partypancake8/froggy-control/motor/schematic-img/cl57t-v41-photo.jpg

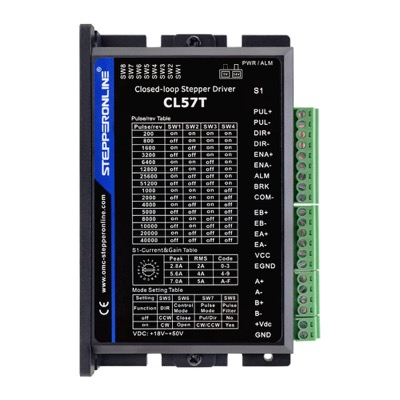
motor/schematic-img/cl57t-v41-photo.jpg
