partypancake8/froggy-control/model/exports/camsim/montage.png

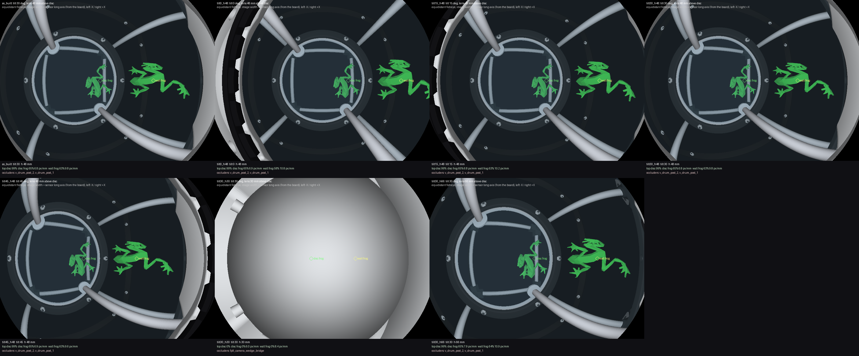
model/exports/camsim/montage.png
