partypancake8/froggy-control/model/cad/docs/ICD-V12.5.md

# Froggy V12.5 interface control addendum

2026-11-01. `assemblies/froggy_v12_5.py` is V12 (`froggy_v12.py`, frozen at 6105f2d) plus two items. Every row of
[ICD-V12.md](ICD-V12.md) stands except the ones below. Supersedes the S1.1 / S1.2 motor plate rows (6061 6 mm plate
64 x 120, Z -23..-17, M5 x 40 spacer bolts, motor face Z -23) and the S1.27 support block row ("Support": side guards,
"print bottom flat on bed"). Intents: I037 (slab), I038 (gusset).

| Interface | Nominal definition, mm |
| --- | --- |
| S1.2-V12.5 motor plate slab (I037) | `fp9_motor_plate`, PETG, one uniform 12 mm slab, Z -32..-20, 114 x 120 (X -57..57, Y -60..60): the aluminium plate's 64 x 120 footprint plus four tabs to X +-57 at Y +-(38..60). Top face Z -20 = the cross rails' underside, so the tabs bear flush on the rails. Motor pocket from below, Z -32..-25.5 (6.5 deep), X +-22.5, -Y wall Y 6.0, open past Y 60 (motor body 42.3 square + travel C 28.5..30.5 + 1.35 clearance); keyhole X +-12 into the 24 spindle hole. Every aluminium-plate opening kept: 24 spindle hole (0, 0), I035 belt channel 20 wide (X +-10, Y 0..30) with R 2 cusps, 24 pilot slot (0, 30) Y -1.5..+0.5, four 3.4 motor slots on the 31 square, four 5.5 spacer holes (+-21, +1), (+-21, -45), four 5.5 x 7 tab slots along X at (+-45, +-48). No lightening cuts, no supports. Mass 115.4 g at 100 % infill (90886 mm3 x 1.27); Bambu P2S slice 110.2 g, 2.6 h, 0 warnings. |
| Motor drop (I037) | MOTOR_DROP 2.5: motor face Z -25.5 (V12 -23.0), roof over the motor flange 5.5. Motor pulley NOT moved: Z -17.5..-1.5, its top flush with the shaft tip -25.5 + 24 = -1.5 (asserted in the build). Belt plane BD.BELT_Z -13.0 unchanged. D flat Z -16.5..-1.5 (shaft STEP), grub axis Z -5.0, 3.5 to the flat's tip end. |
| S1.1-V12.5 spacer stack | Plate A 6 + RAF 20 mm spacer + stock aluminium spacer 5 ID / 10 OD / 3 (the ICD-V12 deck hardpoint part, Filastruder; four, Z -20..-17) + slab 12 = grip 41. M5 x 50 ISO 4762 SHCS down from plate A, DIN985 nyloc 5 under the slab, 4 proud. |
| S1.33 slab tabs (new) | Four M5 x 18 ISO 7380 BHCS up through the 12 mm tab slots into 2020 drop-in T-nuts in the cross rails' bottom slots at (+-45, +-48); 4.9 into the T-nut (x 16 gives 2.9, under the 3.0 the joint check needs). |
| S1.2-V12.5 motor screws | Four M3 x 10 SHCS + 0.5 washer from the slab top (Z -20) through the 5.5 roof: 4.0 engaged in the 4.5 deep motor holes (x 12 gives 6.0, too long). |
| I035 belt clearance | BRepExtrema belt to slab 5.125 at C 28.5 / 30.0 / 30.5 (>= 3.0 asserted in the build). Motor body to pocket 1.35; lower spindle stack to slab 5.27; pilot boss to the 24 slot 0.27 (the aluminium plate's geometry). |
| Slab print | Z -20 top face DOWN on the bed (print_rotate 180 about X), pocket opening up; every face vertical or horizontal; 100 % infill PETG prototype, 3 walls. |
| Slab install | From inside the plinth, bottom panel off, after the cartridge is in the deck: at 114 wide the slab does not pass the 66 x 126 deck opening. 3 mm spacers on the hanging M5 x 50, slab + motor up, motor pulley into the belt loop, nylocs, tab screws, tension, M3 screws. |
| S1.27-V12.5 support block, gusset A (I038) | `fp12_roller_block` x 3 (print wrapper `parts/fp9_roller_block.py`). Envelope unchanged: block-local r 67.0..99.5, t +-17, Z 0..41 (world = local + 9). Base 4, outboard wall r 95.5..99.5 to world Z 50, R 1.5 top. Side guards replaced by two triangular gussets, t +-13.05..17 (4 thick, outer face flush with the base side): R 5 foot cove leaves the base top at r 71.0, straight hypotenuse lands at r 73.64 and meets the wall's inboard face at local Z 36.0 (55.7 deg), R 5 cove onto the wall. Coves: R 5 outboard wall to base, R 5 gusset inner face to base r 83..95.5 (run out R 5 -> 0 over r 83..78, >= 1.5 off the M4 heads' 7 OD), R 3 vertical gusset / wall corners, R 1 gusset top edges and the flush outline. Slot (centre Z 32.95 +- 2, 5.4 wide), M4 holes (r 76, t +-8) and wall top unchanged. Disc clearance 2.5 (gusset 2.916), tread clearance 1.0, slot margin above 12.35. Root section 444.4 mm2 (371.9 before, 1.19x). Mass 15.1 g. |
| Support block print (I038) | On its BACK: the outboard wall's r 99.5 face on the bed (one planar face, 1155 mm2), layers stack along r; no downward gusset face (0.0 deg overhang); only the two M4 holes bridge. Bambu P2S PETG, 3 walls, 25 % infill, supports off: 10.0 g, 38 min, 0 warnings. |
| Support block fasteners | Unchanged: 2 x M4 x 16 SHCS + DIN985 to plate A per block; M5 x 25 axle, head outboard. The M4 heads are 1.55 from the gusset inner face, so the gusset root beside them stays sharp (punch list). |
