partypancake8/froggy-control/model/cad/docs/ICD-V12.md

# V12 frame and flat-tread rim supports

2026-10-26. Supersedes S1.27/S1.28 and deck mounting stack; all V11 spindle and belt datums retained except S1.5, S1.6 and the belt plane, which spindle fix A (2026-10-28, I033) replaces below. Sawyer confirmed standard Ender wheels and supports using the flat outer running face. Motor family is confirmed 17HS19; exact encoder suffix remains to be checked.

| Interface | Nominal definition, mm |
| --- | --- |
| Wheel | Official Creality Ender-3 Rollers.step: POM wheel OD 24.10, plastic width 10.20, flat tread width 6.10. Two official 625pillow.step bearings, 5 ID / 16 OD / 5 width, centers +/-3 along axle; official 5 ID / 10 OD / 1 internal shim. Complete kit width 11. Purchase standard 4001070002 or dimensionally matching assembled wheel; current catalogue says D24 x 10.24, so incoming measurement is required. |
| Contact | Three horizontal radial axles at radius 89, azimuths 90/210/330 degrees, axle Z 32.95. Flat outer tread touches disc underside Z45 across radial band 85.95..92.05; disc edge R93 leaves 0.95 radial margin. V shoulders and wheel side faces are not contact surfaces. |
| Axle clamp | M5x25 ISO4762 screw, head outboard. 4 mm support wall + 1 mm precision washer + 11 mm assembled wheel + 1 mm precision washer + 5 mm DIN985 nyloc. Nominal 3 mm bolt protrusion. Washers 5 ID/10 OD/1, two per wheel, additional to the internal shim. Clamp inner races, not the POM body. |
| Support | PETG support base R67..99.5, width34, base4, wall4. Slot width5.4; center travel Z30.95..34.95. Side guards begin at +/-13.05, giving 1 mm nominal tread clearance. Existing 2xM4x16/nyloc mounting pattern (R76,t+/-8) retained. Print bottom flat on bed. Light stabilization contact only; load capacity and creep not qualified. |
| Adjustment | Axle screw removed for wheel insertion. Remove carrier to use full slot travel; above nominal, wheel intentionally intersects installed disc. Working setting is just contact with no forced preload. Verify free spin while holding nut during tightening. |
| Carrier countersinks | Four M4 hub screws use 90 degree included countersinks, 8.96 mm theoretical maximum top diameter over 4.5 mm clearance bore, maximum depth 2.23 mm from Z51. This supersedes the inherited 80 degree PETG-era recess. Model the supplier maximum head envelope: 8.96 mm theoretical diameter, 2.48 mm head depth, 2.5 mm socket. Finish the countersink to the actual supplied head flush, up to this maximum; smaller heads must not be sunk blindly to the maximum. Source: Accu SSK-M4-12-A2. |
| Metal hardpoints | Twelve stock 5 ID/10 OD/3 aluminum spacers replace acrylic in clamp paths: four under plate A, eight under corner clamp tabs. Plate/tab entire footprints relieved from deck skin with >=0.5 nominal planar clearance, retaining Z0..3 spacer and Z3 plate datum. Existing M5x14 screws retained. Plate A relief may join existing center opening; acrylic remains a nonstructural skin. |
| S1.5-V12 block fasteners | 2026-10-28, fix A (I033), supersedes S1.5 / interface-risks row 9. goBILDA 1614 to plate A: 4 x M4 x 12 ISO 7380 button head up from under plate A at (+-8, +-8), **no washers on either face** (a 9 OD washer under a head reaches r 6.81 and lifts the block 0.8). The block's M4 holes are tapped through its 16 length; 6 engaged. Heads Z 0.8..3.0 on r 11.31 (head 7.6 OD, inner edge r 7.51). BRepExtrema head gap to the nearest rotating solid, each rotating part swept 360 deg in 15 deg steps: 2.014 for all four (nearest: the top race shim, r 5.5, Z 2..3); the REX pulley hub top (Z -0.5) is further. Rule: FHCS/SHCS only if a button head comes within 1.0 of anything rotating. Never longer than M4 x 22 (the through tap lets the tip reach the hub clamp at Z 25.6). |
| S1.6-V12 shaft retention | 2026-10-28, fix A (I033), supersedes S1.6a/b/c-V11 / interface-risks rows 2, 4, 5, 17b, 17c. The 2920 collar is dropped from the model and the BOM. Block captured between the hub boss (Z 25, upper inner race) and a spacer column on the lower inner race: goBILDA 1522-0010-0060 race spacer (8.05 ID x 9.95 OD x 6.00) Z 3..9, through plate A's 16 hole with 3.0 radial clearance, then shim_count_nominal = 3 x goBILDA 2807-0811-1000 (8.00 x 11.0 x 1.00) Z 0..3, then the 3422 REX pulley hub up Z -18..0 whose two M5 set screws (axis Z -5.0, holes Z -7.5..-2.5, 8.0 below plate A's underside) are the lower axial stop. Shim rule: measure then choose. The set screws and the hub pinch bolts are tightened on the bench: in the deck the 2020 rails (Z -20..0) block every horizontal key approach at Z -5 (ray test, 36 azimuths). Shaft 72.00 at Z -24.8..47.2, 0.2 (0.1..0.3) proud of the hub pilot so the top washer (Z 47.2..48.2) bears on the shaft only. Lower backup: second 1522 at Z -24.8..-18.8 on the lower 12 OD washer (Z -25.8..-24.8), 0.8 under the pulley, never clamped; the former 2807 backup shim no longer fits and is dropped. Remove the factory e-clip before assembly: its groove (Z -21.6..-20.8) sits inside the backup spacer's 8.05 bore, and a fitted 12.3 OD clip would stop the spacer. |
| Spindle stack (fix A) | Bottom to top, Z from..to (height source): M4 x 8 BHCS + 12 OD washer -25.8..-24.8 (ISO 7093, off the shaft end); 1522 backup spacer -24.8..-18.8 (6.00 STEP); gap -18.8..-18.0 (0.8); 3422 REX pulley -18.0..0.0 (18.0 STEP, hub up, tooth band -16.5..-9.5, groove centre -13.0, set screws -5.0); 3 x 2807 shim 0.0..3.0 (1.00 STEP each); 1522 race spacer 3.0..9.0 (6.00 STEP; plate A is 3..9); 1614 block 9.0..25.0 (16.0 STEP; inner races at its end faces); 1313 hub 25.0..47.0 (22.0 STEP, pilot top 47.0); shaft proud 47.0..47.2; upper washer 47.2..48.2 and M4 x 8 BHCS head to 50.4 (carrier top 51). Sum on the shaft: 6 + 0.8 + 18 + 3 + 6 + 16 + 22 + 0.2 = 72.0. Belt plane Z -13.0 (was -12.75). Motor pulley slid 0.25 down on the 5 mm D shaft to Z -17.5..-1.5, grub axis Z -5.0 on the D flat Z -14..+1 (7.5 below and 4.5 above the M3 thread); centre distance 30.0 and the motor plate slots unchanged; tension travel only +1.0 belt path. Motor turned 180 deg about its axis: lead glands face +Y, away from the lower end screw. |
| S1.23-V12 LED driver | 2026-10-28, intent I034 (follows I032), supersedes ICD.md S1.23. REMOVED: v_led_driver (IR LED driver board), its two M2.5 x 6 F-F standoffs (v_drv_standoff_m2p5_1/_2), the two M2.5 x 10 SHCS (j_s1_23_driver_standoff_1/_2) and the carrier disc's two dedicated 2.7 holes at (0, -48 +- 9.5). The Pi's four 2.7 holes (S1.18) stay. Rotor CG offset from the build's mass properties: 0.05 mm before, 0.11 mm after (turning mass 1.535 -> 1.530 kg); no rebalance needed, S1.19 bank position unchanged. |
| S1.29 LED ring | 2026-10-28, intent I032, supersedes ICD.md S1.29 (Spinel IRXS10 850 nm IR ring removed). v_led_ring_ws2812: WS2812B 16 x 5050 white ring, Adafruit NeoPixel Ring 16 footprint, board 44.45 OD / 31.75 hole / 1.6, LEDs 5.0 x 5.0 x 1.7 on r 19 (3.3 overall), read from the vendor STEP (vendor/electronics/ws2812_ring_16, Adafruit_CAD_Parts, MIT); bought part: Amazon Sparkleiot 5 pack B0C77XPKSL (45 OD, 32 hole, same footprint) or Stemedu B0BY8Z9L92. Coaxial with the UC-261 lens, LEDs along the optical axis, board underside 4.3 in front of the camera board underside (the IR board's plane); the 14 lens barrel passes the 31.75 hole. On fp9_camera_wedge_bridge: collar recess 45.0 dia x 3.3 deep (was 52.4 x 3.5), 5050 tops flush with the collar top, 57 square collar, 37 square camera pocket, 25 wide ribbon slot on +Y and 3 silicone dots unchanged. Electrical (I034): 3 wires straight to the Pi, no driver board: ring 5 V to the Pi 5 V pin, GND to Pi GND, DIN from GPIO18 (PWM) through a 74AHCT125 level shifter (3.3 V to 5 V) and a 330 ohm series resistor at DIN, with 1000 uF across 5 V / GND at the ring; the 74AHCT125, resistor and capacitor are a wiring note mounted on the Pi side, not modelled (Adafruit 1787 is the bare DIP chip, no breakout STEP in Adafruit_CAD_Parts). About 290 mA white with brightness capped near 30 % (full white up to 960 mA). Must not occlude the top disc or the frogs in camsim. |
| S1.10-V12 drum tube | 2026-10-28, intent I036, supersedes the tube numbers in ICD.md S1.9 to S1.12 and S1.32 (rows updated in place). s_drum_tube: Rebower clear cast acrylic 145 ID x 150 OD x 14 in (Amazon), 150.0 OD x 2.5 wall, bore 145.0, cut to TUBE_H 140 (unchanged; one tube gives two cuts); replaces the 152.4 x 3.2 Plastic-Craft tube, unavailable. OD tolerance unknown: measure the OD on arrival, then print both seats at measured OD + 0.6 (0.3 radial). fp9_tube_seat_bottom r 75.3..90 x 6 and fp9_tube_seat_top r 75.3..93 x 6, both bores 150.6 (were 153.0), outer sizes, heights and the r 83 hole circle unchanged (bottom seat wall between bore and counterbore now 3.7, was 2.5). lp_ring_b ID 144 (was 146): the tube foot r 72.5..75 sits fully on aluminium; the switch nut (r 70.6) and port nut (r 70.2) stay inside the bore; lobes and post holes unchanged. lp_ring_top bezel ID 147 unchanged (sized by the 9.5 hole margin, not the tube). Drum posts r 66, body r 61..71: 1.5 clear of the bore r 72.5 (was 2.0). Wall-frog placeholder follows the outer wall (r 75.0 + 0.3). Camsim as built: top disc 0.987, disc frog 0.649, wall frog 0.631 (unchanged to 3 places). |
| Rotor power budget | 2026-10-28, I034: 400 mA Pi Zero 2 W (Wi-Fi streaming) + 150 mA UC-261 camera + 300 mA WS2812 ring allowance = 850 mA at 5 V (4.25 W) from the 19.24 Wh Anker 321 at 85 % conversion, about 3.8 h. No 12 V rail and no boost on the rotor. |

Sources: [official wheel CAD](https://github.com/Creality3DPrinting/Ender-3/tree/88c7758cea9d0d00a54fdb238bedb3b33425f409/Ender-3%20Mechanical); [Creality kit](https://mvip.creality.com/en/goods/goodsDetail/840); [metal spacers, packs of five](https://www.filastruder.com/products/m5-spacers-3mm-tall-10mm-od).

The wheel STEP is manufacturer design evidence, not certification that every generic Ender wheel matches. The two bearing inner faces must seat on the 1 mm internal shim without locking the wheel. Finite tread width produces differential sliding on a rotating disc: inspect heat/wear after low-speed unloaded testing. Motor pulley details, load ratings, frame profile compatibility, belt tension, actual tolerances, print strength, and assembled runout remain physical qualification items.
