partypancake8/froggy-control/model/exports/camera_view.png

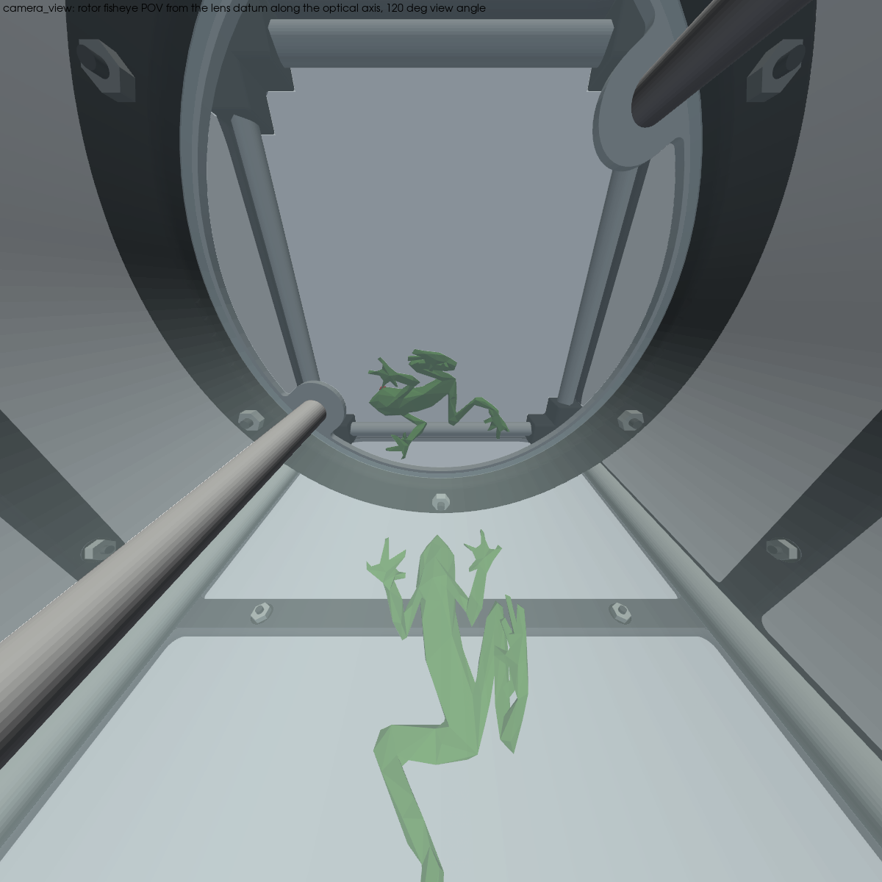
model/exports/camera_view.png
