partypancake8/froggy-control/model/exports/camsim/as_built.png

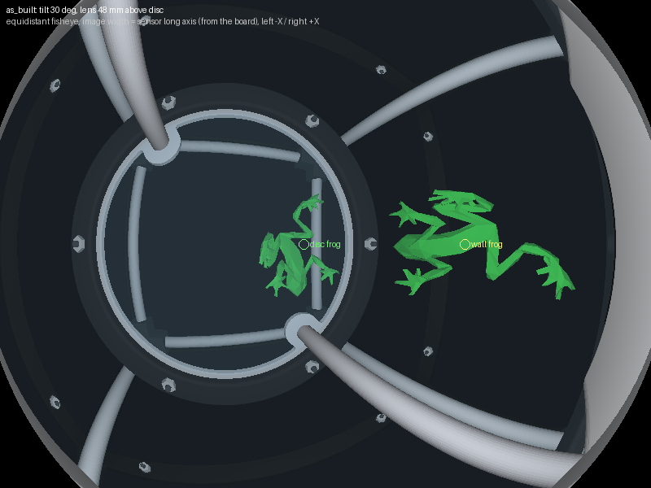
model/exports/camsim/as_built.png
