partypancake8/froggy-control/model/exports/camsim/as_built_labels.png

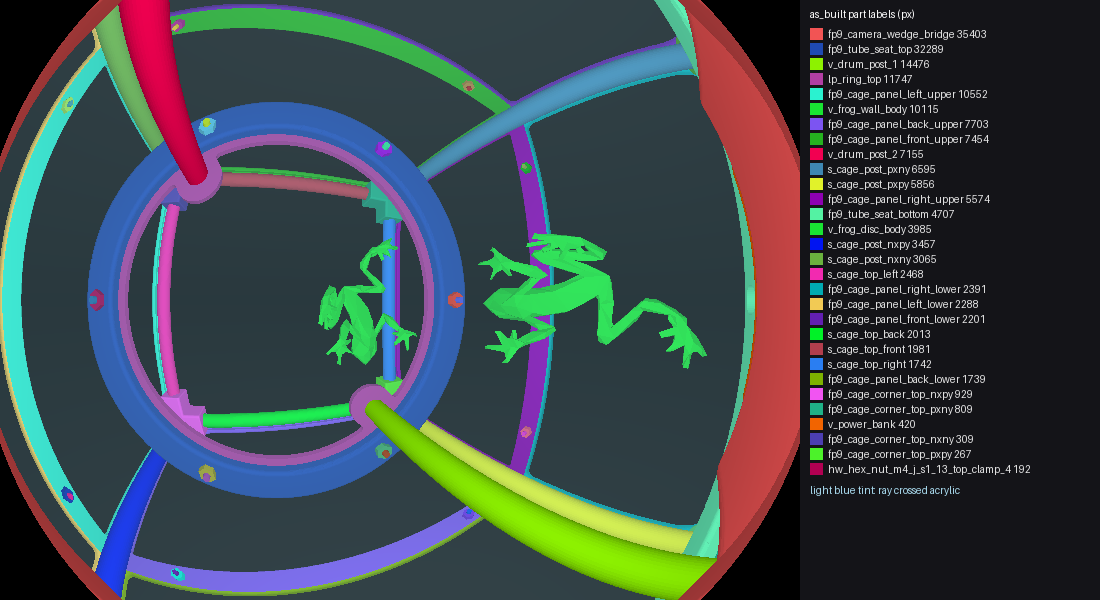
model/exports/camsim/as_built_labels.png
