partypancake8/froggy-control/model/exports/camsim/tilt0_h48.png

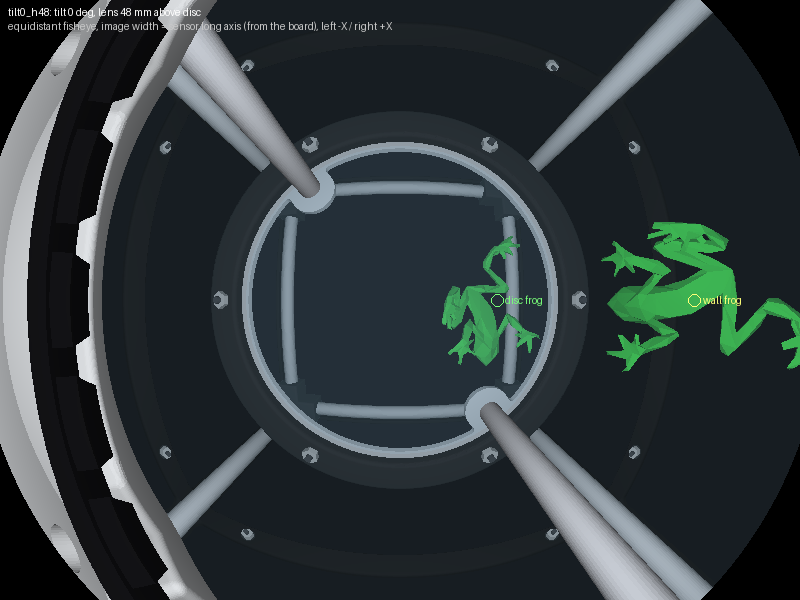
model/exports/camsim/tilt0_h48.png
