partypancake8/froggy-control/model/exports/camsim/tilt15_h48.png

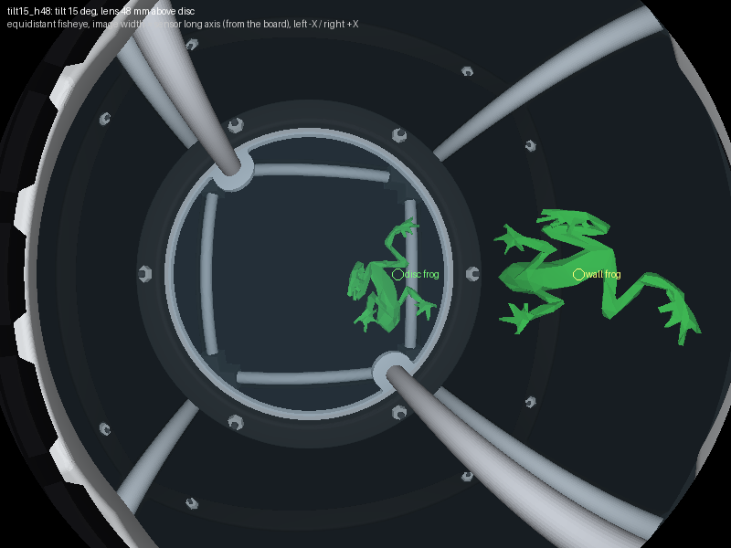
model/exports/camsim/tilt15_h48.png
