partypancake8/froggy-control/model/exports/camsim/tilt15_h48_labels.png

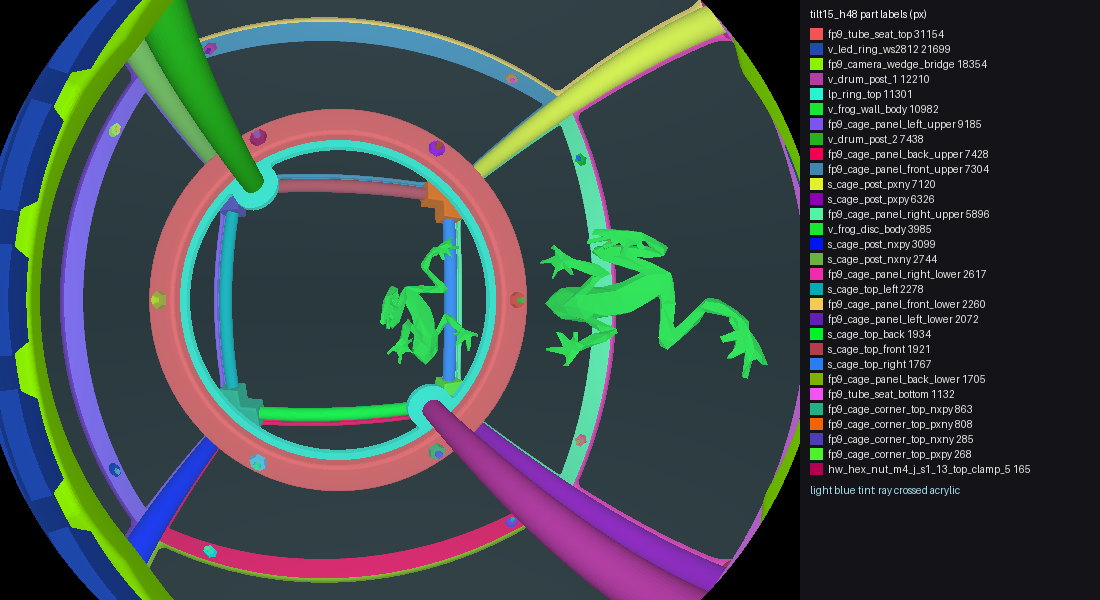
model/exports/camsim/tilt15_h48_labels.png
