partypancake8/froggy-control/model/exports/camsim/tilt30_h30.png

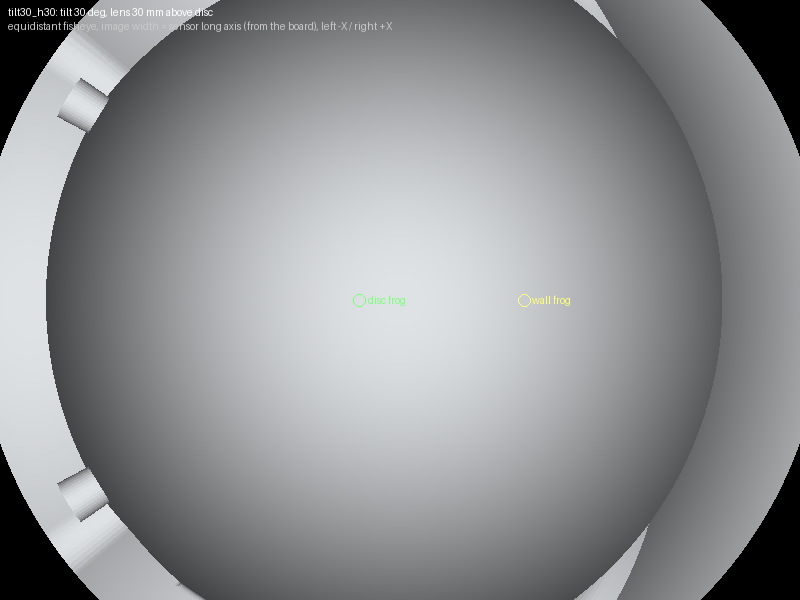
model/exports/camsim/tilt30_h30.png
