partypancake8/froggy-control/model/exports/camsim/tilt30_h30_labels.png

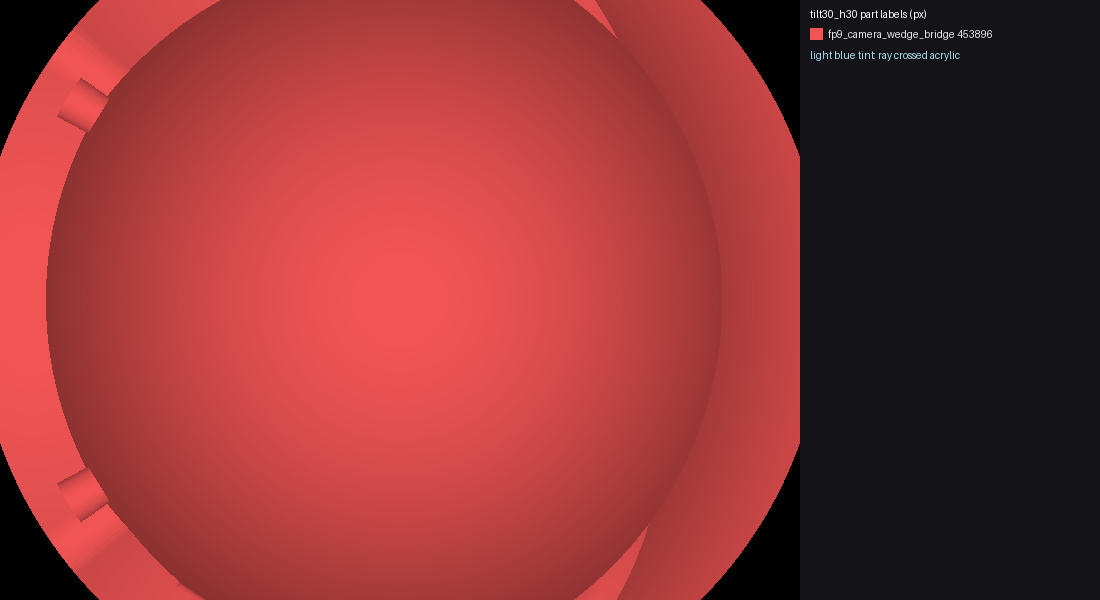
model/exports/camsim/tilt30_h30_labels.png
