partypancake8/froggy-control/model/exports/camsim/tilt30_h66.png

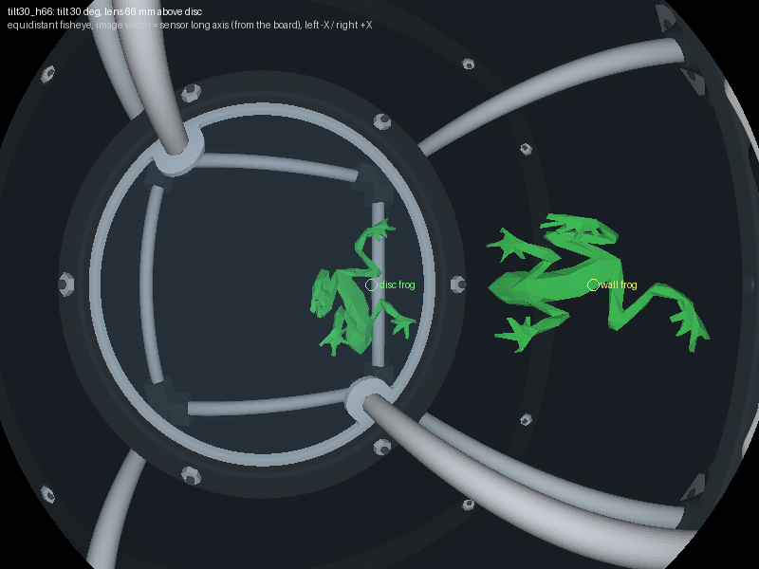
model/exports/camsim/tilt30_h66.png
