partypancake8/froggy-control/model/exports/camsim/tilt30_h66_labels.png

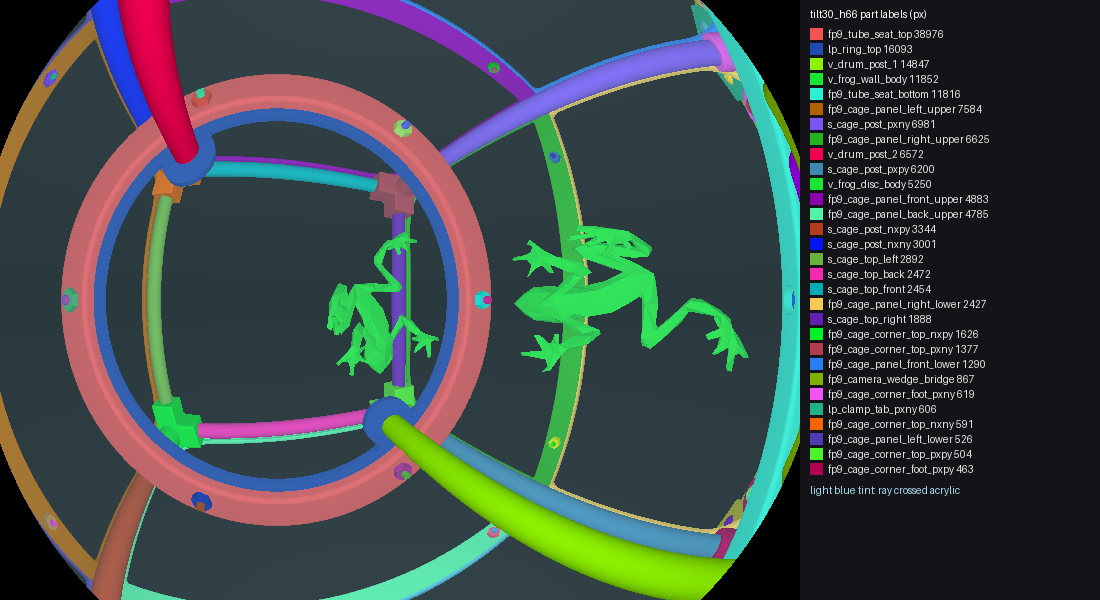
model/exports/camsim/tilt30_h66_labels.png
