partypancake8/froggy-control/model/exports/camsim/tilt45_h48.png

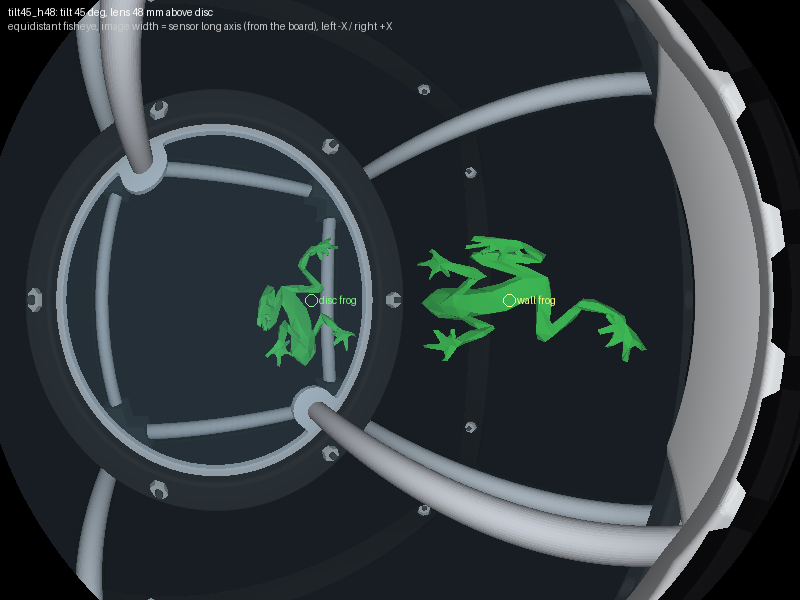
model/exports/camsim/tilt45_h48.png
