partypancake8/froggy-control/motor/schematic-cl57t.png

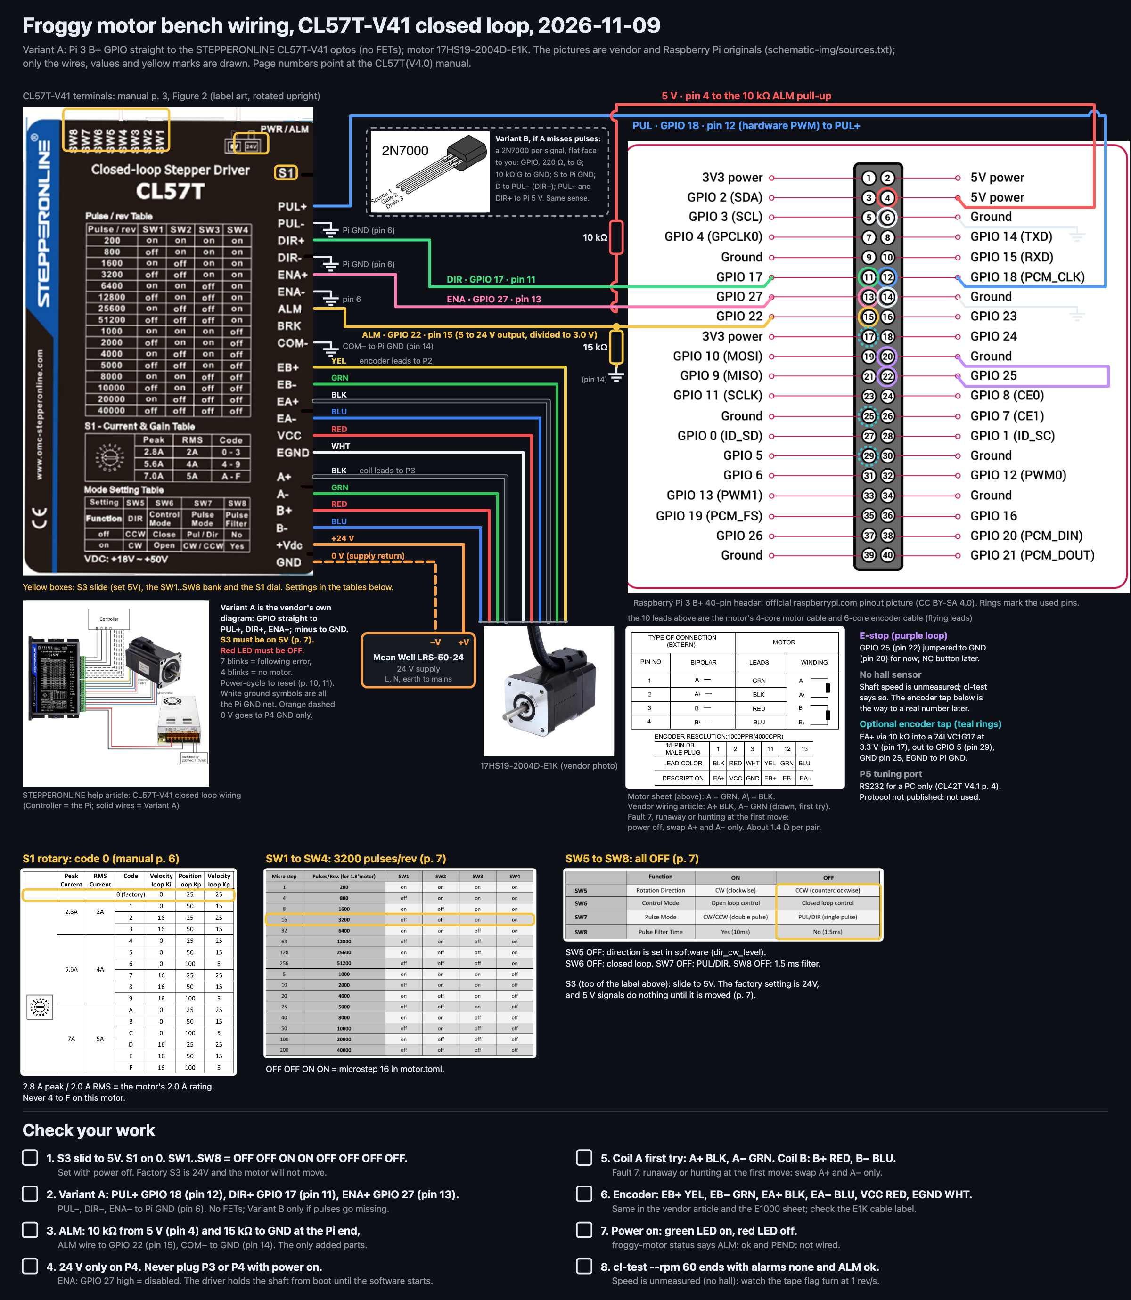
motor/schematic-cl57t.png
