partypancake8/froggy-control/motor/schematic-img/2n7000-to92.png

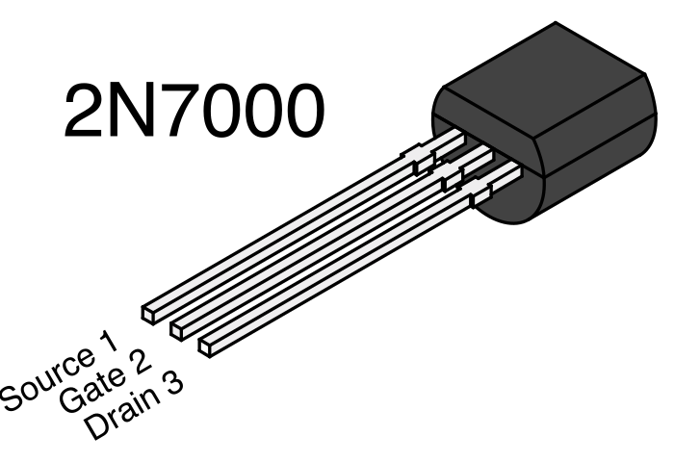
motor/schematic-img/2n7000-to92.png
