partypancake8/froggy-control/motor/schematic-img/17hs19-2004d-e1k-photo.jpg

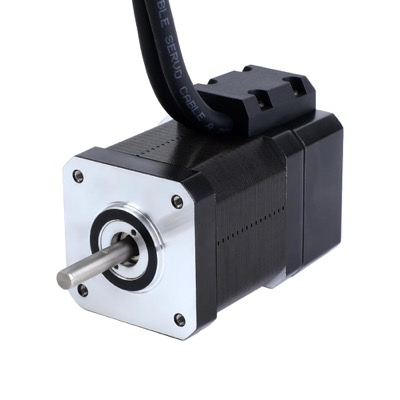
motor/schematic-img/17hs19-2004d-e1k-photo.jpg
