partypancake8/froggy-control/motor/schematic-img/17hs19-2004d-e1000-leads.png

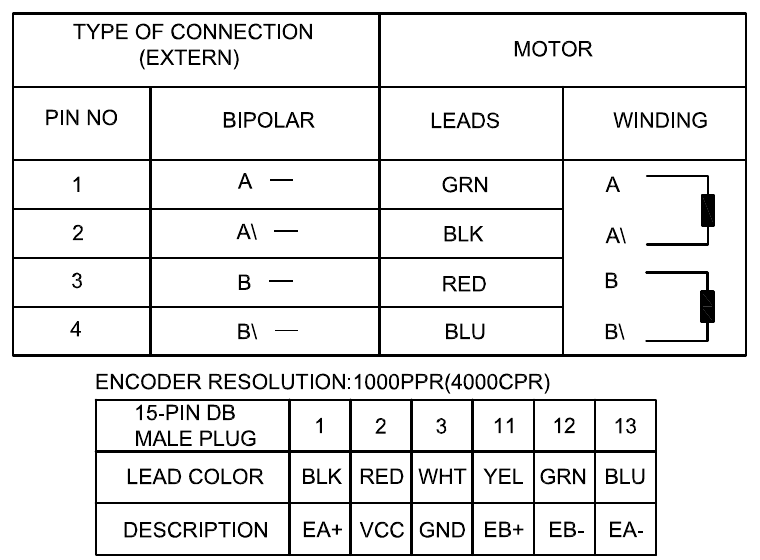
motor/schematic-img/17hs19-2004d-e1000-leads.png
