partypancake8/froggy-control/motor/schematic-img/cl57t-label-fig2.png

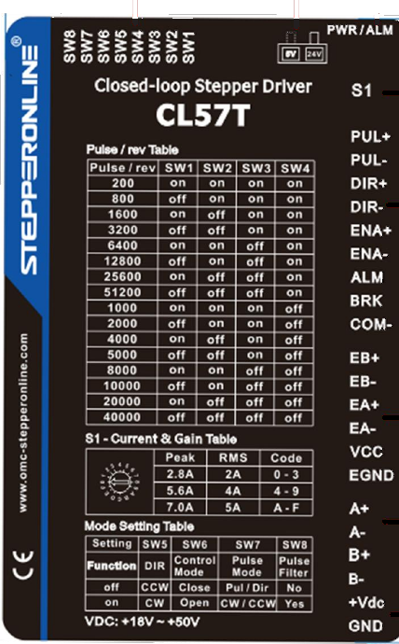
motor/schematic-img/cl57t-label-fig2.png
