partypancake8/froggy-control/motor/schematic-img/cl57t-microstep-table.png

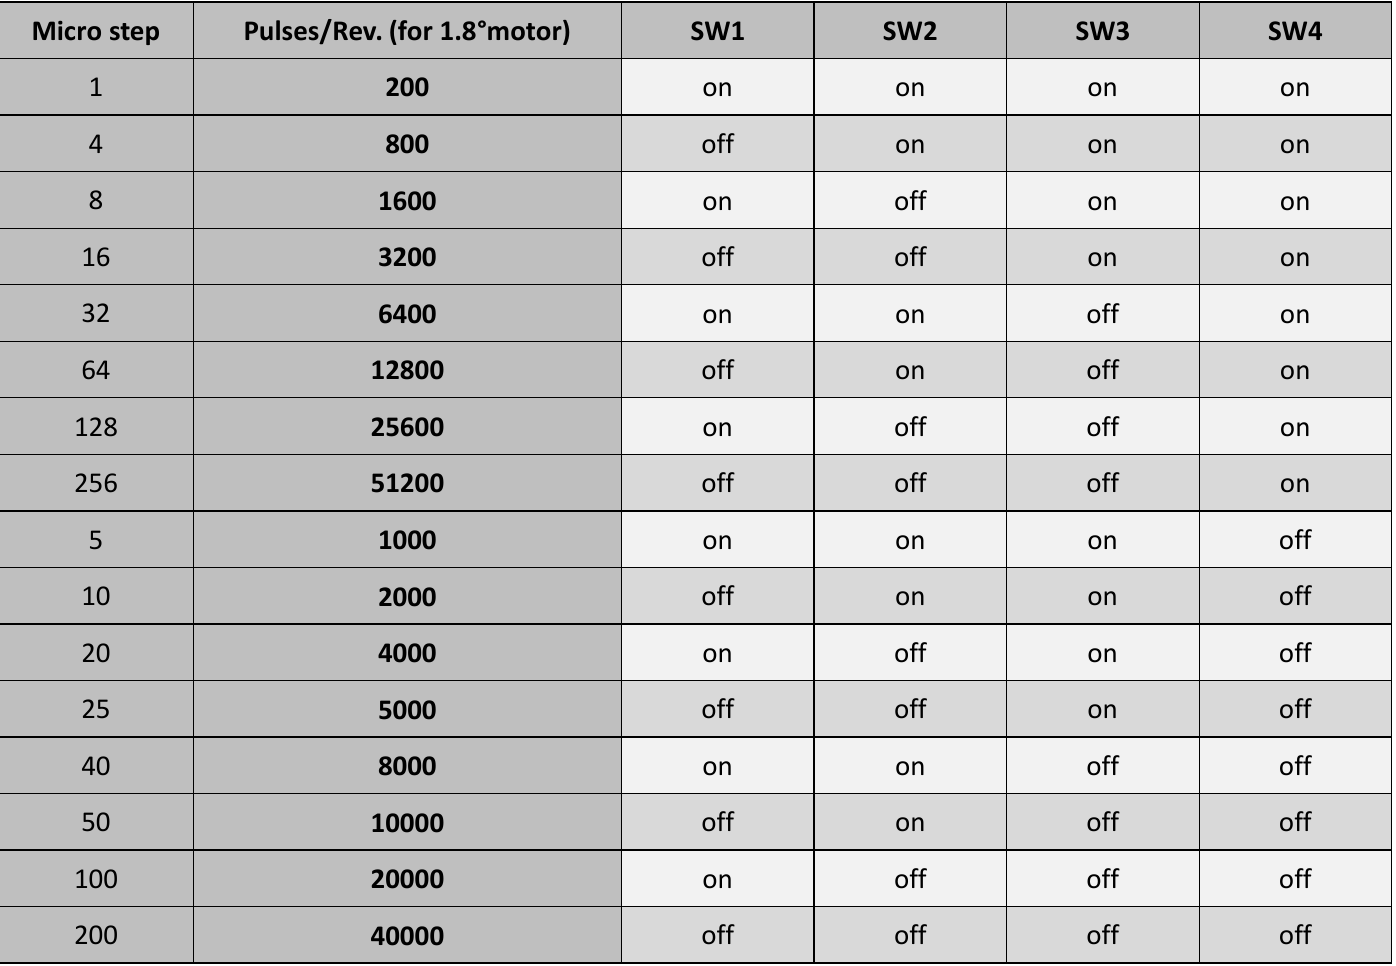
motor/schematic-img/cl57t-microstep-table.png
