partypancake8/froggy-control/motor/schematic-img/cl57t-mode-table.png

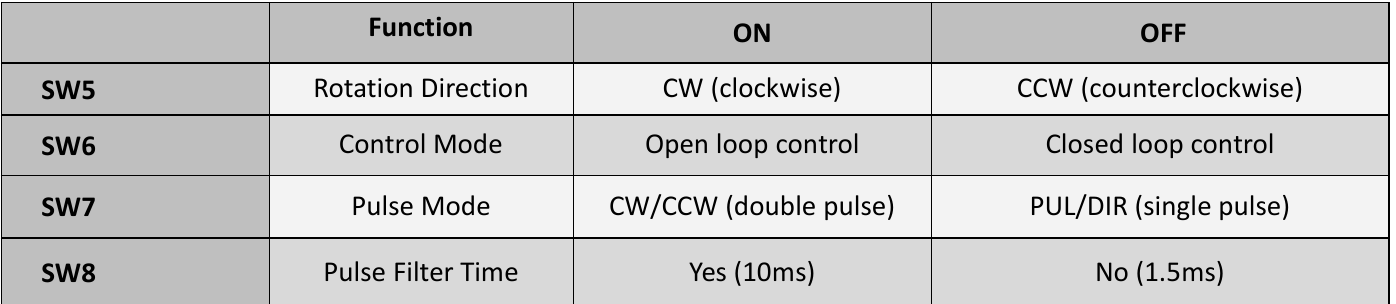
motor/schematic-img/cl57t-mode-table.png
