partypancake8/froggy-control/motor/schematic-img/cl57t-s1-table.png

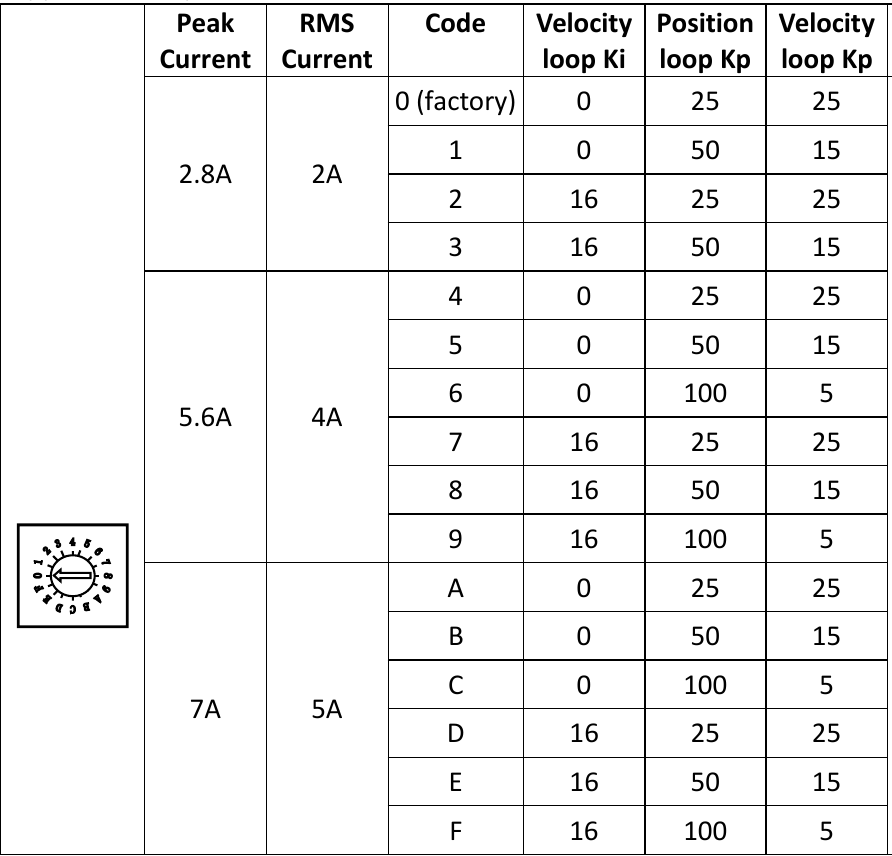
motor/schematic-img/cl57t-s1-table.png
