partypancake8/froggy-control/motor/schematic-img/rpi-gpio-pinout.png

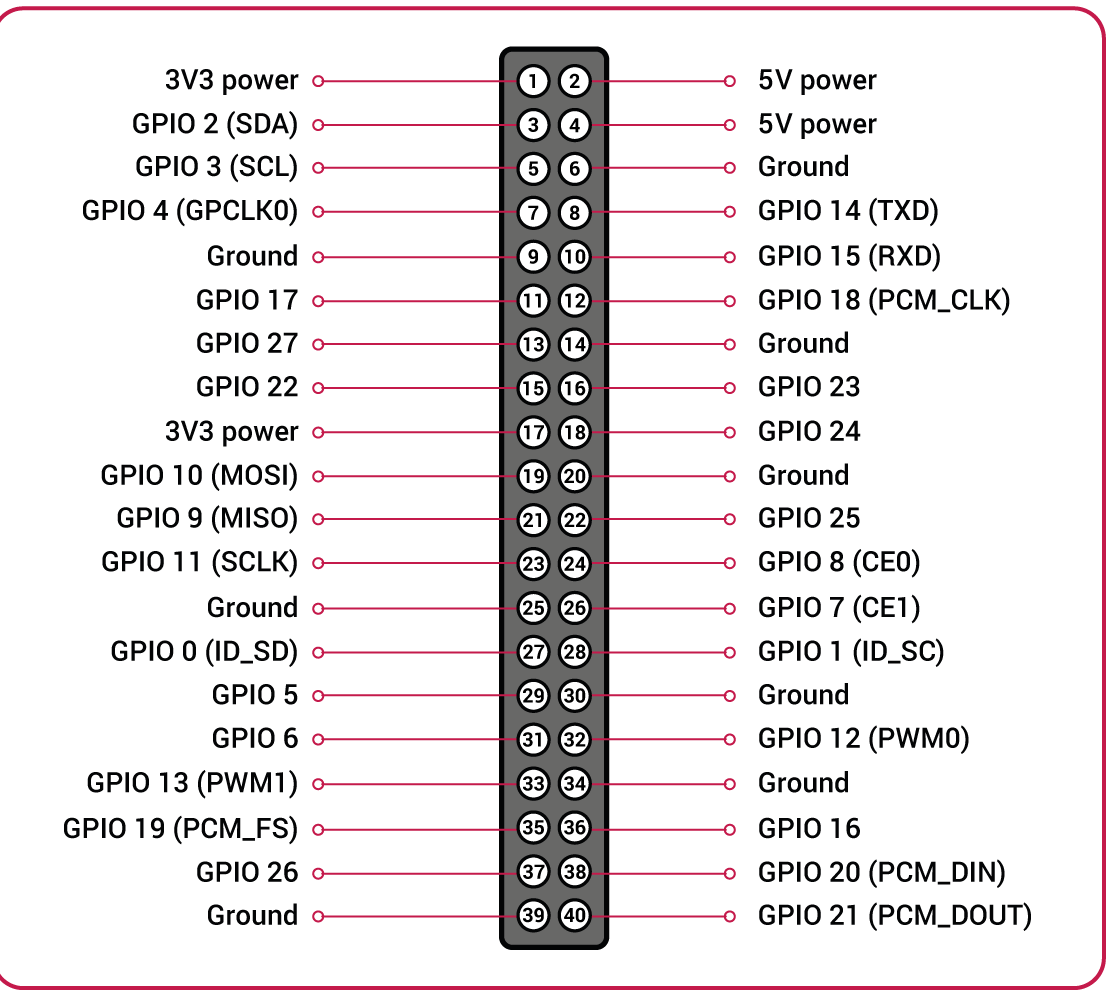
motor/schematic-img/rpi-gpio-pinout.png
