partypancake8/froggy-control/motor/schematic-img/vendor-article-motor-table-grn-blk-red-blu.png

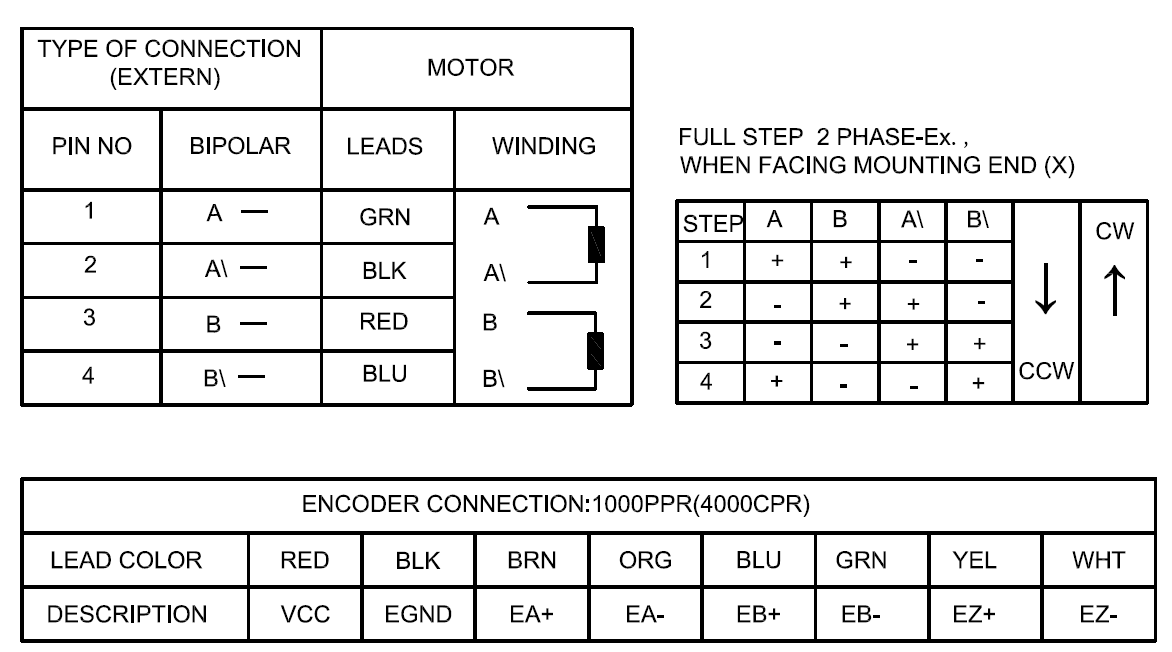
motor/schematic-img/vendor-article-motor-table-grn-blk-red-blu.png
