partypancake8/froggy-control/motor/schematic.png

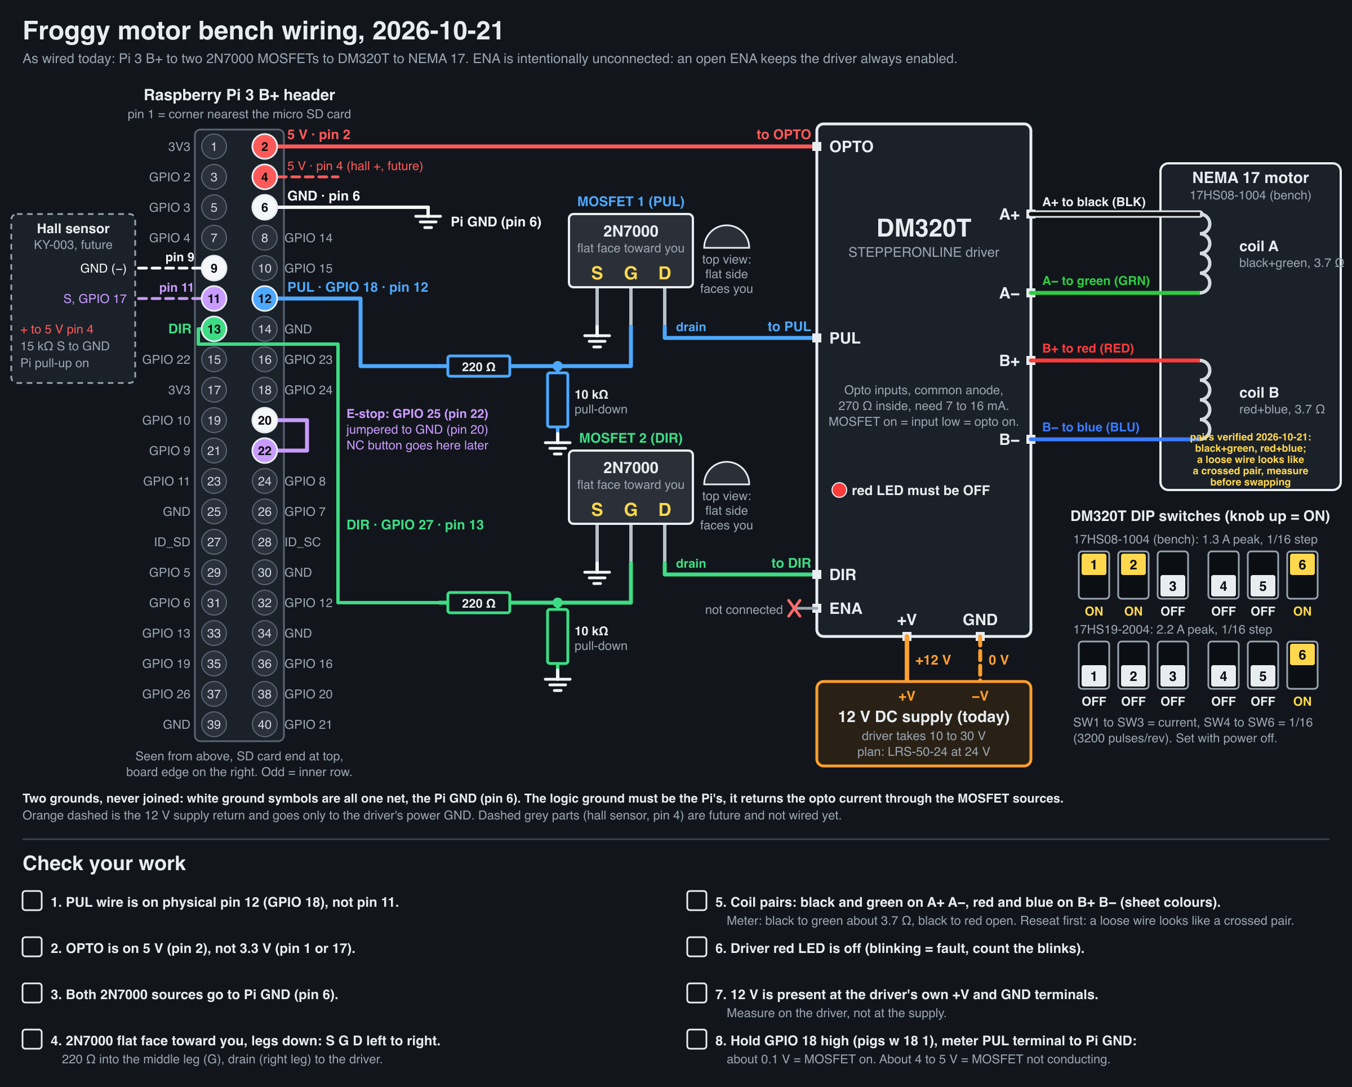
motor/schematic.png
