partypancake8/froggy-control/(list of files, cad)

Other CAD files:
model/exports/froggy_v12_5.step
model/exports/froggy_v12_5.stl
