partypancake8/froggy-control/model/cad/docs/V12.5-ASSEMBLY.md

# Froggy V12.5 frame and drive assembly

**V12.5 (2026-11-01, `assemblies/froggy_v12_5.py`) = V12 plus two items; read [ICD-V12.5.md](ICD-V12.5.md) first.**
(1) I037: P02 is now `fp9_motor_plate`, a printed PETG 12 mm slab (Z -32..-20, 114 x 120) with four tabs bolted up into
the cross rails' bottom slots; the motor drops 2.5 (face Z -25.5); spacer bolts are M5 x 50 with four extra 3 mm
spacers; four M5 x 18 BHCS + drop-in T-nuts at the tabs; the slab goes on from inside the plinth after the cartridge is
in. (2) I038: the three R02 roller blocks are gusset A, printed on their back. Everything below that these two items do
not touch is V12 unchanged.

Revision 2026-10-28 (order review and printed testing build added; geometry unchanged from 2026-10-26, CAD at 4a4591a). Millimetres throughout. This packet covers the structure in Sawyer's reference image, plus its deck skin, bare carrier disc and Hall target interface. The full V12 machine is retained for interference checks. The populated rotor, cage, plinth sides/bottom, feet and control electronics are outside this procurement list. Four cage-owned T-nuts assigned to the frame module are excluded from this list. Do not mistake this subassembly packet for a complete-machine shopping list.

**Status: procurement cleared 2026-10-28; physical qualification remains open.** All 10 drive and drum items on the purchase list match the CAD and are cleared to order (see Order review 2026-10-28). Plate A, the motor plate and the carrier disc are being printed in PETG for testing; 6061 aluminium stays the final spec. Nothing here is a load, RPM or torque approval. The generated PDF and validation JSON give actual check results. No approved loaded RPM, belt tension or universal fastener torque is established by this packet. The constraints below are specific unresolved design inputs, not optional signoff language.

## Order review 2026-10-28

Fresh build at commit 4a4591a: `bin/cad build froggy_v12` ok, 468 components in the full machine, 151/151 joints ok, 0 interference pairs (109278 pairs checked), mass 6.62 kg. The 468 is the whole machine; this packet's procurement scope is the 205 components in `component-map.csv`. Evidence: `cad-review.md (a local review note, not in this repo)` and `listings.md`.

Every item on `purchasing/hypothetical-purchases.csv` was checked against the placed CAD. All 10 are cleared to order. Supplier rule (2026-10-28): Amazon or goBILDA only. So the motor pulley (D07) is the KR GT2 20T 5 mm bore 5-pack (Amazon B078Z6YZCY) and the belt (D08) is the RobotDigg 100-2GT-6 100 mm 50T 6 mm 10-pack (Amazon B07P5CX5CD). The CAD keeps the Olimex pulley geometry as its assumption.

| # | Item | CAD value | Verdict |
| ---: | --- | --- | --- |
| 1 | Acrylic tube, Rebower 145 ID x 150 OD x 14 in (Amazon B0CYHDLWQY; replaces the unavailable 6 in OD tube, I036) | Drum 150 OD x 2.5 wall x 140 long; seat bores 150.6; ring B ID 144 | ORDERED 2026-10-28 ($28.29). Cut 140 square; one 14 in tube gives 2 drums (1 + 1 spare). Measure the OD at three heights before printing the seats, then print both seat bores at the largest measured OD + 0.6. |
| 2 | goBILDA 1614-0016-4008 pillow block | 31.95 OD, 16 long, Z9..25; bearings 15 OD x 5 at 11 centres; 4 x M4 on the 16 square | ORDER. Matches the vendor sheet. Tapped depth and bearing ratings still open. |
| 3 | goBILDA 1313-1632-4008 Hyper Hub | Z25..47, 22 overall, 0.5 boss on the upper inner race, pilot flush with shaft end | ORDER. Still used: carrier mount and upper axial stop. |
| 4 | goBILDA 2106-4008-0720 REX shaft, 72 mm | Z-25..47 = 72.0 | ORDER. The stack needs exactly 72.0, zero spare. The e-clip groove (Z-21.8..-21.0) sits inside the 1522 spacer; the e-clip is not used. |
| 5 | goBILDA 2920-0001-4008 collar, 2-pack | Z0.5..9.0, boss up on the lower inner race | ORDER. Lower axial stop; one used, one spare. |
| 6 | goBILDA 3422-4008-0020 20T GT2 REX pulley | Z-17.75..0.25, hub up, groove centre Z-12.75, pitch dia 12.732 | ORDER. Belt has 0.5 per side inside the flanges. |
| 7 | Motor pulley 20T GT2, 5 bore (reviewed as Olimex GT2-5T20-6MM; now bought as the KR 5-pack, Amazon B078Z6YZCY) | Z-17.25..-1.25 on the motor shaft, full 16 engagement, grub on the D flat | ORDER. Hub, flange and grub dimensions are the Olimex modelled assumptions; measure the KR pulley hub and flanges on arrival. |
| 8 | GT2 100 mm belt, 50T closed loop, 6 wide (now RobotDigg 100-2GT-6 10-pack, Amazon B07P5CX5CD) | Centre distance 30.0; L = 2C + pi d = 60.0 + 40.0 = 100.0 | ORDER. Slot travel 28.5..30.5 covers belt paths 97..101. DigiKey had only 2 in stock, so an Amazon GT2 6 mm 100 mm closed loop is the practical source. |
| 9 | goBILDA 1522-0010-0060 spacer, 6 mm | Z-25..-19, 8 ID x 10 OD | ORDER. Lower backup retainer; one used. |
| 10 | goBILDA 2807-0811-1000 shim, 1 mm | Z-19..-18, 8 ID x 11 OD | ORDER. Leaves 0.25 to the pulley; 12-pack lets the stack be re-picked from measurement. |

Shaft stack check: spacer 6 + shim 1 + gap 0.25 + pulley 18 + gap 0.25 = 25.5 from the lower shaft end to the collar face. Collar 8.5 + pillow block 16 + hub 22 brings the total to 72.0. The end washers and M4x 8 screws sit outside the shaft ends. Nominal axial play at the block is zero by design and is set on assembly with the hub and collar screws, checked with an indicator. **Superseded 2026-10-28 by spindle fix A (I033):** the 2920 collar is dropped; the stack is now in the Spindle and motor assembly sequence below and in ICD-V12.md S1.6-V12.

Also needed, not on the purchase list (drive and drum interface):

- P01 plate A, P02 motor plate and P05 carrier disc (6061 final; PETG for the testing build below).
- 4 x RAF M0669-5-AL 20 mm spacers, 4 x M5x 40 SHCS and 4 x M5 DIN985 nylocs for the cartridge stack.
- 4 x M3x 10 SHCS and 4 x 0.5 mm M3 washers for the motor.
- 4 x M4x 12 BHCS for the pillow block and 4 x M4x 12 ISO10642 FHCS for the carrier.
- 2 x M4x 8 BHCS and 2 x M4 ISO7093 12 OD washers for the shaft end retainers.
- 4 x M5x 14 BHCS, 4 x M5 T-nuts and 4 x 5/10/3 aluminium deck spacers for the cartridge to cross rails.
- Drum: 2 x fp9 tube seats (PETG), clear RTV silicone, 2 x M5 10 x 140 drum posts with M5x 16 studs and M5x 14 top screws, ring B and top bezel (3.175 6061), 186 top disc, 6 x M4x 10 and 6 x M4x 18 with M4 nuts.
- Belt tension: no hardware beyond the slots; a tension method from the belt supplier is still needed.

Open (ds) items, still to validate:

- Motor pilot: CAD slot uses 24.0; the motor drawing gives a 22 boss (STEP root fillet 23.5). Test-fit the real motor.
- Motor pulley hub, flange, tooth band and grub dimensions are assumed (Olimex model); measure the KR pulley on arrival.
- Pillow block M4 tapped depth (6 mm engagement assumed) and bearing radial and axial ratings; motor radial load limit.
- Motor 17HS19-2004D-E1K: shaft 24 +/-1, D flat 15 from the tip. Validate on the in-hand unit.
- Acrylic tube OD tolerance and ovality; the 0.3 mm radial seat clearance assumes the nominal 150.0 OD in the 150.6 seat bores. Print the seats only after measuring the tube (largest measured OD + 0.6).

Known stale code comment: the docstring at `assemblies/froggy_v12.py:728` says the e-clip groove sits in the REX pulley. The model puts it inside the 1522 spacer (Z-21.8..-21.0). The comment is harmless and is left as is.

## Testing build: printed plates

Plate A (P01), the motor plate (P02) and the carrier disc (P05) are being printed in PETG for testing (intent I031, open). This is the testing build only. 6061 aluminium remains the final spec for all three, and the CAD, DXF and machining files are unchanged. The printed parts come from the same V12 STEP files with no geometry changes. Files and slice results: `manufacturing/v12-frame-drive/fabrication/printed/` (`slice-report.md`, `.stl` for the makerspace form, `.3mf` with the final profile).

Profile: PETG, 5 walls, 100 % infill, 0.2 mm layers, printed flat on the makerspace printers and Sawyer's Bambu P2S. Every slice had 0 slicer warnings and no support.

| Part | Print time | Filament |
| --- | ---: | ---: |
| Plate A (lp_plate_a) | 2h 26m | 125.8 g |
| Motor plate (lp_motor_plate) | 1h 01m | 47.0 g |
| Carrier disc (lp_carrier_disc) | 3h 32m | 188.5 g |
| Total | about 7h 00m | 361 g |

Post-print drill and tap list:

| Part | Holes | Action |
| --- | --- | --- |
| Plate A | 2 x 2.5 M3 pilots | Tap M3 by hand, or open up for M3 heat-set inserts. |
| Plate A | 4 x 4.3 pillow-block | Run a 4.3 drill through to clear elephant foot. |
| Plate A | 8 x 5.5 frame and motor-support, 6 x 4.5 wheel-support | Clear with same-size drills; screws must pass freely. |
| Plate A | 16 centre | Check spindle clearance, deburr. |
| Motor plate | 4 x 5.5 support holes | Clear with a 5.5 drill. |
| Motor plate | 24 spindle access, 24 pilot slot, 20 wide belt slot joining them, 4 x 3.4 motor slots | Test-fit the motor boss and M3 screws; file slot faces if tight. |
| Carrier | 6 x 3.3 on R83 | Tap M4. |
| Carrier | 2 x 4.2 on R66, 4 x 4.2 on R80 | Tap M5. |
| Carrier | 4 x 4.5 countersunk hub holes | Clear with a 4.5 drill; check the ISO10642 heads sit flush; do not deepen the cone. |
| Carrier | 2 x 6.1 magnet holes | Test-fit the 6 x 3 magnets, ream to 6.1 if tight. |
| Carrier | 14.3 centre, 3.4 camera, 2.7 Pi/driver | Clear with same-size drills. |

Testing build caveats:

- Plate A has only a 1.16 mm web between each 4.3 pillow-block hole and the 16 mm centre hole. That is about three extrusion lines and the first place to crack. Light torque, and inspect after the first runs. **No washers under the four pillow-block screw heads on either face** (fix A, I033): a 9 OD washer under a head reaches r 6.81 and lifts the block; the heads must stay clear of the spinning race shims.
- Keep M4 screws into or through PETG to about 0.5 to 1 N m (9 mm OD washers only where no rotating part is near; never under the pillow-block heads). This is a testing-build limit for plastic, not an approved fastener torque.
- A NEMA 17 case can run near PETG's softening point (glass transition about 80 C). Check case temperature on the bench.
- PETG creeps faster when warm: re-tension the belt after a warm run, and recheck screw preload after the first spin-ups.
- PETG is about 1/30 as stiff as 6061, so the bearing can tilt more under rotor imbalance. Treat any spin data from the printed plates as testing data, not qualification of the aluminium build.

## Revision and load path

V12 keeps the V11 pillow block, Hyper Hub, 72 mm REX shaft, two 20T pulleys, 100 mm belt and 17HS19 motor arrangement. The former 8 mm-bore polyurethane rim wheels are replaced by standard Ender POM wheel assemblies on horizontal M5 axles. Their **flat outer treads** contact the underside of the disc. The V shoulders and bearing side faces do not support the disc.

Three supports are revised for the larger, wider wheels and 5.4 mm axle slots. Their original plate-A mounting holes remain. Stock 3 mm metal spacers now support plate A and the corner clamp tabs directly on the 2020; the acrylic is cut away from the entire underside footprint of these plates. This removes acrylic from those clamp paths without moving the spindle datums. Ten drive mounting nuts now have the specified 5 mm DIN985 envelopes, replacing the earlier shorter plain-nut representations.

Normal gravity/axial load path: carrier -> Hyper Hub -> upper bearing inner race -> bearing/housing -> plate A -> four metal hardpoints -> cross rails -> bracketed deck -> legs. Belt torque path: motor D shaft -> 5 mm pulley -> belt -> REX pulley -> REX shaft -> Hyper Hub -> carrier. The hub (top) and the REX pulley set screws through the race spacer and shims (bottom) locate the shaft axially; end screws/washer stacks provide backup retention. Rim supports are set to light stabilizing contact. Neither plastic support creep nor the pillow block's axial capacity has been qualified.

## Numbered parts and purchases

`procurement.csv` lists every item and installed quantity for this scope, with links, kit inclusions and fabrication actions. `component-map.csv` assigns every in-scope CAD component to one item. A motor shaft is included in its motor; pillow-block bearings are included in their block; wheel bearings and internal shims are included in their three wheel kits. Do not buy these again as separate items.

Sawyer already has the 17HS19 motor, an 8 mm round shaft and a pack of three plum couplings. The round shaft and couplings are unused in this belt-drive revision. The CL57T-V41 closed-loop driver is ordered (outside this list). The 10 order-review items are cleared to order but not yet ordered. All other stock status is unconfirmed; the packet places no orders. Confirm exact motor suffix and the actual shaft/body envelope against the E1K model before fabrication. This is not a renewed question about the already-confirmed 17HS19 family.

Key additions: three standard Ender wheel kits, three M5x 25 socket screws, six external 5 ID / 10 OD / 1 precision washers, three axle M5 nylocs, and twelve 5 ID / 10 OD / 3 aluminum deck spacers. Buy three five-packs of deck spacers; three are spare. The six external wheel washers are additional to the three internal washers supplied inside the wheel kits. Keep the internal washers in place.

## Frame: cut, square and assemble

| Item | Quantity | Finished length | Function |
| --- | ---: | ---: | --- |
| F01 | 2 | 300 | Front and back deck rails |
| F02 | 2 | 260 | Left and right deck rails |
| F03 | 2 | 260 | Cross rails |
| F04 | 4 | 100 | Legs |

Ten 20 x 20 pieces, 2040 mm total finished length. All ends square, no mitres. A feasible stock plan is four 600 mm lengths: 300+260, 300+260, 260+100+100, 260+100+100. Check actual saw kerf and squaring allowance; two finished 300 pieces cannot be cut from one exactly 600 piece with a kerf.

1. Cut, deburr and label each rail. Inspect the actual slot opening and cavity with the selected M5 T-nut before cutting the full batch. The CAD extrusion is a generic 6 mm-slot profile, not a verified purchased SKU.
2. Lay the two 300 rails front/back, outside Y faces +/-150. Place the 260 side rails between them at X +/-140. Outside frame is 300 x 300. Fit four 28 x 28 x 20 cast corner brackets with two M5x 8 button screws and T-nuts each. Start loose.
3. Put the two cross rails between the front/back rails at X +/-45. Centers are 90 apart; inside gap is 70. Fit one bracket at each cross-rail end, eight more M5x 8 screws/nuts. Set the top faces coplanar.
4. Attach the four 100 legs at axes (+/-140, +/-140), top Z-20 and bottom Z-120. Fit one bracket per leg under the deck rail, eight more M5x 8 screws/nuts. Check leg verticality and all bottom ends on a flat surface.
5. Square by comparing opposite sides and diagonals; target outside diagonal is 424.264 mm. Match diagonal measurements within 0.5 mm as a proposed shop target, then confirm the mating deck/plate holes fit without forcing. Tighten in stages to the actual bracket/T-nut supplier's specification. The one-bracket-per-leg layout still needs a physical racking test.
6. For the downstream feet only, the model assumes an M5 thread 12 mm deep in each leg's 4.2 mm center bore. Check the real extrusion, tap and chip-clearance requirements. Foot hardware and the lower plinth remain separate work; their existing acrylic sandwich is not qualified by the new top-deck metal hardpoints.

Frame hardware: 12 cast brackets and 24 M5x 8/T-nut pairs. The four corner clamp tabs add eight M5x 14/T-nut pairs and eight metal spacers. Plate A adds four M5x 14/T-nut pairs and four spacers. The deck skin adds four M5x 8/T-nut pairs. Thus this scope needs 40 M5 slot nuts and 28 M5x 8 button screws; confirm generated BOM agrees.

## Fabrication: plates and skin

Use this revision's DXFs and STEP files in `fabrication/`. Do not scale the PDF. DXFs describe nominal cut geometry, without tool kerf compensation. CAM must apply the actual machine/tool allowance. Finish bearing/pilot/slot fits by measurement; laser-cut holes are not automatically precision bores. Deburr both faces, remove protrusions and inspect flatness.

**P01, plate A:** one 6 mm 6061 plate, 120 mm square core and three 38 mm-wide arms to radius 100 at 90/210/330 degrees, with rounded roots and ends. Central clearance diameter 16. Four diameter 5.5 frame holes at (+/-45, +/-40). Four diameter 5.5 motor-support holes at X+/-21, Y+1/-45. Four diameter 4.3 pillow-block holes at (+/-8, +/-8). Each arm has two diameter 4.5 holes at local radial 76, tangent+/-8. Two diameter 2.5 pilot holes for M3 threads at local (u 67.3, v 0.6) and (u 67.3, v 7.0), rotated 45 degrees. Tap M3 through after cutting. No countersinks here.

**P02, motor plate (V12.5, I037):** print `fp9_motor_plate` in PETG at 100 % infill, 3 walls, top face (Z -20) DOWN on the bed, pocket opening up, no supports (Bambu P2S PETG: 2.6 h, 110.2 g, 0 warnings). One 12 mm slab, 114 x 120 (X -57..57, Y -60..60), Z -32..-20: the 64 x 120 plate below plus four tabs to X +-57 at Y +-(38..60), each with a 5.5 x 7 slot along X at (+-45, +-48). The motor pocket is cut from below (Z -32..-25.5, X +-22.5, open past Y +60), so the motor face sits on a 5.5 roof at Z -25.5. All openings of the aluminium plate below are kept in the slab. The aluminium plate drawing that follows is superseded (kept for the record):

**P02 (V12, superseded), motor plate:** one 64 x 120 x 6 mm 6061 plate. Origin is spindle axis, +Y toward motor. Outline X+/-32, Y+/-60. Four diameter 5.5 holes at X+/-21, Y+1/-45. Diameter 24 spindle access at (0, 0). Motor pilot slot 24 wide, center endpoints (0, 28.5)/(0, 30.5). Four motor slots 3.4 wide: X+/-15.5, center endpoints Y13..15 and 44..46. Overall lengths are 26 and 5.4 respectively. Belt slot (I035): one 20 mm wide through slot along Y, X+/-10 from the spindle access hole to the pilot slot (Y 0..28.5, ends inside the two 24 cuts), its four cusps where the slot sides meet the 24 circles rounded R 2. It gives the belt's straight runs a clear channel: the belt bottom (Z-16) sat 1.0 above the web at Y about 15.5; with the slot the nearest plate edge is 3.36 mm from the belt at C 28.5, 30.0 and 30.5 (BRepExtrema). A 16 wide slot would leave only 1.56. The 5.5 support holes keep 8.25 wall to the slot (6.27 to the spindle hole, unchanged); the M3 motor slots keep 3.8. These are through cuts, no tapped holes. The 20 mm support spacers lie between Z-17 and +3; the motor plate lies Z-23..-17.

**P03, four clamp tabs:** 6 mm 6061, 43 x 43 mm overall L outlines with 22 mm-wide arms, handed per their DXFs. Two diameter 5.5 holes on rail slot lines. Eight 3 mm metal spacers sit below these holes. Measure the free clamp-pad and actual clamp-jaw access before selecting a bench clamp. No clamp SKU or load rating is supplied by the CAD.

**P04, deck skin:** 3 mm cast acrylic, originally 300 square. The V12 DXF includes a central opening, three arm reliefs, all four clamp-tab footprint reliefs, cable-grommet opening, sheet screws and downstream cage holes. Entire structural plate footprints are clear of acrylic with at least 0.5 mm nominal planar relief. Do not use the V11 skin cut file. Do not put acrylic back between a metal spacer and a mounting plate. Equalize actual spacer heights using measured stock shims if needed and record the final stack; do not distort plate A to compensate.

**P05, carrier interface:** retained 186 OD x 6 mm 6061. Center 14.3, four M4 through/countersunk hub holes on a 32 square rotated 30 degrees. Use 90 degree included countersinks, maximum 8.96 mm theoretical top diameter and 2.23 mm depth over the 4.5 mm bore, matching the actual ISO10642 screw heads flush. The CAD uses the supplier maximum head envelope; finish the countersink only as deep as the actual supplied head requires, up to this maximum. Smaller heads must not be sunk blindly to the maximum. This corrects the inherited 80 degree recess. Use STEP for the countersink and full hole table. Other holes remain for the complete rotor: six M4 taps on radius 83, two M5 post taps on radius 66 at 51.25/231.25 degrees, four M5 trim taps on radius 80, camera diameter 3.4 holes, Pi/driver diameter 2.7 holes, switch/port openings and two diameter 6.1 through-holes for 6x 3 magnets at radius 76. Magnets seat flush with the underside, south pole down after sensor confirmation, and are bonded; the downstream ring caps the holes from above. No screw end, burr or adhesive may protrude into the underside track radius 85.95..92.05. Check the full operation CSV before machining; the DXF's selected planar face alone does not specify countersinking, tapping or both faces.

Proposed shop targets, not tolerance-stack proof: frame lengths +/-0.2 mm; coplanarity of cross-rail tops and equal support-spacer heights within 0.1 mm; plate track flatness target 0.1 mm. Print/finish holes for a sliding M5 axle and free screw insertion. Record actual deviations and recheck alignment rather than forcing parts into position.

## Wheel supports and axle stack

Print three identical R02 supports (V12.5 gusset A, I038; `bin/cad printcheck fp9_roller_block`) in PETG **on their back**: the outboard wall's r 99.5 face on the bed (one planar 1155 mm2 face), layers stacking along r, no supports; only the two M4 holes bridge (Bambu P2S PETG, 3 walls, 25 % infill: 10.0 g, 38 min, 0 warnings). The V12 side guards are replaced by two triangular gussets with R 5 base coves, R 3 vertical corners and R 5 coves onto the wall; slot, holes and wall top unchanged. A starting process is 0.2 mm layers, at least six perimeters and locally solid infill around the axle wall and mounting holes. These are fabrication starting settings, not a certified print-strength specification. Inspect layer bonding; remove slot bridges/strings without enlarging the wall or rounding its clamping faces.

Support mounting uses two M4x 16 socket screws and M4 DIN985 nuts per support, through 4 mm support base plus 6 mm plate A. The nuts are 5 mm high; nominal screw protrusion is 1 mm. Install these on the bench with plate A accessible underneath.

From **outside toward the center**, each axle is:

1. M5x 25 socket-screw head, outside the support wall.
2. Support wall, 4 mm, with 5.4 mm vertical slot.
3. External precision washer, 5 ID/10 OD/1 mm.
4. Assembled wheel, 11 mm between outer bearing faces: 625 bearing 5 mm + internal precision washer 1 mm +625 bearing 5 mm. POM shell surrounds this stack.
5. Second external 5/10/1 precision washer.
6. M5 DIN985 nut, 5 mm high, inboard. Nylon end faces the projecting screw tip.

Grip before nut is 17 mm; total stack through nut 22 mm, leaving 3 mm screw protrusion. The two external washers load the bearing inner races. Their overhang must not rub the recessed shields on the actual supplied bearings. The internal washer prevents the two inner races being squeezed together when the nut is tightened. Tighten while holding the wheel height and verify the wheel still spins freely. Binding is a stack/fit fault to correct, not something to overcome by leaving a loose axle bolt.

Wheel axle center is radius 89 and Z32.95; top of 24.1 OD tread is Z45, equal to the carrier underside. The flat tread spans radius 85.95..92.05, leaving 0.95 mm to the carrier edge. The stock model's plastic width is 10.2; bearing faces span 11. The manufacturer's current product description says 24 x 10.24, so generic replacements must be measured. Geometry matches the archived official CAD, not every seller's use of the word "standard."

Available axle-center travel is Z30.95..34.95. Remove the carrier to use the full range: raising above nominal intentionally intersects an installed disc. Install the bare carrier, raise each wheel to just contact using equal light paper drag, and lock the nut without changing height. Turn by hand through 360 degrees and repeat. Do not jack the rotor up with the wheels or use three hard preloads to hide a tilted spindle. A finite-width flat wheel has differential surface speed across a rotating disc; inspect for POM heat, dust and track wear during initial low-speed unloaded testing.

A straight 8 mm nut socket with OD no more than 13 mm has the modeled inboard approach. A 4 mm hex driver has the outboard approach with the cage removed. This checks the straight tool envelope, not the swing of every ratchet or L key. Set the supports before reinstalling the cage.

## Spindle and motor assembly sequence

1. On the bench, attach D02 pillow block to P01 with four M4x 12 ISO 7380 button screws upward from below, **no washers** on either face. Nominal engagement is 6 mm. The heads sit at Z 0.8..3.0 on r 11.31; the nearest spinning part (the lowest race shim, r 5.5) is 2.01 mm away (BRepExtrema, swept 360 deg), and the REX pulley hub top (Z -0.5) is below them. Keep the block's bearing outer rings and housing seated; do not substitute generic 8 mm hex bearings for the REX profile.
2. Attach all three wheel supports and the Hall bracket while P01's underside remains accessible. The Hall bracket uses two M3x 10 button screws into plate A; its board uses one M3x 6 screw into a heat-set insert and rests against the modeled ledge. Keep cables clear of the future belt/shaft path; wiring is not yet modeled.
3. Pop the factory e-clip off the 72 mm REX shaft (keep it as a spare); its groove end goes down. Insert the shaft through the pillow block. Shaft ends are Z -24.8 and +47.2 (0.2 proud of the hub pilot, step 5). From below, slide on in order: the 1522 race spacer (8 ID x 10 OD x 6), up through plate A's 16 hole onto the lower bearing inner race (Z 3..9, 3.0 radial clearance to the hole); then the 2807 shims (8 x 11 x 1), nominal 3 (Z 0..3).
3a. Loop the GT2 belt over the shaft below plate A BEFORE the REX pulley is slid on; the belt cannot pass over a pulley flange at any slot position (minimum centre distance for that is 26.6, the slot stops at 28.3).
3b. Then slide on the REX pulley through the belt loop, hub up, slid up to the lowest shim with its set screws only snug for now (final Z -18..0, groove centre Z -13.0). Shim rule: measure the hub, block, pulley, spacer and shims, then choose the count so the pulley hub top stays at least 1.0 below the block screw heads and the lower backup spacer still fits (step 4). Do not transmit axial clamp loads through pulley flanges.
4. On the lower shaft end install the 1522 backup spacer (Z -24.8..-18.8; it covers the e-clip groove at Z -21.6..-20.8, so the factory e-clip must be off), the 12 mm OD washer (Z -25.8..-24.8) and the M4x 8 end screw. The washer seats on the shaft end; the spacer rests on it, 0.8 below the pulley, and is never clamped (clamping it against the pulley would pull the race column into the bearings). Measure actual tapped depth and verify the screw seats before bottoming.
5. Fit the Hyper Hub, lower boss against the upper bearing inner race, shaft end 0.1 to 0.3 proud of the hub pilot (nominal 0.2, Z 47.2): never flush or below, or the top washer lands on the hub and the end screw preloads the bearings. Tighten the two M4 pinch bolts (3 mm key) on the bench. Then set the pulley stop, bench only: push the REX pulley up so the shims, race spacer and lower inner race seat without free axial play and without preload, and tighten its two M5 set screws (2.5 key from the side, axis Z -5.0, 8.0 below plate A's underside). These set screws are the lower axial stop; once the cartridge is in the deck the 2020 rails block every key approach at that plane, so the stop can only be set or re-set on the bench. Turn by hand. Add the top 12 mm washer (Z 47.2..48.2) and M4x 8 end screw; it must seat on the shaft end only. The top head reaches about Z 50.4, below carrier top Z 51, inside its 14.3 center opening.
5a. Bench note: after the pulley is set, feeler-check the gap between the backup 1522 spacer and the pulley bottom; if under 0.3 mm replace the backup 1522 with five 2807 shims.
6. Fit the motor up into the slab's bottom pocket turned 180 degrees about its axis, so its lead glands face +Y (out of the open pocket end), away from the spindle's lower end screw; four M3x 10 socket screws and 0.5 mm M3 washers from the slab top through the 5.5 roof, initially loose in the slots. Motor face Z -25.5 (V12.5: 2.5 lower than V12). Thread engagement 4.0 mm versus the specified 4.5 mm tap depth (x 12 would pass it); check actual holes before tightening. Mount the 5 mm pulley directly on the D shaft with hub upward and groove center Z -13.0; its top (Z -1.5) is flush with the shaft tip. The flat grub lands on the D flat at Z -5.0; the flat spans Z -16.5..-1.5 (3.5 from the grub axis to the flat's tip end). Nominal pulley envelope is Z -17.5..-1.5; actual detailed pulley dimensions are not yet verified. This motor sub-assembly waits on the bench until step 9a.
7. Install four M5x 50 socket screws down through plate A and four 20 mm RAF spacers; they hang 21 mm below the spacers until the slab goes on (step 9a). Leave the 100 mm belt looped on the REX pulley.
8. Fit the bare carrier with four M4x 12 countersunk screws into the Hyper Hub, then set the three wheels. Remove carrier again for installation of the cartridge. The cartridge goes in WITHOUT the motor and slab: plate A, spacers, hanging M5x 50 screws, belt loop and supports pass vertically through the deck opening between the cross rails (the 114 wide slab does not pass the 66 mm opening). Do not assume arbitrary tilted insertion works.
9. Install the relieved acrylic skin with its four M5x 8/T-nut pairs. Place the four 3 mm metal spacers on the cross-rail slots under the plate-A holes. Lower the cartridge and secure four M5x 14/T-nut pairs. The hardpoints, not acrylic, must bear plate A. Install the corner clamp tabs on their eight spacers and M5x 14/T-nut pairs.
9a. Slab (V12.5, I037), from inside the plinth with the bottom panel off: slide a 3 mm aluminium spacer (5 ID / 10 OD / 3) onto each hanging M5x 50, lift the slab with the motor onto the four screws, the motor pulley up into the belt loop, and fit four M5 DIN985 nuts under the slab (grip 41 = 6 + 20 + 3 + 12, nut 5, 4 proud). Drop four 2020 T-nuts into the cross rails' bottom slots and fit four M5x 18 button screws up through the tab slots (4.9 into the T-nut); the tab tops bear flush on the rail undersides. Align the pulley grooves (both Z -13.0), set belt tension in the motor slots and tighten the four M3x 10 with a hex key from the side, between the slab top (Z -20) and the deck. Tension travel is only +1.0 belt path (centre 30.0 to 30.5): reject any belt from the pack that does not reach tension by centre 30.3. BRepExtrema belt to slab: 5.125 at C 28.5 / 30.0 / 30.5 (I035 needs 3.0). Refit the bottom panel.
10. Refit carrier, confirm all wheel contacts, and turn a complete revolution by hand with the motor disconnected. Verify the two Hall targets pass the sensing face at the nominal 2 mm gap. Add the rotor/cage only after the mechanical checks below; their assemblies have their own open findings.

## Belt alignment, tension and retained clearances

The drive is 1:1 with 20 teeth each at 2 mm pitch. Pitch radius 6.366 mm, nominal center distance 30 mm, belt pitch length 100 mm. Center travel is 28.5..30.5. At minimum center the pitch path is 97 mm, providing 3 mm nominal slack for installation. At maximum it is 101 mm; this is travel allowance, **not permission to stretch the belt 1 percent**. No arbitrary guitar-string or thumb-deflection criterion is assigned.

Set both groove center planes to Z -13.0 (fix A). Check with a straightedge or measured flange offsets; different pulley flange/overall heights are not identical reference faces. Obtain the belt supplier's working-tension and tension-setting method. Measure/set its specified pretension and record it, then lock the motor screws and recheck. If a frequency method is supplied, it requires the actual belt mass per length and free span, not a guessed number.

The unchanged V11 motor travel audit checked 21 positions and bounded intermediate noncontact separation at 1.2 mm. V12 repeats the travel check against the changed geometry. The intentional sliding motor-plate interface and fixed-shape belt are treated separately. Belt strain/tooth contact under rotation is not a flexible-body simulation.

At 0.2625 N m, belt tension difference is 41.2 N. With 11 mm spindle-bearing span and belt 24.25 mm below the lower bearing center, minimum reactions are approximately 132 N at the lower bearing and 91 N at the upper, before added pretension/external loads. At 0.52 N m they rise to 262/180 N. These are load demands, not allowable ratings. Axial bearing capacity and the motor's radial limit must be checked independently. The short belt solves transmission geometry; it does not establish bearing life.

## Validation evidence and physical acceptance

The validation JSON records full-model solid/contact checks, actual joint results, wheel internal-component checks, wheel adjustment poses, continuous flat-track containment, axle tool envelopes, deck insertion bounds, metal hardpoint contacts, and differences from V11. The first source-based wheel internal check found no overlaps among its 30 bodies. Full assembly rotation uses discrete poses; the unchanged planar annular track and axisymmetric tread provide continuous contact geometry only for that specific interface.

Before cutting final plates: verify purchased wheel OD/width/flat tread/bore, motor shaft/D-flat/body length, motor-pulley hub/tooth/grub dimensions, 2020 profile and nut/casting compatibility. Measure all spacers. Check the supplied screw lengths, thread depths, grades and supplier torque instructions. CAD nominal fit is insufficient to claim actual off-the-shelf fit when the detailed vendor drawing is absent.

Before powered loaded operation: establish pillow-block radial/axial ratings and motor radial rating; specify/measure belt pretension; confirm hub/collar/pulley screw torque and retention; indicator-check endplay and radial/axial runout; verify free rotation and no rubbing throughout360 degrees; confirm wheel bolts remain clamped without bearing drag; inspect support creep and frame racking; validate guarding, balance, wiring and controlled stopping. Record observations in `acceptance-record.csv`. Items without evidence remain OPEN, not PASS. No full-machine operating release is issued by this packet.

## Reproduce and files

Build with `bin/cad build froggy_v12_5` (V12.5; `froggy_v12` is the frozen V12). The V12 scripts below read `out/froggy_v12/` and were not re-run for V12.5. Run `.venv/bin/python scripts/verify_v12_assembly.py` and `.venv/bin/python scripts/verify_v12_motor.py`. Generate fabrication files and figures using `.venv/bin/python scripts/package_v12.py`, then generate the PDF with `/usr/bin/python3 scripts/document_v12.py` (the repo `.venv` has no ReportLab; the system Python 3 does). The PDF's per-step and per-part pictures are CAD renders in `manufacturing/v12-frame-drive/figures/steps/` and `figures/parts/`, made with `.venv/bin/python render_v12_steps.py (a local script, not in this repo)`; vendor photos and their source URLs are in `figures/vendor/`. The full model is `out/froggy_v12/froggy_v12.step`; the review viewer has `frame_drive`, `rim_support`, `belt_drive` and `shaft_detail` views.

Dimensional interface: [ICD-V12.md](ICD-V12.md) with [ICD-V12.5.md](ICD-V12.5.md) on top. Official wheel CAD and its GPL-3.0 licence are retained under `vendor/motion/creality_ender_vwheel/`. Standard nyloc envelopes are based on [DIN985 supplier dimensions](https://www.aspenfasteners.com/content/pdf/Metric_DIN_985_spec.pdf). External precision shim source: [Maker Store 10x5x1](https://www.makerstore.com.au/product/shim-prec-1051/). Regional supplier links establish exact part identity; availability, shipping and price require checkout confirmation.
