partypancake8/froggy-control/motor/schematic-img/vendor-article-cl57t-v41-wiring.jpg

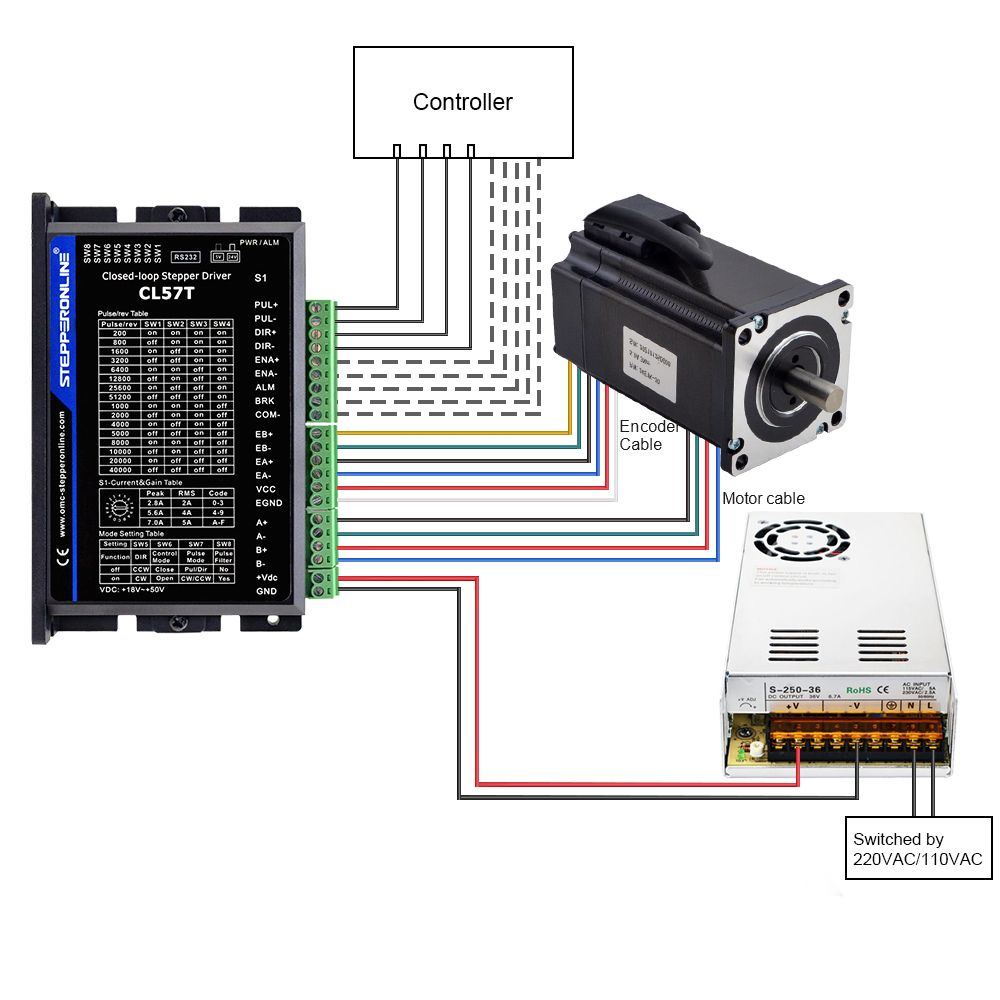
motor/schematic-img/vendor-article-cl57t-v41-wiring.jpg
