partypancake8/froggy-control/model/cad/assemblies/froggy_v12_5.py

"""Froggy V12.5: V12 plus the printed motor plate slab with rail tabs (I037) and the roller block gusset A (I038).

Everything else is froggy_v12 unchanged (v12 is frozen; this file started as a copy of master's froggy_v12.py at 6105f2d).
I037: parts/fp9_motor_plate (PETG, one 12 mm slab Z -32..-20, four tabs bolted up into the cross rails' bottom slots)
replaces lp_motor_plate at the same world placement; the motor drops 2.5 (MOTOR_DROP, face Z -25.5, roof 5.5) so the
unmoved motor pulley's top (Z -1.5) is flush with the shaft tip; belt plane BD.BELT_Z -13.0 unchanged. Four stock 3 mm
spacers under the 20 mm spacers, S1.1 screws M5 x 50 + nyloc under the slab, four M5 x 18 BHCS + drop-in T-nuts at the
tabs, S1.2 M3 x 10 + washer through the 5.5 roof. The slab goes on from inside the plinth (bottom panel off) after the
cartridge is in; at 114 wide it does not pass the 66 wide deck opening.
I038: _roller_block is drawing A (gussets with R 5 / R 3 coves, printed on its back), verbatim from roller-fillet da3ab19.
See docs/ICD-V12.5.md and docs/V12.5-ASSEMBLY.md. Not load-qualified.
"""
import copy
import math
import os
from functools import lru_cache

import numpy as np
from build123d import Align, Box, Compound, Cylinder, GeomType, Location, Plane, Solid, extrude, import_step, scale

from assemblies import froggy_v7 as V7
from assemblies import froggy_v8 as V8
from assemblies.frame import _location
from lib import hardware as HW
from lib import profile_2020 as P
from lib import vendor as V
from lib.assembly import Assembly
from lib.design_constants import LASER, PRINTED, min_edge_margin
from lib.joints import bolt_joint, hex_nut_joint, insert_joint, tapped_joint
from parts import drive_v11 as BD
from parts import fp9_motor_plate as MP   # I037 printed slab (reads its datums from froggy_v12, identical here)
from parts import rollers_v12 as RW
from parts import datums as D0
from parts import fp6_datums as D6
from parts import fp6_drum_carrier, fp7_controller_carrier, fp9_cage as CG, fp9_estop_cradle, s_drum_tube, s_top_disc

_R, _box, _solid, _c, _sg = V7._R, V7._box, V7._solid, V7._c, V7._sg

# S2.3 / S2.4 (2026-10-12): legs 80 (Z -100..-20) and the bottom ring at Z -120..-100, so the 17HS19 cartridge with a
# penetration-safe coupling fits; bottom panel, feet and plinth electrics follow 10 lower. The v8 plinth builders read
# these module datums when they run, so v9 sets them on V8 once, here, before anything is built.
V8.BOT_Z0, V8.BOT_Z1 = -120.0, -100.0
V8.LEG_Z0 = V8.BOT_Z1
V8.BOTP_Z0, V8.BOTP_Z1 = V8.BOT_Z0 - V8.PANEL_T, V8.BOT_Z0
V8.FLOOR_Z = V8.BOTP_Z1
V8.CC_DZ = V8.FLOOR_Z - fp7_controller_carrier.Z0
# I020 / I021 (2026-10-16 sponsor meeting, DL29): the base square is gone; the panels hang from the deck rails (2 x M5
# per panel at the deck rail centre line). I029 (2026-10-21): four 2020 legs at the deck corners carry the machine down to
# the plinth floor (LEG_TOP..LEG_BOT below); the panels also hang from the legs' outer slots. BOT_Z0 stays the plinth floor
# datum (bottom panel top face, electrics on it); V8.BOT_Z1 / V8.LEG_Z0 are no longer frame datums.
V8.PANEL_SCREW_Z = ((V8.DECK_Z0 + V8.DECK_Z1) / 2,)
# DL21 (2026-10-12): the right panel's vent row centred on the panel (h 0) like the left panel's, not beside the PSU
V8.VENT_H = {**V8.VENT_H, "right": 0.0}

# ------------------------------------------------------------------ frame (v8, posts per ICD S3.1)
W = P.W
HALF, RC, RIN = V8.HALF, V8.RC, V8.RIN
CROSS_X = V8.CROSS_X
DECK_Z0, DECK_Z1 = V8.DECK_Z0, V8.DECK_Z1
BOT_Z0, BOT_Z1 = V8.BOT_Z0, V8.BOT_Z1
LEG_Z0, LEG_Z1 = V8.LEG_Z0, V8.LEG_Z1
PANEL_T = V8.PANEL_T
SHEET_Z0, SHEET_Z1 = V8.SHEET_Z0, V8.SHEET_Z1
M5_HOLE = 5.5
BR_L = V8.BR_L
G_D, G2 = V8.G_D, V8.G2
SHEET_SCREWS = V8.SHEET_SCREWS
M5 = dict(nut="slot_nut", head="button", evaluate=False)

# ------------------------------------------------------------------ legs, plinth shell and clamp tabs (DL29, I021, I023, I029)
# I029 (2026-10-21, Sawyer: "no that will not work, sitting on the arylic, maybe 4 posts out of 8020 ? as legs and the plinth
# adds rigidity?"): four 2020 legs at (+-RC, +-RC) from the deck rail underside down to the bottom panel's top face. Each
# leg hangs from the deck X rail on one cast bracket (inboard X face); its bottom end tap takes the foot bolt, which clamps
# the bumper foot and the bottom panel under the leg end. The panels are skin: 2 x M5 x 8 + T-nut per leg edge into the
# legs' outer slots plus the deck rail pair; acrylic and PETG carry nothing (DL29).
LEG_TOP, LEG_BOT = DECK_Z0, BOT_Z0          # -20 (deck rail underside) .. -120 (bottom panel top face)
LEG_L = LEG_TOP - LEG_BOT                   # 100
LEG_XY = RC                                 # 140: leg axes, the deck rail centre lines (outer faces on the panel faces)
LEG_TAP_DEPTH = 12.0                        # M5 tapped 12 deep in the leg's 4.2 centre bore at the bottom end (assumed)
LEG_PANEL_Z = (LEG_TOP - 15.0, LEG_BOT + 15.0)   # -35 / -105: panel screws into each leg's outer slots
FOOT_SCREW = "M5x16"                        # head in the foot's 10.5 x 5 counterbore, 3 rubber + 3 sheet, 10 into the leg tap
CT_T = 6.0                                  # lp_clamp_tab: 6061 PLATE_T off the Fablight
CT_Z0 = PANEL_T                             # on the deck sheet top (Z 3), over the deck rail corner
CT_HOLE = HALF - 31.0                       # 119: one M5 hole on each deck rail's top-slot line (+-140)
CT_EDGE = HALF + 1.0                        # 151: outer edges 11 = 2 x d from the slot-line holes (DL8), inside the 153 panel faces
CT_ARM_END = CT_HOLE - 11.0                 # 108: arm ends 11 past the holes (sheet screw heads at 100 + 4.75 stay clear)
CT_ARM_IN = RC - 11.0                       # 129: arm inner edges 11 inside the slot line
# assumed jaw (I023, recorded in the sheet notes): F clamp or wood quick clamp, pad 25 wide, reach 30 in from the panel
# face, 10 thick; opening at least 180 (tab top Z 9 to the underside of a 40 thick bench top under the feet)
CLAMP_JAW = dict(reach=30.0, thick=10.0, pad=25.0, opening_min=180.0)

# ------------------------------------------------------------------ S1 datums
PLATE_T = 6.0           # lp_plate_a (ICD S1.4 PLATE_T) and the carrier disc: 6 mm 6061
DISC_T = 6.0
DISC_D = 186.0
FAB_T = 3.175           # 1/8 in 6061 off the Fablight: rings B / C / D / E (motor plate is 6 mm) (rule 1)
# S1.1 / S1.2 motor plate and motor (the drive base is a cartridge on plate A, S1.26)
SPACER_L, SPACER_OD, SPACER_ID = 20.0, 10.0, 5.3  # RAF M0669-5-AL, S1.1-V12
SPACER_XY = [(sx * 21.0, y) for sx in (1, -1) for y in (1.0, -45.0)]
SPACER_NAMES = [f"v_spacer_raf_m0669_5_al_{k}" for k in range(1, 5)]
SPACER_SCREW_L = 50.0  # I037: grip 41 (plate A 6 + spacer 20 + extra spacer 3 + slab 12) + DIN985 nyloc 5, 4 proud (V12: 40)

MPLATE_T = 6.0
MPLATE_Z1 = SHEET_Z1 - SPACER_L  # -17
MPLATE_Z0 = MPLATE_Z1 - MPLATE_T  # -23
MPLATE_X, MPLATE_Y = 64.0, 120.0            # long side along Y, passes between the cross rail inner faces (X +-35)
MOTOR_HOLES = BD.motor_holes()  # V12: square pattern at (0, 30), tension slots
MOTOR_PILOT_D = 24.0                        # ICD S1.2 (ds): drawing boss 22 -0.05, the STEP root fillet reaches 23.5
MPLATE_BELT_SLOT_W = 20.0                   # I035: 16 left the slot edge 1.56 from the belt; 20 gives >= 3.0 (BRepExtrema, C 28.5..30.5)
MPLATE_BELT_SLOT_R = 2.0                    # the four slot-to-circle cusps rounded (DL8 inside corner look)
MOTOR_FACE_Z = MP.MOTOR_FACE_Z               # I037: -25.5 = V12's -23.0 minus MOTOR_DROP 2.5 (slab pocket roof underside)
PLATE = "fp9_motor_plate"                   # I037: replaces lp_motor_plate at the same world placement
EXTRA_SPACER_NAMES = [f"v_motor_plate_spacer_{k}" for k in range(1, 5)]
EXTRA_SPACER_T = MPLATE_Z1 - MP.Z_TOP       # 3: the slab top is Z -20, the 20 mm spacers still end at Z -17
TAB_SCREW = "M5x18"                         # I037 tabs: up through the 12 mm tab into a 2020 drop-in T-nut (x 16 gives 2.9)
BELT_CLEAR_MIN = 3.0                        # I035: belt to the motor plate (now the slab), BRepExtrema, C 28.5..30.5
MOTOR = "v_nema17_17hs19_2004d_e1k"
MOTOR_DIR = "motion/stepperonline_17hs19_2004d_e1k"
MOTOR_STEP = MOTOR_DIR + "/17HS19-2004D-E1K.step"
MOTOR_SHAFT_L = 24.0                        # drawing 24 +-1, D-cut 15 from the tip; STEP shaft local Y -4..24
MOTOR_SHAFT_TIP = MOTOR_FACE_Z + MOTOR_SHAFT_L  # +1 nominal, 0..2 with vendor tolerance
MOTOR_SCREW = "M3x10"  # I037: 10 - 0.5 washer - 5.5 slab roof = 4.0 engaged (x 12 passes the 4.5 deep motor holes)
DECK_OPEN = (66.0, 126.0)                   # S2.5 centre opening X x Y, between the cross rail inner faces
# V12 S1.3: drive_v11 holds vendor pulley datums and closed belt geometry.
# S1.4 / S1.5 plate A and pillow block
PA_Z0 = SHEET_Z1                            # 3
PA_Z1 = PA_Z0 + PLATE_T                     # 9
PA_SIZE = 120.0
PA_RAIL_HOLES = [(sx * CROSS_X, sy * 40.0) for sx in (1, -1) for sy in (1, -1)]
PA_CENTRE_D = 16.0                          # ICD text 30: the block's 16 mm M4 pattern (r 11.3) lies inside 30; 16 clears the 9.95 race spacer by 3.0 radial (fix A)
BLOCK_HOLES = [(sx * 8.0, sy * 8.0) for sx in (1, -1) for sy in (1, -1)]
BLOCK_HOLE_D = 4.3
BLOCK_H = 16.0
BLOCK_Z0, BLOCK_Z1 = PA_Z1, PA_Z1 + BLOCK_H  # 9..25
# S1.7 hub
HUB_ANG = 30.0                              # hub turned so its REX bore flats meet the shaft (and the block's)
HUB_BOSS_Z = BLOCK_Z1                       # 25: 11 dia boss on the upper inner race
HUB_FLANGE_TOP = HUB_BOSS_Z + 20.0          # 45
HUB_PILOT_D, HUB_PILOT_H = 14.0, 2.0
HUB_H = 22.0                                # measured vendor STEP: 0.6 boss + clamp + shoulder + 6 flange + 2 pilot, 25..47
# S1.6 shaft retention, fix A (I033, 2026-10-28; interface-risks rows 2, 4, 5, 9, 17b, 17c): the 2920 collar is gone.
# On the lower inner race a 1522 spacer (8.05 ID x 9.95 OD x 6.00, measured) runs down through plate A's 16 hole and
# SHIM_N 2807 shims (8.00 x 11.0 x 1.00, measured) hang under plate A; the 3422 REX pulley (18.0, hub up) sits directly
# under the shims and its two M5 set screws (axis 5.0 below the pulley's hub-end tip, measured) are the lower axial
# stop. The block is captured between the hub boss (25) and the spacer column (9): set by pushing the pulley up and
# tightening its set screws on the bench. Measure then choose: SHIM_N is the nominal count only.
SHAFT_L = 72.0  # stock goBILDA 2106-4008-0720, 72.00 measured
SHAFT_SQUEEZE = 1.0  # use nominal vendor geometry, no invented fit clearance
SHAFT_PROUD = 0.2                           # shaft end 0.1..0.3 proud of the hub pilot (interface-risks rows 4, 17c)
SHAFT_Z1 = HUB_FLANGE_TOP + HUB_PILOT_H + SHAFT_PROUD   # 47.2: the upper end washer bears on the shaft, not the hub
SHAFT_Z0 = SHAFT_Z1 - SHAFT_L               # -24.8
RACE_SPACER_H, SHIM_H = 6.0, 1.0            # goBILDA 1522-0010-0060, 2807-0811-1000 (measured STEPs)
SHIM_N = 3                                  # shim_count_nominal (pulley hub top 1.3 under the block screw heads)
RACE_SPACER_Z0 = BLOCK_Z0 - RACE_SPACER_H   # 3 = plate A underside
SHIM_Z0 = RACE_SPACER_Z0 - SHIM_N * SHIM_H  # 0
REX_H = 18.0                                # 3422 overall, measured
REX_TOP = SHIM_Z0                           # 0: the pulley's hub-end tip on the lowest shim
REX_GRUB_FROM_TOP = 5.0                     # 3422 STEP: set screw axis 5.0 from the hub-end tip (holes 2.5..7.5)
REX_GRUB_Z = REX_TOP - REX_GRUB_FROM_TOP    # -5.0
BACKUP_SPACER_Z0 = SHAFT_Z0                 # lower 1522 on the lower end washer, -24.8..-18.8, 0.8 under the pulley
RACE_SPACER = "v_retainer_race_spacer_8x6"
RACE_SHIMS = [f"v_retainer_race_shim_8x1_{k}" for k in range(1, SHIM_N + 1)]
BD.REX_TOP = REX_TOP
BD.BELT_Z = REX_TOP - 13.0                  # -13.0: the groove centre 13.0 under the hub-end tip (was -12.75)
BD.MOTOR_ANGLE = 180.0                      # motor turned 180 about its axis: lead glands face +Y, away from the spindle
#                                             (interface-risks 17a); the M3 square and the D flat turn with it
_RACE_NOTE = ("fix A (I033): on the lower inner race, through plate A's 16 hole; spacer + shims + REX pulley set screws "
              "are the lower axial stop; measure then choose the shim count")
BD.RETAINER_NAMES = (BD.UPPER_WASHER, BD.LOWER_WASHER, BD.LOWER_SPACER, RACE_SPACER, *RACE_SHIMS)
BD.RETAINER_WASHERS = ((BD.UPPER_WASHER, SHAFT_Z1), (BD.LOWER_WASHER, SHAFT_Z0 - 1.0))
BD.RETAINER_STOCK = (
    (BD.LOWER_SPACER, "hardware/gobilda_1522_8x6", "1522-0010-0060.step", BACKUP_SPACER_Z0,
     "fix A (I033): backup retainer under the REX pulley, sits on the lower end washer, 0.8 under the pulley, never "
     "clamped; it covers the e-clip groove (remove the factory e-clip)"),
    (RACE_SPACER, "hardware/gobilda_1522_8x6", "1522-0010-0060.step", RACE_SPACER_Z0, _RACE_NOTE),
    *((nm, "hardware/gobilda_2807_8x1", "2807-0811-1000.step", SHIM_Z0 + k * SHIM_H, _RACE_NOTE)
      for k, nm in enumerate(RACE_SHIMS)))                # shim 1 lowest (on the pulley), shim N under the spacer
BD.RETAINER_ENDS = (("upper", BD.UPPER_WASHER, SHAFT_Z1, (0, 0, -1), SHAFT_Z1 + 1.0),
                    ("lower", BD.LOWER_WASHER, SHAFT_Z0, (0, 0, 1), SHAFT_Z0 - 1.0))
BOTP_Z1_V8 = V8.BOTP_Z1                     # bottom panel top face (-110)
# S1.8 carrier disc
DISC_Z0, DISC_Z1 = HUB_FLANGE_TOP, HUB_FLANGE_TOP + DISC_T
DRUM_FLOOR = DISC_Z1                        # 51
HUB_R32 = 16.0 * math.sqrt(2.0)
HUB_HOLE_ANG = [45.0 + HUB_ANG + 90.0 * k for k in range(4)]   # 75, 165, 255, 345
DZF = DRUM_FLOOR - D6.DRUM_FLOOR_Z          # drum and everything on it vs v7
# S1.27 rim rollers: support the rim at r 90, set touching the disc underside; S1.28 running band r 85.95..92.05
ROLLER_R, ROLLER_ANG = 89.0, (90.0, 210.0, 330.0)
TYRE_OD, TYRE_W = 24.1, 10.2                 # Creality standard Ender wheel: 688-2RS (8 x 16 x 5) with a bonded 85A polyurethane tread
BRG_ID, BRG_OD, BRG_W = 5.0, 16.0, 11.0
ROLLER_Z = DISC_Z0 - TYRE_OD / 2            # 34: axle height with the tread top at the disc underside (zero gap)
ROLLER_NAMES = [f"v_rim_roller_creality_4001070002_{k}" for k in range(1, 4)]
RBLOCK_NAMES = [f"fp12_roller_block_{k}" for k in range(1, 4)]
AXLE_SPACER_NAMES = [f"v_spacer_axle_10x5x1_{k}" for k in range(1, 4)]
# M5x25 axle head outboard, two external 1 mm precision shims and DIN985 nut inboard.
AXLE_SPACER_L = 1.0
RB_BASE_T = 4.0                             # printed block base under the M4 heads (M4 x 16: 4 + 6 plate A + 5 nyloc + 1)
RB_X0, RB_X1 = 67.0, ROLLER_R + BRG_W / 2 + AXLE_SPACER_L + 4.0   # base r 67 .. 99.5 (outboard wall 4 thick)
RB_WALL_X0 = ROLLER_R + BRG_W / 2 + AXLE_SPACER_L                # 95.5: outboard wall inner face (2.5 off the disc edge)
RB_HALF_W, RB_SIDE_Y0 = 17.0, 13.05          # block +-17 wide; gussets' inner faces at +-13.05 (tread +-12.05, 1 mm clear)
RB_WALL_TOP = DISC_Z1 - 1.0                 # 50: the outboard wall stands beside the disc edge (r 95.5 vs 93)
RB_SLOT_HALF, RB_SLOT_W = 2.0, 5.4          # vertical axle slot: centre Z 34 +- 2, 8.2 wide (8 mm shoulder)
RB_HOLES = [(76.0, -8.0), (76.0, 8.0)]       # 2 x M4 x 16 + nyloc to plate A (block-local r, t)
ARM_X1, ARM_HALF_W = 100.0, 19.0            # plate A arms out to r 100, 38 wide, under each block
DECK_NUT_HOLE_D = 12.0                      # deck-sheet clearance under the six block nylocs (they hang below plate A)
# S2.10 e-stop: the complete BACO LBX10510 station (LBX single-position box 74 x 74 x 47.9, yellow cover, 40 mm red
# push-turn-reset mushroom, 1 NC contact block), all 26 solids of BACO's STEP, recessed in the front panel (option A):
# the box passes through a 76 x 76 opening, its yellow cover face ES_PROUD outside the panel, its back on
# fp9_estop_cradle behind the panel. Clear band behind the panel: deck rail underside Z -20 to bottom ring top Z -100.
ESTOP = "v_estop_baco_lbx10510"
ES_STEP = "vendor/electrical/baco_lbx10510/lbx10510.stp"   # BACO's own STEP AP214 (26 solids, all used)
ES_W = 74.0                                  # box outline (STEP base / cover), corners about R 3
ES_DEPTH = 47.9                              # STEP: base back pads (local Y -0.7) to cover face (local Y 47.2)
ES_FACE_LOCAL_Y, ES_PAD_LOCAL_Y = 47.2, -0.7
ES_BOX_C_LOCAL = (0.0, -33.0)                # box centre (X, Z) in the STEP
ES_XC, ES_ZC = 0.0, -60.0                    # box centre on the front panel: centred in the 80 band (3 to each rail);
#                                              X 0: the cradle back is 75 in front of the motor (Y -31), no move needed
ES_Y0 = -(V8.PANEL_IN + PANEL_T)             # -153: front panel outer face
ES_PANEL_IN = -V8.PANEL_IN                   # -150: front panel inner face, the cradle flange on it
ES_PROUD = 5.0                               # yellow cover face 5 outside the panel's outer face
ES_FACE_Y = ES_Y0 - ES_PROUD                 # -158
ES_BACK_Y = ES_FACE_Y + ES_DEPTH             # -110.1: the base's back pads on the cradle back plate
ES_OPEN, ES_OPEN_R = 76.0, 4.0               # panel opening: 1 clearance per side, corners R 3 + 1
# The station is turned 90 deg about the panel normal from the STEP's upright pose so its two M16/20 knockouts face
# +-X: upright, the bottom (and top) knockout opens straight onto the bottom ring (deck rail) 3 below the box, where no
# gland fits. Turned, the bottom knockout faces -X into the open plinth, the head's axis sits 5 above the box centre.
# The base's 2 slots, world (X, Z) relative to the box centre after the turn: (29, 20.5) and (-30.5, -22).
ES_HOLES_REL = [(29.0, 20.5), (-30.5, -22.0)]
ES_HOLES = [(ES_XC + x, ES_ZC + z) for x, z in ES_HOLES_REL]
ES_FLOOR = 3.7                               # base back wall at the slots: pads (STEP Y -0.7) to inner floor (Y 3.0)
ES_CR_SCREWS = [(ES_XC + x, ES_ZC - y) for x, y in fp9_estop_cradle.INSERTS]   # 4 x M3 x 10 into the cradle inserts
# S1.9 .. S1.13 drum stack D1 (2026-10-12): flat Fablight rings + printed seats, no machining. Load path: hub -> carrier
# disc (6061) -> ring B clamped flat on it (6061); the PETG seats only locate and bond the light tube, and the top
# seat only carries the top disc's clamp.
RING_T = FAB_T                              # ring B and the top bezel: 3.175 6061 (rule 1)
# I036 (2026-10-28): drum tube 150 OD x 2.5 wall (Rebower 145 x 150 x 14 in) replaces the 152.4 x 3.2 tube
TUBE_OD, TUBE_WALL = D0.DRUM12_OD, D0.DRUM12_WALL
TUBE_OR, TUBE_IR = TUBE_OD / 2, TUBE_OD / 2 - TUBE_WALL   # 75.0, 72.5
SEAT_RADIAL = 0.3                           # seat bore clearance per side: print the seats at measured OD + 0.6
RING_B = (144.0, 186.0)                     # ID 144 (r 72): the tube foot r 72.5..75 sits fully on aluminium; clears the
#                                             switch nut (r 70.6) and the port nut (r 70.2)
RING_TOP = (147.0, 186.0)                   # lp_ring_top bezel: hole margin 9.5 to the ID, 10 to the OD (rule 6)
STACK_R = 83.0                              # one 6 x M4 screw circle for both ends: outside the tube (r 75.0),
STACK_ANG = tuple(60.0 * k for k in range(6))   # inside the r 86 running band; 30 deg off the two drum posts
STACK_HOLE_D = 4.5                          # M4 clearance (Fablight through holes)
STACK_TAP_D = 3.3                           # M4 tap drill in the 6 mm disc, tapped through
SEAT_FLOOR = 0.0                            # the tube foot stands on ring B (aluminium); the seat is a socket round it
SEAT_CH_R = (TUBE_IR - SEAT_RADIAL, TUBE_OR + SEAT_RADIAL)   # 72.2, 75.3: tube r 72.5..75.0, 0.3 each side (bore 150.6)
# S1.32 drum posts (2026-10-12, Sawyer 15:05): the structure that carries the top ring, the silicone is a seal
# Posts INSIDE the tube (2026-10-13, I014: "put the supports for the drum internal ... supported by the 3D printed
# piece instead of on the external where the frog might hit them"). r 66: body r 61..71 (10 OD), 1.5 clear of the tube bore (r 72.5).
# Diametric pair (point mirror about the rotor axis, DL27; equal masses 180 deg apart keep the rotor CG on the axis).
# 51.25 / 231.25 deg: +-Y is taken by the Pi (+Y, standoffs at r 66.2, 116 / 64 deg) (the -Y LED driver standoffs, r 57.5,
# are gone since I034), and the switch (140 deg) and port (214.7 deg) nuts close the -X gaps; at 51.25 the ring B lobe
# (r 11 round the stud) clears the nearest Pi standoff and at 231.25 the port nut (margins in the sheet notes).
POST_ANG, POST_R = (51.25, 231.25), 66.0
# 140 long (I017): no 8 OD x 140 listing was found (8 OD stock jumps 120 -> 150), the 10 OD x 140 is a listed stock size.
POST_D, POST_TAP_DEPTH = 10.0, 12.0         # M5 F-F round aluminium standoff 10 x 140 (listing); POST_L = TUBE_H below
POST_VENDOR = "hardware/standoff_m5_10x140_al"
POST_HOLE_D, M5_TAP_D = 8.4, 4.2
STUD = "M5x16"                               # bottom: threaded stud, post -> ring B -> tapped disc, no head below
POST_SCREW = "M5x14"                         # top: button head through the bezel and the top disc into the post
POST_LOBE_R = min_edge_margin(M5_HOLE)      # 11: ring B / bezel lobe round each post hole (DL8: centre 2 x d from edges)
SEAT_B_OUT_R = 90.0
SEAT_B_T = 6.0                              # bottom seat flange height (counterbored M4 heads)
SEAT_CB_D, SEAT_CB_FLOOR = 8.0, 1.2         # bottom seat counterbores: M4 BHCS head 7.6 x 2.2 (DL10: one M4 button family on the drum), 1.2 PETG floor
SEAT_T_T = 6.0                              # top seat ring under the top disc, bore r 75.3 over the tube top
SEAT_FILLET = 2.0
RING_B_Z1 = DRUM_FLOOR + RING_T             # 54.175
SEAT_B_Z0 = RING_B_Z1
TUBE_FOOT = SEAT_B_Z0 + SEAT_FLOOR          # 54.175: the tube foot on ring B
SEAT_B_Z1 = SEAT_B_Z0 + SEAT_B_T            # 60.175: wall band starts here
# ICD S1.10 (I017, 2026-10-13): TUBE_H = band floor (bottom seat flange top) + 8 clear + the 100 tall wall-frog
# placeholder (largest sponsor frog, frogs 2 to 10 cm) + 8 clear under the top seat, rounded to the 140 stock cut
# (Sawyer: "14cm prob"; the band is 128); camera board top >= 40 under the disc.
TUBE_H = 140.0
TUBE_TOP = TUBE_FOOT + TUBE_H               # 194.175 = drum post top
SEAT_T_Z0 = TUBE_TOP - SEAT_T_T             # 188.175: band ceiling
POST_L = TUBE_H                             # S1.32: the post runs ring B top (= tube foot) to the top disc underside
WALL_FROG_H = 100.0                         # S1.10 wall-frog placeholder height (largest sponsor frog, 10 cm)
TUBE_NAME = f"acrylic tube {TUBE_OD:g} x {TUBE_WALL:g} x {TUBE_H:g} (Rebower 145 ID x 150 OD x 14 in, cut to length)"
TUBE_DZ = TUBE_H - D6.DRUM_H                # tube height vs the 152 tube (-52)
TOP_DISC_T = D0.ACRYLIC_T
TOP_DISC_D = 186.0                          # grows to the bezel OD so the 6 clamp screws pass through it
STACK_SCREW_B, STACK_SCREW_T = "M4x10", "M4x18"
CAGE_TOP_SCREW = "M5x18"     # S3.5 cage top tab bolt from above: 6.85 ring stack + 4 bracket leg + 4.7 nut = 15.55,
#                              plus 2 full threads past the nut (the joint check's engagement rule): the shortest stock length
# S1.29 white WS2812B 16 LED ring on the camera bridge (vendor/electronics/ws2812_ring_16, I032; replaces the
# Spinel IRXS10 850 nm IR ring of I015). Vendor STEP: Adafruit NeoPixel Ring 16 (product 1463), the footprint the
# Amazon rings (Sparkleiot B0C77XPKSL, 45 OD / 32 hole) share. Read off the STEP: board 44.45 OD x 31.75 hole x 1.6,
# 16 x 5050 (5.0 x 5.0 x 1.7) on r 19, 22.5 deg pitch, 3.3 overall.
LEDR_STEP = "vendor/electronics/ws2812_ring_16/neopixel_ring_16.step"
LEDR_OD, LEDR_ID, LEDR_T = 44.45, 31.75, 1.6
LEDR_N, LEDR_PKG_H = 16, 1.7
LEDR_Z = 4.3                                # board underside 4.3 in front of the camera board underside (FFC top 4.1),
#                                             the plane the IR board occupied
LEDR_RECESS_D = 45.0                        # 44.45 board + 0.55 (the Amazon ring is listed 45 OD)
LEDR_RECESS_DEPTH = LEDR_T + LEDR_PKG_H     # 3.3: the 5050 tops sit flush with the collar top
COLLAR_OUT, COLLAR_IN = 57.0, 37.0          # 57 square collar round the camera board kept (I032 changes the recess only)
LEDR_MA_5V = 300.0                          # allowance: 16 x 5050 white at about 18 mA each (about 30 % brightness cap,
#                                             about 290 mA); full white is up to 16 x 60 = 960 mA (Adafruit)
# S1.30 index magnets, S1.31 hall bracket (2 pulses per rev)
MAG_R, MAG_ANG = 76.0, (0.0, 180.0)         # r 70 (brief) lies inside the swept switch head (r 69.5) and port flange
MAG_D, MAG_T, MAG_HOLE_D = 6.0, 3.0, 6.1    # (r 72.7); r 76 is the free annulus between them and the band
HALL_AZ = 45.0                              # plate A's square corner reaches r 81.5 on the diagonal
HALL_GAP = 2.0
# S1.16 .. S1.20 camera bridge over the bank (Anker 321, A1112: 96 x 45.2 x 23.1, 118 g) lying flat on the axis
BANK_L, BANK_W, BANK_H = V8.BANK_L, V8.BANK_W, V8.BANK_H     # 96 (along X), 23.1 (lying: height), 45.2 (along Y)
BANK_MASS_G = V8.BANK_MASS_G
BANK_Z0 = DRUM_FLOOR
BR_GAP = 0.3
BR_TOP_T = 3.0
BR_TOP_Z0 = BANK_Z0 + BANK_W + BR_GAP       # 74.4: top plate over the bank
BR_TOP_Z1 = BR_TOP_Z0 + BR_TOP_T            # 77.4
BR_X = 40.0                                 # bridge spans x -40..40 (the bank ends stick out 8 each side)
BANK_OFF = (4.0, -3.1)                      # bank + bridge centre: the axis moved by the layout balance (see notes);
#                                             +2.1 in X on 2026-10-13 (I015) for the heavier flat ring + 57 collar
BR_CHEEK_Y = (BANK_H / 2 + BR_GAP, 31.5)     # cheek inner / outer faces from the bank centre line
BR_SCREWS = [(BANK_OFF[0] + sx * 34.0, BANK_OFF[1] + sy * 27.2) for sx in (1, -1) for sy in (1, -1)]
BR_INSERT_D, BR_INSERT_L = 4.1, 6.0         # I028: M3 heat-set pocket in each lug from the disc face (M3 x 10 button from
#                                             under the disc: 6 disc + 4 insert), so the mount top has no driver bores
BR_LIP = 1.2                                # snap lips along the bank's long top edges
CAM_HOLE_PITCH = 28.5                       # UC-261 M2 pitch: assumed (no drawing found)
OPTICAL_AXIS = (0.5, 0.0, math.cos(math.radians(30)))
# I028 (2026-10-21, Sawyer: "i think the camera internal stand needs rework as well, not sure how it got so high? looks
# like it's in a weird spot"): the I018 riser (lens 88) is gone. The camsim sweep at the 140 tube (lens 48..88, tilt
# 20..40, mount left out) sees 99 % of the top disc and 65 / 63 % of the disc / wall frog at 48, as much as at 88
# (the rest is the frogs' own legs and the drum posts), at 6.8 / 9.7 px/mm; so the collar seats straight on the
# saddle's top plate again: lens front on the axis 48 above the disc, the lowest seat the board clears the plate at.
LENS_ABOVE_FLOOR = 48.0                     # lens front on the axis above the disc
LENS = (0.0, 0.0, DRUM_FLOOR + LENS_ABOVE_FLOOR)
CAM_STACK = 13.6
WEDGE_HALF = 19.0
# S1.18 Pi (the S1.23 LED driver is removed in V12, I034: the WS2812 ring runs straight from the Pi)
PI_C = (0.0, 48.0)
PI_HOLES = [(PI_C[0] + sx * 29.0, PI_C[1] + sy * 11.5) for sx in (1, -1) for sy in (1, -1)]
PI_STANDOFF = 6.0
# S1.21 / S1.22 switch and port (r 85.5, outside the tube)
# S1.28: the switch and the port leave the r 86..93 running band. Between the tube (r 75.0) and r 86 there are 11 mm,
# less than either body (12 through the disc, a 19 flange and 16.2 nut), so both move inside the tube on the -X side
# (never in the camera's +X view): switch at (-48, +40) between the Pi and the bridge, port at (-52, -36) beside the
# bank's USB-C end; both still face down, reached under the disc rim when the cage is off.
SWITCH_XY, PORT_XY = (-48.0, 40.0), (-52.0, -36.0)
SWITCH_ANG = math.degrees(math.atan2(SWITCH_XY[1], SWITCH_XY[0]))
PORT_ANG = math.degrees(math.atan2(PORT_XY[1], PORT_XY[0]))
SWITCH_R, PORT_R = math.hypot(*SWITCH_XY), math.hypot(*PORT_XY)
PORT_FLANGE_D, PORT_FLANGE_T, PORT_BODY_D, PORT_NUT_D, PORT_NUT_T = 19.0, 2.5, 12.0, 14.0, 4.0
PORT_HOLE_D = 12.4
# TRU Components LAS4GQH-11 latching (Conrad 1661896) drawing: head 14 dia x 3.2, button 7.4, M12 x 1 body 36.35
# behind the head, panel up to 10, nut 16.2 across corners (thickness 2.0 assumed), 1NO1NC 48 V 2 A
SW_HEAD_D, SW_HEAD_T, SW_BTN_D, SW_BODY_L, SW_THREAD_D = 14.0, 3.2, 7.4, 36.35, 12.0
SW_NUT_AC, SW_NUT_T = 16.2, 2.0
SW_HOLE_D = 12.2
WIRE_HOLE_D = 7.0
WIRE_HOLES = []                              # both devices inside the tube: their leads stay on the disc top
# S1.24 trim
TRIM_R, TRIM_ANG = 80.0, (45.0, 135.0, 225.0, 315.0)
TRIM_TAP_D = 4.2
PI_MA, CAM_MA = V8.PI_MA, V8.CAM_MA
LED_MA = round(LEDR_MA_5V)                  # S1.29 WS2812 ring straight off the 5 V rail (no boost, I032)
BANK_WH, BANK_EFF = V8.BANK_WH, V8.BANK_EFF

# ------------------------------------------------------------------ S3 cage: tube-post cube, magnet-on mesh panels (ICD S3.1 .. S3.6)
# I030 (2026-10-21, Sawyer: "really the cage should be a structure that is put over some alu posts or soemthing like
# that, that forms a cube ideally the panels have magnets on them so you can pull any one off like a mesh door thing";
# "yeah frame footprint sounds good"): four 12 x 1 6061 tube posts at the deck corners in printed foot corners, a top
# square of four tubes in printed 3-way corners, five magnet-on mesh panels (parts/fp9_cage.py). The posts stand inboard
# of the clamp tabs (arm ends at 108, pads 124..151 stay free) and of the deck rail T-nut rows; each foot's tongue runs
# out to one M5 x 12 button head into a T-nut in the deck Y rail at (+-140, +-97), 3 clear of the tab arm end.
CAGE_P = 99.0                                # post axes at (+-99, +-99): node faces (panel plane) at 108.7
CAGE_FACE = CAGE_P + CG.NH                   # 108.7: inner face of every panel, outer faces of the corner nodes
CAGE_POST_L = 256.0                          # cut length: the top nodes' top face lands at Z 300 (the proposal's 300 tall cube)
CAGE_POST_Z0 = SHEET_Z1 + CG.FOOT_SOCK_Z     # 23: tube foot on the foot socket floor
CAGE_POST_Z1 = CAGE_POST_Z0 + CAGE_POST_L    # 279
CAGE_ZC = CAGE_POST_Z1 + CG.NODE_BOT         # 290.3: top node centre (the post top on the down socket's floor)
CAGE_TOP = CAGE_ZC + CG.NH                   # 300: top node top face = the top panel's inner face
TOP_RAIL_Z = CAGE_ZC + CG.ARM_DZ             # 290.9: the horizontal sockets sit 0.6 over the node centre
TOP_RAIL_L = 2 * (CAGE_P - CG.NH)            # 178.6: node face to node face (tube ends on the socket floors)
PANEL_Z0 = SHEET_Z1 + CG.EDGE_GAP            # 3.1: side panels' bottom edge, 0.1 over the deck sheet
CAGE_THUMBS = [(sx * RC, sy * (CAGE_P + CG.TONGUE_HOLE[1])) for sx in (1, -1) for sy in (1, -1)]   # (+-140, +-97)
CAGE_SIDES = {"back": (0.0, 1.0), "front": (0.0, -1.0), "right": (1.0, 0.0), "left": (-1.0, 0.0)}
DISC_TOP_Z = TUBE_TOP + TOP_DISC_T
CAGE_PULL_PAIR_KG = 0.8                      # assumed face-to-face pull of one D52 pair across the 0.1 gap (K&J case 1: 1.52 kg to steel)
DISC_FROG_H = 22.4                           # disc frog: top disc top to frog top (0.3 clear + mesh height)
VM = "motion/"


def _vec(*a):
    return np.array(a, float)


def _pol(r, ang):
    return (r * math.cos(math.radians(ang)), r * math.sin(math.radians(ang)))


def _polar(r, angles):
    return [_pol(r, a) for a in angles]


def _rotz(ang):
    c, s_ = math.cos(math.radians(ang)), math.sin(math.radians(ang))
    return _R([(c, s_, 0), (-s_, c, 0), (0, 0, 1)])


def _rz(ang):
    c, s_ = math.cos(math.radians(ang)), math.sin(math.radians(ang))
    return np.array([[c, -s_, 0], [s_, c, 0], [0, 0, 1.0]])


RY_UP = np.array([[1, 0, 0], [0, 0, -1], [0, 1, 0]], float)   # vendor local +Y (axis) -> world +Z


def _finish_print(s, print_face, outer=None, inner=0.0, foot=0.5, log=None):
    """DL7 finish for a printed part (cadkit.idioms.finish): every remaining convex edge filleted (outer, default the
    design-language radius for the part size, R 2 / R 4 over 40 mm), concave edges at `inner` (0 where a mating part
    sits in the corner), and the elephant-foot chamfer on the print face. Hole rims and print-plane edges are left to
    the chamfer; a failed edge keeps the previous valid solid (finish never raises)."""
    from cadkit.idioms import finish
    from lib.design_constants import fillet_printed
    s = _solid(s)
    bb = s.bounding_box()
    r = fillet_printed(max(bb.size.X, bb.size.Y, bb.size.Z)) if outer is None else outer
    out = finish(s, outer_r=r, inner_r=inner, print_face=print_face, foot=foot, log=log if log is not None else [])
    return _solid(out)


def _holes(s, pts, d, z0=-300.0, h=800.0):
    for x, y in pts:
        s = s - Cylinder(d / 2, h, align=(Align.CENTER, Align.CENTER, Align.MIN)).moved(Location((x, y, z0)))
    return s



# ------------------------------------------------------------------ frame, brackets, feet (v8)

def _frame(A):
    A.meta_role = {}
    z = (DECK_Z0 + DECK_Z1) / 2
    specs = [("deck_x_back", 2 * HALF, "x", (0, RC, z)), ("deck_x_front", 2 * HALF, "x", (0, -RC, z)),
             ("deck_y_right", 2 * RIN, "y", (RC, 0, z)), ("deck_y_left", 2 * RIN, "y", (-RC, 0, z)),
             ("cross_right", 2 * RIN, "y", (CROSS_X, 0, z)), ("cross_left", 2 * RIN, "y", (-CROSS_X, 0, z))]
    # DL29 / I020 / I021 (2026-10-16): the 2020 is the load-carrying core only, the deck square and the two cross rails
    # that carry the rotor, the drive cartridge and the cage; the base square is gone. I029 (2026-10-21): four legs at
    # the deck corners carry the deck to the plinth floor (the panels and the bottom sheet are skin).
    for sx in (1, -1):
        for sy in (1, -1):
            specs.append((f"leg_{_c(sx, sy)}", LEG_L, "z", (sx * LEG_XY, sy * LEG_XY, (LEG_TOP + LEG_BOT) / 2)))
    names = {}
    for n, (role, L, ax, c) in enumerate(specs, 1):
        s = P.rail(L, ax, c, n=role if role.startswith("leg_") else n)
        A.add(s.label, s, "rail", "frame", length_mm=L, axis=ax, centre=c, role=role, step=0)
        names[role] = s.label
        A.meta_role[s.label] = role
    A.meta_rails = names
    return names


def _cast_bracket(A, *args):
    """V8._bracket with the vendor row read from vendor/hardware/cast_bracket_2020_28/source.json (DL3)."""
    V8._bracket(A, *args)
    m = V.source("hardware/cast_bracket_2020_28")
    A.vendor[-1] = dict(component=args[0], source_url=m.get("url"), author=m.get("author"), licence=m.get("licence"),
                        file=m.get("file"), price_usd=m.get("price_usd"),
                        note="vendor/hardware/cast_bracket_2020_28/source.json (envelope from the listing dimensions)")


def _brackets(A, R_):
    zd = (DECK_Z0 + DECK_Z1) / 2
    for sx in (1, -1):
        for sy in (1, -1):
            c = _c(sx, sy)
            rx = R_[f"deck_x_{'back' if sy > 0 else 'front'}"]
            ry = R_[f"deck_y_{'right' if sx > 0 else 'left'}"]
            _cast_bracket(A, f"v_cast_bracket_2020_deck_corner_{c}", (sx * RIN, sy * RIN, zd), (0, -sy, 0),
                        (-sx, 0, 0), rx, ry, f"j_deck_corner_{c}")
            cross = R_["cross_right" if sx > 0 else "cross_left"]
            rx = R_[f"deck_x_{'back' if sy > 0 else 'front'}"]
            _cast_bracket(A, f"v_cast_bracket_2020_cross_end_{c}", (sx * (CROSS_X + W / 2), sy * RIN, zd), (0, -sy, 0),
                          (sx, 0, 0), rx, cross, f"j_cross_end_{c}")
            # I029: the leg hangs from the deck X rail's underside, one cast bracket on the leg's inboard X face (the key
            # says "upright", not "leg", so only the four rails are leg parts)
            _cast_bracket(A, f"v_cast_bracket_2020_upright_top_{c}", (sx * RIN, sy * LEG_XY, LEG_TOP), (0, 0, -1),
                          (-sx, 0, 0), rx, R_[f"leg_{c}"], f"j_upright_top_{c}")


# ------------------------------------------------------------------ plinth (v8 panels, deck sheet with the S1.4 holes)

def _hardpoint(A, x, y, module):
    name = f"v_deck_hardpoint_{x:g}_{y:g}"
    shape = Cylinder(5,3,align=(Align.CENTER,Align.CENTER,Align.MIN))-Cylinder(2.5,3,align=(Align.CENTER,Align.CENTER,Align.MIN))
    A.add(name,_solid(shape.moved(Location((x,y,0)))),"standoff",module,step=2,
          note="Stock aluminum spacer 5 ID / 10 OD / 3. Direct plate-to-2020 load path; acrylic footprint relieved.")
    A.vendor.append(dict(component=name,source_url="https://www.filastruder.com/products/m5-spacers-3mm-tall-10mm-od",author="Filastruder dimensions",file="assemblies/froggy_v12.py:_hardpoint",licence=None,price_usd=.398))
    return name


def _deck_sheet():
    """Deck sheet, cast acrylic 3 (navy, opaque), 300 x 300 on the deck ring top (S2.5): 66 x 126 centre opening between the cross rail inner
    faces (the S1.26 cartridge's motor plate, motor and spacers pass through it; plate A covers it in X, 3 of it stays
    open at each Y end), grommet hole, S1.4 plate A holes, 4 sheet screws, and the four S3.2 cage-foot screw
    holes 5.5 at (+-140, +-97) (no notches: the foot corners stand on it). The S1.1 spacers pass inside the opening (no separate holes)."""
    p = _box(-HALF, HALF, -HALF, HALF, SHEET_Z0, SHEET_Z1)
    ox, oy = DECK_OPEN
    p = p - _box(-ox / 2, ox / 2, -oy / 2, oy / 2, SHEET_Z0 - 1, SHEET_Z1 + 1)   # S2.5 cartridge opening
    for az in ROLLER_ANG:                                        # S1.27 block nylocs under plate A's arms
        for x, y in _az_pts(RB_HOLES, az):
            p = p - Cylinder(DECK_NUT_HOLE_D / 2, 40).moved(Location((x, y, 0)))
    p = p - Cylinder(G_D / 2, 40).moved(Location((G2[0], G2[1], 0)))
    clamp = [(sx * CT_HOLE, sy * RC) for sx in (1, -1) for sy in (1, -1)] + \
            [(sx * RC, sy * CT_HOLE) for sx in (1, -1) for sy in (1, -1)]           # S2.13 clamp tab bolts
    for x, y in PA_RAIL_HOLES + SHEET_SCREWS + CAGE_THUMBS + clamp:
        p = p - Cylinder(M5_HOLE / 2, 40).moved(Location((x, y, 0)))
    # Offset the actual rounded outer wires: rectangular proxies miss the filled concave fillets.
    from build123d import Face, Kind
    def relief(shape):
        candidates=[f for f,nrm,c in V.planar_faces(shape) if abs(abs(nrm[2])-1)<1e-6]
        face=max(candidates,key=lambda f:f.area)
        outline=Face(face.outer_wire().offset_2d(.5,kind=Kind.ARC))
        outline=outline.moved(Location((0,0,-1-outline.center().Z)))
        return extrude(outline,5)
    p -= relief(_plate_a())
    tab=relief(_clamp_tab_body())
    for angle in (0,90,180,270):
        p -= _az(tab,angle)
    return _solid(p)


def _panels(A, R_):
    A.meta_panels = {}
    for side in V8.SIDES:
        face, rep = _front_profile() if side == "front" else V8._side_profile(side)
        n = np.array(V8.SIDES[side][0], float)
        hv = np.array(V8.SIDES[side][1], float)
        panel = _solid(extrude(V8._plane(side) * face, amount=PANEL_T))
        for h in (-LEG_XY, LEG_XY):                 # I029: 2 x M5 per leg edge into the legs' outer slots
            for z in LEG_PANEL_Z:
                at = n * (V8.PANEL_IN - 1.0) + hv * h + _vec(0, 0, z)
                panel = panel - Plane(origin=tuple(at), z_dir=tuple(n)) * Cylinder(
                    M5_HOLE / 2, PANEL_T + 2.0, align=(Align.CENTER, Align.CENTER, Align.MIN))
        rep = dict(rep, screws=6, mount="skin (I029): hung from the deck rail's outer face (2 x M5 x 8 button head + "
                                        "T-nut) and the two corner legs' outer slots (2 x M5 x 8 + T-nut per leg)")
        A.add(f"s_panel_{side}", _solid(panel), "panel", "plinth", step=7,
              note="3 mm navy cast acrylic sheet, laser cut, skin only (I029): hung from the deck rail's outer face and "
                   "the two corner legs' outer slots; carries no load")
        A.meta_panels[side] = rep
        n = np.array(V8.SIDES[side][0], float)
        hv = np.array(V8.SIDES[side][1], float)
        for z, lvl in zip(V8.PANEL_SCREW_Z, ("deck",)):
            for h in (-V8.PANEL_SCREW_H, V8.PANEL_SCREW_H):
                at = n * V8.PANEL_IN + hv * h + _vec(0, 0, z)
                role = f"{lvl}_{'x' if abs(n[1]) > 0.5 else 'y'}_{side}"
                bolt_joint(A, [f"s_panel_{side}", R_[role]], at, -n, screw="M5x8",
                           name=f"j_panel_{side}_{lvl}_{'p' if h > 0 else 'n'}", module="plinth", contact="faces",
                           step=7, **M5)
        for h in (-LEG_XY, LEG_XY):
            for z, lvl in zip(LEG_PANEL_Z, ("top", "bot")):
                at = n * V8.PANEL_IN + hv * h + _vec(0, 0, z)
                c = _c(1 if at[0] > 0 else -1, 1 if at[1] > 0 else -1)
                bolt_joint(A, [f"s_panel_{side}", R_[f"leg_{c}"]], at, -n, screw="M5x8",
                           name=f"j_panel_{side}_leg_{c}_{lvl}", module="plinth", contact="faces", step=7, **M5)
    A.add("s_panel_deck", _deck_sheet(), "panel", "plinth", step=2,
          note="3 mm navy cast acrylic deck sheet, laser cut, on the deck ring top (Z 0..3); 50 centre hole, S1.4 holes, 4 cage-foot "
               "screw holes (S3.2)")
    for k, (x, y) in enumerate(SHEET_SCREWS, 1):
        role = "deck_x_back" if y > 0 else "deck_x_front"
        bolt_joint(A, ["s_panel_deck", R_[role]], (x, y, 0.0), (0, 0, -1), screw="M5x8", name=f"j_deck_sheet_{k}",
                   module="plinth", contact="faces", step=2, **M5)
    A.add("s_panel_bottom", _bottom_panel(), "panel", "plinth", step=7,
          note="3 mm navy cast acrylic bottom panel, laser cut, 300 x 300 inside the side panels (Z -123..-120): the faux "
               "bench-top floor (I021) that carries the plinth electrics, skin only (I029): clamped under the four leg "
               "ends by the foot bolts")


def _bottom_panel():
    """The v8 bottom panel without the base-rail screws and the foot notches: a full 300 x 300 sheet inside the side
    panels, clamped under the four leg ends by the foot bolts (one M5 x 16 each through the 5.5 hole at (+-140, +-140),
    S2.8, I029)."""
    p = _box(-HALF, HALF, -HALF, HALF, V8.BOTP_Z0, V8.BOTP_Z1)
    p = p - Cylinder(23.0, 20).moved(Location((0, 0, V8.BOTP_Z0)))
    x0, x1, y0, y1, _ = V8.PSU_BOX
    for x, y in [(x, y) for x in (x0 + 8, x1 - 8) for y in (y0 + 8, y1 - 8)]:
        p = p - Cylinder(1.7, 20).moved(Location((x, y, V8.BOTP_Z0)))
    for x, y in fp7_controller_carrier.INSERTS:
        wx, wy, _ = V8._cc_world(x, y)
        p = p - Cylinder(1.7, 20).moved(Location((wx, wy, V8.BOTP_Z0)))
    for x, y in V8._cl42t_holes():
        p = p - Cylinder(2.25, 20).moved(Location((x, y, V8.BOTP_Z0)))
    for sx in (1, -1):
        for sy in (1, -1):
            p = p - Cylinder(M5_HOLE / 2, 20).moved(Location((sx * LEG_XY, sy * LEG_XY, V8.BOTP_Z0)))
    return _solid(p)


def _feet(A, R_):
    """S2.8 feet (I029, DL29): per leg one bought rubber bumper foot 20 x 8 under the bottom panel on the leg axis, its
    5.5 through hole counterbored 10.5 x 5 from below, and one M5 x 16 button head up through the foot (3 of rubber under
    the head) and the bottom panel (3) into the leg's end tap (10 of thread in the 12 deep tap). The bolt clamps the
    sheet and the foot to the leg end: the load path to the table is aluminium and steel, the rubber only in compression;
    the head sits 2.25 inside the counterbore (DL1). Bench order: flip the frame, bottom panel on the leg ends, feet."""
    for sx in (1, -1):
        for sy in (1, -1):
            c = _c(sx, sy)
            fx, fy = sx * LEG_XY, sy * LEG_XY
            z0 = V8.BOTP_Z0 - V8.FOOT_H
            f = Cylinder(V8.FOOT_D / 2, V8.FOOT_H, align=(Align.CENTER, Align.CENTER, Align.MIN))
            f = f - Cylinder(M5_HOLE / 2, 3 * V8.FOOT_H)
            f = f - Cylinder(V8.FOOT_CB_D / 2, V8.FOOT_CB_H, align=(Align.CENTER, Align.CENTER, Align.MIN))
            nm = f"v_foot_bumper_{c}"
            A.add(nm, _solid(f).moved(Location((fx, fy, z0))), "foot", "feet", step=7,
                  note="bought rubber bumper foot 20 x 8 with a 5.5 through hole counterbored 10.5 x 5 (envelope, "
                       "assumed), under the bottom panel on the leg axis")
            A.vendor.append(dict(component=nm, source_url=None, author="catalogue (rubber bumper foot 20 x 8, M5 "
                                 "counterbored)", licence=None, file=None, price_usd=0.5))
            tapped_joint(A, [nm, R_[f"leg_{c}"]], (fx, fy, LEG_BOT), (0, 0, 1), screw=FOOT_SCREW, head="button",
                         seat=(fx, fy, z0 + V8.FOOT_CB_H), stack=[("s_panel_bottom", PANEL_T)],
                         name=f"j_foot_{c}_leg", module="feet", evaluate=False, step=7, tap_depth=LEG_TAP_DEPTH)


def _clamp_tab_body():
    """lp_clamp_tab at the back right deck corner (mirrored for the others): an L of two 22 wide arms along the deck
    rails' top-slot lines, 6061 6 mm (PLATE_T) off the Fablight, through holes only, outside corners R 3, the inside
    corner R 2 (DL8). The open corner square (x, y 124..151, 27 x 27) is the clamp pad: no head stands in it."""
    from build123d import Face, Kind, Polygon
    e, a, w = CT_EDGE, CT_ARM_END, CT_ARM_IN
    f = Polygon((a, w), (w, w), (w, a), (e, a), (e, e), (a, e), align=None)
    wire = f.faces()[0].outer_wire() if hasattr(f, "faces") else f.outer_wire()
    r_in, r_out = LASER["corner_inside"], LASER["corner_outside_min"]
    for d in (r_in, -r_in, -r_out, r_out):          # closing rounds the inside corner, opening the outside ones
        wire = wire.offset_2d(d, kind=Kind.ARC)
    s = _solid(extrude(Face(wire).moved(Location((0, 0, CT_Z0))), CT_T))
    return s


def _clamp_tabs(A, R_):
    """S2.13 quick-clamp points (I023, DL29): four lp_clamp_tab L plates on the deck sheet over the deck rail corners,
    each 2 x M5 x 14 button head down through the tab and the sheet into T-nuts in the two deck rails' top slots (the
    S1.4 stack). An F clamp or wood clamp presses the pad square onto the 2020 core and grips under the bench top; its
    bar stands outside the plinth corner, the jaw passes over the panel top edges (Z 3) and lands on the tab (Z 9)."""
    from build123d import Plane as _P
    for sx in (1, -1):
        for sy in (1, -1):
            c = _c(sx, sy)
            nm = f"lp_clamp_tab_{c}"
            t = _clamp_tab_body()
            if sx < 0:
                t = t.mirror(_P.YZ)
            if sy < 0:
                t = t.mirror(_P.XZ)
            holes = [((sx * CT_HOLE, sy * RC), R_[f"deck_x_{'back' if sy > 0 else 'front'}"]),
                     ((sx * RC, sy * CT_HOLE), R_[f"deck_y_{'right' if sx > 0 else 'left'}"])]
            t = _holes(t, [h for h, _ in holes], M5_HOLE)
            A.add(nm, _solid(t), "plate", "frame", step=2,
                  note=f"laser part, 6061 {CT_T:g} mm Fablight quick-clamp tab (S2.13, I023): L arms along the deck rail "
                       f"slot lines, pad square 27 x 27 at the corner for an F clamp or wood clamp jaw (assumed reach "
                       f"{CLAMP_JAW['reach']:g}, thick {CLAMP_JAW['thick']:g}, pad {CLAMP_JAW['pad']:g})")
            for i, ((x, y), rail) in enumerate(holes, 1):
                hp = _hardpoint(A,x,y,"frame")
                bolt_joint(A, [nm, rail], (x, y, 0.0), (0, 0, -1), screw="M5x14", name=f"j_clamp_tab_{c}_{i}",
                           module="frame", step=2, stack=[(hp, PANEL_T)], **M5)


def _electrics(A):
    """v8 plinth electrics; the printed carrier and legend ring renamed fp9_ (DESIGN-RULES 1).
    fp9_controller_carrier - justification: a tray with Pico standoff bosses and insert pockets on the plinth floor.
    fp9_estop_cradle - justification: in parts/fp9_estop_cradle.py (holds the recessed e-stop station behind the panel).
    The e-stop is the complete BACO LBX10510 station (S2.10) recessed through the front panel's 76 x 76 opening on
    fp9_estop_cradle; the v8 panel e-stop and its printed legend ring are gone."""
    R = _R([(0, 1, 0), (0, 0, 1), (1, 0, 0)])
    A.add("v_cl42t_driver", copy.deepcopy(V7._cl42t_src()).moved(_location(R, np.array([V8.CL42T_X0, 0.0, V8.FLOOR_Z]))),
          "driver", "electrical", step=7,
          includes="STEPPERONLINE CL42T-V41 closed-loop driver (representative of the vendor STEP)")
    A.vendor.append(dict(V.manifest_entry("v_cl42t_driver", "v_cl42t"),
                         note="representative solid derived from the vendor STEP (housing kept, terminals as boxes)"))
    x0, x1, y0, y1, h = V8.PSU_BOX
    psu = _box(x0, x1, y0, y1, V8.FLOOR_Z, V8.FLOOR_Z + h)
    A.meta_psu_holes = [(x, y) for x in (x0 + 8, x1 - 8) for y in (y0 + 8, y1 - 8)]
    for x, y in A.meta_psu_holes:
        psu = psu - Cylinder(1.25, 6.0, align=(Align.CENTER, Align.CENTER, Align.MIN)).moved(Location((x, y, V8.FLOOR_Z)))
    A.add("v_psu_lrs_50_24", _solid(psu), "enclosure", "electrical", step=7,
          note="MEAN WELL LRS-50-24 envelope 99 x 82 x 30, 4 x M3 tapped in the base")
    A.vendor.append(V.manifest_entry("v_psu_lrs_50_24", "v_psu_lrs_50_24"))
    cc = fp7_controller_carrier
    A.add("fp9_controller_carrier", _finish_print(cc.build(), "-Z", outer=2.0).moved(Location((V8.CC_DX, 0, V8.CC_DZ))), "printed", "electrical", step=7,
          note="PETG tray (v7 fp7_controller_carrier geometry); justification: Pico bosses + insert pockets, no stock tray")
    A.add("v_pico", HW.pcb_box(21, 51, label="v_pico").moved(Location(V8._cc_world(*cc.PICO_C, cc.T + cc.BOSS_H))), "pcb",
          "electrical", step=7)
    A.vendor.append(V.manifest_entry("v_pico", "v_pico"))
    A.add("v_buck_module", _solid(Box(43, 21, 14, align=(Align.CENTER, Align.CENTER, Align.MIN))).moved(
        Location(V8._cc_world(*cc.BUCK_C, cc.T))), "pcb", "electrical", step=7)
    A.vendor.append(V.manifest_entry("v_buck_module", "v_buck_module"))
    A.add("v_relay_delay", _solid(Box(50, 26, 18, align=(Align.CENTER, Align.CENTER, Align.MIN))).moved(
        Location(V8._cc_world(*cc.RELAY_C, cc.T))), "pcb", "electrical", step=7)
    A.vendor.append(V.manifest_entry("v_relay_delay", "v_relay_delay"))
    A.add("fp9_estop_cradle", _estop_cradle(), "printed", "electrical", step=7,
          note="PETG open frame behind the front panel: flange on the panel's inner face (4 x M3 x 10 button head from "
               "outside into heat-set inserts), walls hugging the station, back gussets carrying its 2 base slots "
               "(2 x M4 x 12 button head + nyloc), -X cable window at the M16/20 knockout; prints flat on the flange")
    station, st_bodies, screws, sc_bodies = _estop_parts()
    cover = next(c for c in station.children if c.label == f"{ESTOP}_cover")
    A.meta_es_proud = ES_Y0 - cover.bounding_box().min.Y          # cover face outside the panel's outer face
    A.add(ESTOP, station, "switch", "electrical", step=7, bodies=st_bodies,
          includes="BACO LBX10510 IP69K one-hole 22 mm control station, manufacturer STEP: base (2 x 4.5 slots, "
                   "diagonal), yellow cover, 22 mm operator with the 40 mm red mushroom head, 1 NC contact block; "
                   f"recessed through the front panel's {ES_OPEN:g} x {ES_OPEN:g} opening at X {ES_XC:g}, Z {ES_ZC:g}, "
                   f"cover face {ES_PROUD:g} proud, back on fp9_estop_cradle (S2.10). One component: the STEP's own "
                   "bodies overlap (snap fits, threads), so they stay together")
    A.add(ESTOP + "_cover_screws", screws, "switch", "electrical", step=12, bodies=sc_bodies,
          note="BACO LBX station: 4 cover screws and their 4 captive nuts, from the STEP (S2.10)")
    for nm in (ESTOP, ESTOP + "_cover_screws"):
        A.vendor.append(V.vendor_entry(nm, "electrical/baco_lbx10510"))
    x, w, hh, ya, yb = V8.IEC
    fw, fh, ft = V8.IEC_FLANGE
    iec = V8._dev_body(x, w, hh, ya, yb)
    iec = iec + _box(x - fw / 2, x + fw / 2, V8.PANEL_IN - ft, V8.PANEL_IN, V8.PANEL_DEV_Z - fh / 2, V8.PANEL_DEV_Z + fh / 2)
    for sx in (-1, 1):
        iec = iec - Plane(origin=(x + sx * V8.IEC_PITCH / 2, V8.PANEL_IN + 1, V8.PANEL_DEV_Z), z_dir=(0, -1, 0)) * Cylinder(
            1.25, ft + 2, align=(Align.CENTER, Align.CENTER, Align.MIN))
    A.add("v_iec_inlet", _solid(iec), "switch", "electrical", step=7,
          note="IEC C14 inlet with fuse drawer, rear-mount (representative envelope)")
    A.vendor.append(V.manifest_entry("v_iec_inlet", "v_iec_inlet"))
    x, w, hh, ya, yb = V8.USB
    A.add("v_usb_panel", _solid(V8._dev_body(x, w, hh, ya, yb)), "switch", "electrical", step=7,
          note="USB-C panel-mount extension through the back panel")
    A.vendor.append(V.manifest_entry("v_usb_panel", "v_usb_panel"))
    A.add("v_grommet_g2", V7._grommet(SHEET_Z1, PANEL_T, "v_grommet_g2").moved(Location((G2[0], G2[1], 0))),
          "grommet", "plinth", step=7)
    A.vendor.append(V.manifest_entry("v_grommet_g2", "v_grommet_8mm"))


# ------------------------------------------------------------------ S1 vendor parts (goBILDA STEPs)

@lru_cache(maxsize=None)
def _step_solids(rel):
    return import_step(V.os.path.join(V.VENDOR, rel)).solids()


def _axial_loc(src_axis_pt, z, ang=0.0, src_axis_end=None):
    """Location taking a vendor part whose axis is its local Y to world Z: the local point src_axis_pt (on the axis,
    at the face that lands at world Z z) goes to (0, 0, z); turned `ang` deg about Z."""
    R = _rz(ang) @ RY_UP
    t = np.array([0.0, 0.0, z]) - R @ np.asarray(src_axis_pt, float)
    return _location(R, t)


def _block_parts():
    """goBILDA 1614-0016-4008 STEP: housing (566 faces, 16 mm M4 pattern both ends, four oval slots), two bearings,
    four shields. Axis local Y, ends at Y 8.894 and 24.894."""
    sols = _step_solids(VM + "gobilda_1614_pillow_block/1614-0016-4008.step")
    housing = max(sols, key=lambda s: s.volume)
    hb = housing.bounding_box()
    c = ((hb.min.X + hb.max.X) / 2, hb.min.Y, (hb.min.Z + hb.max.Z) / 2)
    rest = [s for s in sols if s is not housing]
    lower = [s for s in rest if s.bounding_box().max.Y < (hb.min.Y + hb.max.Y) / 2]
    upper = [s for s in rest if s not in lower]
    return housing, lower, upper, c


def _squeeze_y_axis(sol, k, axis_pt):
    """Scale a local-Y-axis part by k across its axis (running clearance on the REX section)."""
    from OCP.BRepBuilderAPI import BRepBuilderAPI_GTransform
    from OCP.gp import gp_GTrsf, gp_Mat, gp_XYZ
    g = gp_GTrsf()
    g.SetVectorialPart(gp_Mat(k, 0, 0, 0, 1, 0, 0, 0, k))
    g.SetTranslationPart(gp_XYZ(axis_pt[0] * (1 - k), 0, axis_pt[2] * (1 - k)))
    return Solid(BRepBuilderAPI_GTransform(sol.wrapped, g, True).Shape())


@lru_cache(maxsize=None)
def _shaft_src():
    """goBILDA 2106-4008-0720 STEP: REX shaft. The STEP ships the e-clip installed; only the shaft solid is kept (the
    factory e-clip comes off before assembly: the groove end is down, inside the lower 1522 backup spacer)."""
    sols = _step_solids(VM + "gobilda_2106_rex_shaft_72/2106-4008-0720.step")
    sh = max(sols, key=lambda s: s.volume)
    b = sh.bounding_box()
    c = ((b.min.X + b.max.X) / 2, b.min.Y, (b.min.Z + b.max.Z) / 2)
    return copy.deepcopy(sh), c  # preserve analytic end faces and tapped bores


@lru_cache(maxsize=None)
def _hub_src():
    sols = _step_solids(VM + "gobilda_1313_hyper_hub/1313-1632-4008.step")
    return sols                                             # body + 2 pinch bolts; flange face Z 0, boss bottom Z -20


# ------------------------------------------------------------------ S1 laser parts

def _plate(x, y, z0):
    return _box(-x / 2, x / 2, -y / 2, y / 2, z0, z0 + PLATE_T)


PA_R_OUT = 8.0          # lp_plate_a outline: every convex corner R 8 (arm ends, square corners)
PA_R_IN = 6.0           # every concave corner (arm roots) R 6


def _round_outline(face, r_out, r_in):
    """2D outline rounding for a laser plate: closing by r_in (offset out, then back in) rounds every concave corner to
    r_in, opening by r_out (in, then out) rounds every convex corner to r_out. Arcs and lines only (DXF friendly)."""
    from build123d import Face, Kind
    w = face.outer_wire()
    for d in (r_in, -r_in, -r_out, r_out):
        w = w.offset_2d(d, kind=Kind.ARC)
    return Face(w)


def _plate_a():
    """lp_plate_a, 6061 6.0, 120 x 120 on the deck sheet, the cartridge base plate (S1.26). Fablight cut: a 2D outline
    and through holes only. Outline: the 120 square and three arms 38 wide out to r 100 at 90 / 210 / 330 deg (S1.27),
    every convex corner R 8 (PA_R_OUT) and every concave corner where an arm meets the square R 6 (PA_R_IN). Hole table:
    (0, 0) 16 for the shaft and the 9.95 OD race spacer (fix A, I033), S1.4 and S1.6;
    (+-45, +-40) 5.5 x 4 through the sheet into the cross-rail T-nuts (the only cartridge-to-frame fasteners), S1.4;
    (+-21, +1/-45) 5.5 x 4 spacer bolts M5 x 50 down through the spacers and 3 mm spacers to the motor plate slab, S1.1 (I037);
    (+-8, +-8) 4.3 x 4 pillow block M4 from below, S1.5;
    each arm 4.5 x 2 at block-local (r 76, t +-8): fp12_roller_block M4 x 16 + nyloc under the plate (the nylocs hang
    through 12 holes in the deck sheet), S1.27;
    2 x 2.5 tapped M3 through at (u 67.3, v 0.6 / 7.0) in the 45 deg frame, i.e. (47.2, 48.0) and (42.6, 52.5):
    fp9_hall_bracket, S1.31 (edge margin 7.5).
    Edge margins: rail holes 15 / 20 to the square's edges, arm holes 11 to the arm sides and 24 to the arm end."""
    from build123d import Face, Polygon
    pts_sq = [(-PA_SIZE / 2, -PA_SIZE / 2), (PA_SIZE / 2, -PA_SIZE / 2), (PA_SIZE / 2, PA_SIZE / 2),
              (-PA_SIZE / 2, PA_SIZE / 2)]
    face = Polygon(*pts_sq, align=None).faces()[0]
    for az in ROLLER_ANG:                                        # S1.27: three arms out to the rim rollers
        arm = _az_pts([(40.0, -ARM_HALF_W), (ARM_X1, -ARM_HALF_W), (ARM_X1, ARM_HALF_W), (40.0, ARM_HALF_W)], az)
        face = face + Polygon(*arm, align=None).faces()[0]
    face = max(face.faces(), key=lambda q: q.area)
    face = _round_outline(face, PA_R_OUT, PA_R_IN)
    p = extrude(face.moved(Location((0, 0, PA_Z0))), PLATE_T)
    p = _holes(p, [q for az in ROLLER_ANG for q in _az_pts(RB_HOLES, az)], 4.5)
    p = _holes(p, [(0, 0)], PA_CENTRE_D)
    p = _holes(p, PA_RAIL_HOLES, M5_HOLE)
    p = _holes(p, SPACER_XY, M5_HOLE)
    p = _holes(p, BLOCK_HOLES, BLOCK_HOLE_D)
    p = _holes(p, [_hall_xyz(u, v, 0)[:2] for u, v in HB_HOLES], 2.5)   # S1.31 tapped M3
    return _solid(p)


# BACO LBX10510 STEP solids (file order) -> (body label, material). Indices read off the file 2026-10-12.
ES_STATION_BODIES = [
    (1, "base", "black_plastic"), (0, "cover", "estop_yellow"), (10, "operator_ring", "black_plastic"),
    (11, "operator_flange", "black_plastic"), (12, "operator_body", "black_plastic"),
    (13, "operator_plunger", "black_plastic"), (14, "head_40mm", "estop_red"), (15, "head_insert", "black_plastic"),
    (16, "contact_block", "black_plastic"), (17, "contact_block_inner", "black_plastic"),
    (18, "terminal_screw_1", "steel_zinc"), (19, "terminal_screw_2", "steel_zinc"), (20, "terminal_1", "brass"),
    (21, "terminal_2", "brass"), (22, "terminal_clamp_1", "steel_zinc"), (23, "terminal_clamp_2", "steel_zinc"),
    (24, "contact_plunger", "black_plastic"), (25, "contact_bridge", "estop_red")]
ES_SCREW_BODIES = [(i, f"cover_screw_{i - 1}", "steel_zinc") for i in (2, 3, 4, 5)] + \
                  [(i, f"cover_nut_{i - 5}", "steel_zinc") for i in (6, 7, 8, 9)]


def _estop_loc():
    """STEP -> world for the BACO station: box centre to (ES_XC, ES_ZC), head toward the operator (-Y, 180 deg about
    Z), then 90 deg about Y so the knockouts face +-X (bottom knockout to -X), cover face at ES_FACE_Y."""
    bx, bz = ES_BOX_C_LOCAL
    return (Location((ES_XC, ES_FACE_Y + ES_FACE_LOCAL_Y, ES_ZC)) * Location((0, 0, 0), (0, 90, 0))
            * Location((0, 0, 0), (0, 0, 180)) * Location((-bx, 0, -bz)))


def _estop_parts():
    """BACO LBX10510 control station (S2.10) from the manufacturer's STEP (vendor/electrical/baco_lbx10510), all 26
    solids: base, yellow cover, 22 mm operator with the 40 mm red head, NC contact block and terminals, 4 cover screws
    and their nuts. Placed by _estop_loc: recessed through the front panel's 76 x 76 opening, cover face ES_PROUD
    outside the panel, back pads on fp9_estop_cradle at ES_BACK_Y. Returns (station compound, its bodies, cover screws
    + nuts compound, their bodies). Two components (station, screws) because BACO's own bodies overlap (snap fits,
    threads) inside each group."""
    path = os.path.join(V.ROOT, ES_STEP)
    raw = V.import_step_solids(path)
    assert len(raw) == 26, f"BACO STEP: expected 26 solids, got {len(raw)}"
    loc = _estop_loc()

    def group(rows):
        sols = [raw[i].moved(loc) for i, _, _ in rows]
        for s, (_, lbl, _) in zip(sols, rows):
            s.label = f"{ESTOP}_{lbl}"
        return Compound(children=sols), [(f"{ESTOP}_{lbl}", mat) for _, lbl, mat in rows]
    st, st_b = group(ES_STATION_BODIES)
    sc, sc_b = group(ES_SCREW_BODIES)
    used = sorted(i for i, _, _ in ES_STATION_BODIES + ES_SCREW_BODIES)
    assert used == list(range(26)), "BACO STEP: every solid must be placed exactly once"
    return st, st_b, sc, sc_b


def _estop_cradle():
    """fp9_estop_cradle (parts/fp9_estop_cradle.py) placed: flange on the front panel's inner face round the opening,
    local Y = world -Z, local Z = world +Y (depth into the plinth)."""
    pl = Plane(origin=(ES_XC, ES_PANEL_IN, ES_ZC), x_dir=(1, 0, 0), z_dir=(0, 1, 0))
    return _solid(pl * _finish_print(fp9_estop_cradle.build(), "-Z", outer=2.0))   # DL7 finish, flange face on the bed


def _front_profile():
    """Front panel (S2.6 / S2.10): the v8 front panel outline and 4 screw holes, with the 76 x 76 (R 4) opening for the
    recessed BACO station centred at (X ES_XC, Z ES_ZC) and 4 x 3.4 holes for the M3 x 10 button heads into the
    fp9_estop_cradle inserts. The cradle's lip (its flange edge 0.8 inside the opening, 0.2 off the box) closes the
    1 mm clearance gap from behind; the cable leaves the station through its M16/20 knockout on the -X side."""
    from build123d import RectangleRounded
    e = HALF + PANEL_T
    face = V7._rect(-e, e, V8.BOTP_Z0, SHEET_Z1)
    holes = [V7._circ(h, z, M5_HOLE / 2) for h in (-V8.PANEL_SCREW_H, V8.PANEL_SCREW_H) for z in V8.PANEL_SCREW_Z]
    holes += [V7._circ(x, z, 3.4 / 2) for x, z in ES_CR_SCREWS]           # front: h = +X, so (h, z) = (X, Z)
    holes += [RectangleRounded(ES_OPEN, ES_OPEN, ES_OPEN_R).faces()[0].moved(Location((ES_XC, ES_ZC, 0)))]
    for f in holes:
        face = face - f
    face = max(face.faces(), key=lambda q: q.area)
    rep = dict(side="front", screws=4, mount="face-mounted on the rails' outer faces, 4 x M5 x 8 button head + T-nut",
               estop=dict(part=ESTOP, opening=[ES_OPEN, ES_OPEN], opening_r=ES_OPEN_R, centre=[ES_XC, ES_ZC],
                          cradle="fp9_estop_cradle", cradle_screws=[list(h) for h in ES_CR_SCREWS],
                          cover_proud_mm=ES_PROUD, cable="M16/20 knockout on the station's -X side, cradle window"))
    return V7._clean_face(face), rep


def _az(solid, az):
    """Turn a part built on the +X axis to azimuth `az` (deg, CCW about Z)."""
    return solid.moved(_location(_rotz(az), (0, 0, 0)))


def _az_pts(pts, az):
    c, s_ = math.cos(math.radians(az)), math.sin(math.radians(az))
    return [(x * c - y * s_, x * s_ + y * c) for x, y in pts]


def _xcyl(r, x0, x1, z, y=0.0):
    """Cylinder of radius r along +X from x0 to x1, axis at (y, z)."""
    return Plane(origin=(x0, y, z), z_dir=(1, 0, 0)) * Cylinder(r, x1 - x0, align=(Align.CENTER, Align.CENTER, Align.MIN))


def _roller(az):
    """Official Creality POM wheel, two 625 bearings and internal shim; radial horizontal axle."""
    return [_az(q.moved(Location((ROLLER_R, 0, ROLLER_Z))), az) for q in RW.kit()]


def _axle_spacer(az):
    x0 = ROLLER_R + BRG_W / 2
    return _az(_solid(_xcyl(5, x0, x0 + 1, ROLLER_Z) - _xcyl(2.5, x0 - 1, x0 + 2, ROLLER_Z)), az)


def _axle_hw(az):
    """M5x25 ISO4762 screw, 1 mm precision inner washer, DIN985 M5 nyloc.
    Simplified nominal fastener surfaces; thread helices omitted, socket included.
    Stack: support 4 + outer shim 1 + kit 11 + inner shim 1 + nut 5 = 22.
    """
    from build123d import RegularPolygon
    z, xw = ROLLER_Z, RB_X1
    head = _xcyl(4.25, xw, xw+5, z)
    head -= Plane(origin=(xw+2,0,z), z_dir=(1,0,0))*extrude(RegularPolygon(2/math.cos(math.pi/6),6),amount=4)
    screw = head + _xcyl(2.5, xw-25, xw, z)
    xn = ROLLER_R-BRG_W/2
    washer = _xcyl(5,xn-1,xn,z)-_xcyl(2.5,xn-2,xn+1,z)
    nut = Plane(origin=(xn-6,0,z),z_dir=(1,0,0))*extrude(RegularPolygon(4/math.cos(math.pi/6),6),amount=5)
    nut -= _xcyl(2.5,xn-7,xn,z)
    return [_az(_solid(q),az) for q in (screw,washer,nut)]


RB_R_PLAN = 4.0         # fp12_roller_block: the four plan corners R 4 (the two back ones run out at 45 deg to the back face)
RB_R_TOP = 1.5          # outboard wall top edges (not the back edge: the bed perimeter of the back-down print)
RB_R_EDGE = 1.0         # the gussets' top edges and the flush outline (base top front, gusset outer edges, wall inboard corners)
RB_R_STEP = 5.0         # the concave corner where each gusset's hypotenuse meets the wall's inboard face (Sawyer's drawing A,
                        # 2026-11-01: R 2 or larger; R 5 still leaves 2.9 to the disc)
RB_R_BASE = 5.0         # concave coves where the outboard wall and the gussets stand on the base, and the gusset foot (Sawyer 2026-11-01)
RB_R_CORNER = 3.0       # the two vertical inside corners gusset / outboard wall, held there by the tyre's 1 mm clearance
RB_GUSSET_Z1 = DISC_Z0  # 45: each gusset's straight hypotenuse meets the wall's inboard face at the disc underside (drawing A)
RB_GUSSET_TOE = RB_X0 + RB_R_PLAN   # 71: the foot cove leaves the base top where the R 4 front corners end (flush face stays one plane)
RB_COVE_X0, RB_COVE_RUN = 83.0, 78.0   # the gussets' inner R 5 coves run from r 83 to the wall; inboard of that they run out
                                       # (R 5 smoothstep) to nothing at r 78, so they stay >= 1.5 off the M4 heads' 7 OD and hex key


def _rb_profile():
    """Side profile of a roller-block gusset (block-local r, world Z): the R 5 foot cove leaving the base top at the toe,
    the straight hypotenuse and the R 5 cove onto the wall's inboard face; the line lands on the base top at rL."""
    zb, rt = PA_Z1 + RB_BASE_T, RB_GUSSET_TOE
    rl = rt + 2.4
    for _ in range(80):
        th = math.atan((RB_GUSSET_Z1 - zb) / (RB_WALL_X0 - rl))
        rl = rt + RB_R_BASE * math.tan(th / 2)
    zc = RB_GUSSET_Z1 + (RB_R_STEP - RB_R_STEP * math.sin(th)) / math.cos(th)
    return dict(rl=rl, th=th, zc=zc)


def _rb_top_path(off=0.0):
    """The gusset's top curve in the XZ plane (Y 0), offset `off` down into the part."""
    from build123d import Edge, Wire
    p = _rb_profile()
    th, zc, zb = p["th"], p["zc"], PA_Z1 + RB_BASE_T
    s, c = math.sin(th), math.cos(th)
    cf, rf = (RB_GUSSET_TOE, zb + RB_R_BASE), RB_R_BASE + off
    cw, rw = (RB_WALL_X0 - RB_R_STEP, zc), RB_R_STEP + off
    ph = (math.pi / 2 - th) / 2 + th
    return Wire([
        Edge.make_three_point_arc((cf[0], 0, cf[1] - rf), (cf[0] + rf * math.sin(th / 2), 0, cf[1] - rf * math.cos(th / 2)),
                                  (cf[0] + rf * s, 0, cf[1] - rf * c)),
        Edge.make_line((cf[0] + rf * s, 0, cf[1] - rf * c), (cw[0] + rw * s, 0, cw[1] - rw * c)),
        Edge.make_three_point_arc((cw[0] + rw * s, 0, cw[1] - rw * c), (cw[0] + rw * math.sin(ph), 0, cw[1] - rw * math.cos(ph)),
                                  (cw[0] + rw, 0, cw[1]))])


def _roller_block(az):
    """PETG light-contact rim support and pinch guard, ICD-V12 S1.27, Sawyer's drawing A (2026-11-01): "model A like an
    industrial gusset with strengthening fillets on all internal corners appropriately". PRINTED ON ITS BACK (the outboard
    wall's r 99.5 face on the bed): layers stack along r. Base R67..99.5, width 34, thickness 4. Outboard wall R95.5..99.5 to
    Z 50, R 1.5 top. Two triangular gussets in the old side walls' lane (t +-13.05..17, 4 thick): R 5 foot cove off the base
    top at r 71, a straight hypotenuse (lands r 73.6, 55.7 deg) to the wall's inboard face at Z 45, R 5 cove onto the wall.
    Internal corners: R 5 wall / gusset to base (inner coves from r 83, run out by r 78 beside the M4 heads), R 3 vertical
    gusset / wall, R 5 hypotenuse / wall; R 1 on every gusset top edge and the flush outline. 5.4 wide full-round slot centre
    Z32.95 +/-2, M5 axle. Side clearance 1 mm. Two diameter 4.5 mounting holes at local (R76, t+/-8), M4x16 plus 5 mm nylocs.
    Justification: integrated axle adjustment and guard for light stabilizing contact only;
    it does not carry the rotor's normal gravity load. Physical print creep unqualified.
    """
    from build123d import Edge, Face, Polygon, Vertex, Wire, loft, sweep
    from OCP.BRepFilletAPI import BRepFilletAPI_MakeFillet
    from cadkit.brep import classify_edges
    from cadkit.idioms.finish import _chains, _key
    z0, zb = PA_Z1, PA_Z1 + RB_BASE_T
    x0, x1, xw, yo, ys, rt = RB_X0, RB_X1, RB_WALL_X0, RB_HALF_W, RB_SIDE_Y0, RB_GUSSET_TOE

    def box(xa, xb, ya, yb, za, zz):
        return Box(xb - xa, yb - ya, zz - za, align=(Align.MIN, Align.MIN, Align.MIN)).moved(Location((xa, ya, za)))

    def prism(f, za, zz):
        return extrude(f.moved(Location((0, 0, za))), zz - za, dir=(0, 0, 1))

    def sharp(s, pick, convex=True):  # real (non-tangent) edges only
        return [Edge(w) for w, info, _, _ in classify_edges(s.wrapped, min_len=0.05)
                if info["convex"] == convex and info["dihedral_deg"] > 20 and pick(Edge(w).bounding_box())]

    # plan: front corners R 4; back corners R 4 then a 45 deg run-out to the back face (no downward face past 45 deg back-down)
    es, ye = [], {}
    for sg, yf in ((1, yo), (-1, -yo)):
        cy = yf - sg * RB_R_PLAN
        t2 = (xw + RB_R_PLAN * math.sqrt(0.5), cy + sg * RB_R_PLAN * math.sqrt(0.5), 0)
        ye[sg] = t2[1] - sg * (x1 - t2[0])
        es += [Edge.make_three_point_arc((xw, yf, 0), (xw + RB_R_PLAN * math.sin(math.pi / 8), cy + sg * RB_R_PLAN * math.cos(math.pi / 8), 0), t2),
               Edge.make_line(t2, (x1, ye[sg], 0))]
    es += [Edge.make_line((x1, ye[-1], 0), (x1, ye[1], 0)), Edge.make_line((xw, yo, 0), (x0, yo, 0)),
           Edge.make_line((x0, yo, 0), (x0, -yo, 0)), Edge.make_line((x0, -yo, 0), (xw, -yo, 0))]
    pf = Face(Wire.combine(es)[0])
    pf = pf.fillet_2d(RB_R_PLAN, [v for v in pf.vertices() if abs(v.X - x0) < 1e-6])
    b = _solid(prism(pf, z0, zb) + (prism(pf, z0, RB_WALL_TOP) & box(xw, x1 + 1, -yo - 1, yo + 1, z0 - 1, RB_WALL_TOP + 1))).clean()

    # the gussets: their section (4 thick, inner top edge R 1) swept along the top curve, trimmed to the plan and the wall
    path = _rb_top_path()
    zone = prism(pf, zb - 1.5, RB_WALL_TOP + 5) & box(rt - 0.01, xw + 0.3, -yo - 1, yo + 1, zb - 1.5, RB_WALL_TOP + 5)
    sec_pl = Plane(origin=(rt, 0, 0), x_dir=(0, 1, 0), z_dir=(1, 0, 0))     # local (u, v) = (t, Z)
    gus = {}
    for sy in (1, -1):
        u0, u1 = sorted((sy * ys, sy * yo))
        sec = Polygon((u0, zb - 26), (u1, zb - 26), (u1, zb), (u0, zb), align=None).faces()[0]
        sec = sec.fillet_2d(RB_R_EDGE, [v for v in sec.vertices() if abs(v.X - sy * ys) < 1e-6 and abs(v.Y - zb) < 1e-6])
        gus[sy] = _solid(sweep(sec_pl * sec, path) & zone)

    # R 5 coves where the outboard wall and the gussets' outer runs (r >= 83) stand on the base: one OCCT pass on a body with
    # gusset stubs, so the corner blends are OCCT's; the stubs' ends at r 83 cut the inner coves square for the run-outs
    b2 = _solid(b + (gus[1] & box(RB_COVE_X0, xw + 1, -yo - 1, yo + 1, zb - 2, RB_WALL_TOP + 5))
                + (gus[-1] & box(RB_COVE_X0, xw + 1, -yo - 1, yo + 1, zb - 2, RB_WALL_TOP + 5))).clean()
    b2 = _solid(b2.fillet(RB_R_BASE, sharp(b2, lambda bb: abs(bb.min.Z - zb) < 1e-3 and abs(bb.max.Z - zb) < 1e-3 and (
        (abs(bb.min.X - xw) < 1e-3 and abs(bb.max.X - xw) < 1e-3)
        or (abs(abs(bb.min.Y) - ys) < 1e-3 and abs(bb.max.Y - bb.min.Y) < 1e-3 and bb.min.X > RB_COVE_X0 - 1e-3)), convex=False)))
    for sy in (1, -1):
        b2 = _solid(b2 + gus[sy])

    def cove_face(x, r, sy):        # the inner cove's section at r = x: base top, gusset face, R r arc
        yi, pl = sy * ys, Plane(origin=(x, 0, 0), x_dir=(0, 1, 0), z_dir=(1, 0, 0))
        a, bq, cq = (yi - sy * r, zb), (yi, zb), (yi, zb + r)
        m = (yi - sy * r + sy * r * math.sqrt(0.5), zb + r - r * math.sqrt(0.5))
        g = pl.from_local_coords
        return Face(Wire([Edge.make_line(g(a), g(bq)), Edge.make_line(g(bq), g(cq)), Edge.make_three_point_arc(g(cq), g(m), g(a))]))
    n = 6                           # (finer sections leave a zero-volume sliver at the tip in the union)
    for sy in (1, -1):              # the inner coves' run-out beside the M4 heads: R 5 smoothstep from r 83 to a point at r 78,
        # tangent to the full cove at r 83 (no crease)
        secs = [Vertex(RB_COVE_RUN, sy * ys, zb)] + [cove_face(RB_COVE_RUN + (RB_COVE_X0 - RB_COVE_RUN) * k / n,
                                                               RB_R_BASE * (3 * (k / n) ** 2 - 2 * (k / n) ** 3), sy) for k in range(1, n + 1)]
        b2 = _solid(b2 + loft(secs, ruled=False))

    # the vertical inside corners gusset / outboard wall: R 3 fills from the base coves up, their tops 1 mm (the shoulder R 1)
    # under the gusset's top curve, so the gusset's inner R 1 top edge runs on over them
    cap_path = _rb_top_path(off=RB_R_EDGE)
    for sy in (1, -1):
        ya, yb = sorted((sy * (ys - RB_R_CORNER), sy * (ys + 0.01)))
        fill = (box(xw - RB_R_CORNER, xw + 0.01, ya, yb, zb - 0.01, RB_WALL_TOP)
                - Cylinder(RB_R_CORNER, RB_WALL_TOP - zb + 2, align=(Align.CENTER, Align.CENTER, Align.MIN)).moved(
                    Location((xw - RB_R_CORNER, sy * (ys - RB_R_CORNER), zb - 1))))
        u0, u1 = sorted((sy * (ys - RB_R_CORNER - 1), sy * (ys + 0.5)))
        cap = sweep(sec_pl * Polygon((u0, zb - 27), (u1, zb - 27), (u1, zb - 1), (u0, zb - 1), align=None).faces()[0], cap_path)
        b2 = _solid(b2 + (fill & cap))

    # one OCCT pass: R 1 round the flush outline (base top front edge and R 4 corners, each gusset's outer top edge: foot cove,
    # hypotenuse, wall cove, then up the wall's inboard corners) with the wall top's R 1.5 (all but the back edge); apart,
    # either order fails in OCCT
    def flush(bb):
        return ((abs(abs(bb.min.Y) - yo) < 1e-3 and abs(bb.max.Y - bb.min.Y) < 1e-3 and bb.min.Z > zb - 1e-3 and bb.max.X < xw + 1e-3)
                or (bb.min.Z > zb - 1e-3 and bb.max.Z < zb + 1.5 and bb.max.X < x0 + RB_R_PLAN + 1e-3))
    mk = BRepFilletAPI_MakeFillet(b2.wrapped)
    for e in sharp(b2, flush):
        mk.Add(RB_R_EDGE, e.wrapped)
    for e in b2.edges():
        bb = e.bounding_box()
        if abs(bb.min.Z - RB_WALL_TOP) < 1e-3 and abs(bb.max.Z - RB_WALL_TOP) < 1e-3 and not abs(bb.min.X - x1) < 1e-3:
            mk.Add(RB_R_TOP, e.wrapped)
    mk.Build()
    b = _solid(Solid(mk.Shape()))

    w = RB_SLOT_W / 2               # the axle slot (unchanged), its inboard rim R 2 as before; its bed rim stays sharp
    b = b - box(xw - 1, x1 + 1, -w, w, ROLLER_Z - RB_SLOT_HALF, ROLLER_Z + RB_SLOT_HALF)
    for dz in (-RB_SLOT_HALF, RB_SLOT_HALF):
        b = b - _xcyl(w, xw - 1, x1 + 1, ROLLER_Z + dz)
    b = _solid(b)
    b = _solid(b.fillet(2.0, sharp(b, lambda bb: abs(bb.min.X - xw) < 1e-3 and abs(bb.max.X - xw) < 1e-3 and abs(bb.max.Y) < w + 1e-3)))

    # what is left, chain by chain and never on the bed (back) face: the base underside outline R 1, the R 3 fills' top edges
    skip = set()
    for _ in range(40):
        cands = [e for e, info, _, _ in classify_edges(b.wrapped, min_len=0.05)
                 if info["convex"] and info["dihedral_deg"] >= 20 and _key(e) not in skip
                 and not (abs(Edge(e).bounding_box().min.X - x1) < 1e-3 and abs(Edge(e).bounding_box().max.X - x1) < 1e-3)]
        if not cands:
            break
        ch = _chains(cands)[0]
        for r in (RB_R_EDGE, 0.75, 0.5):
            try:
                nb = _solid(b.fillet(r, [Edge(e) for e in ch]))
                if nb.is_valid:
                    b = nb
                    break
            except Exception:
                continue
        else:
            skip.update(_key(e) for e in ch)
    b = _holes(b, RB_HOLES, 4.5)    # unchanged clearance holes, cut last so their rims stay sharp seats
    return _az(_solid(b), az)


def _carrier_disc():
    """lp_carrier_disc, 6061 6.0, 186 dia, no cutouts other than this hole table (centre, dia, ICD row):
    (0, 0) 14.3 hub pilot boss, S1.8; r 22.63 at 75/165/255/345 deg 4.5 + 90 deg csk x 4, hub M4, S1.8;
    r 83 at 0 + 60k deg 3.3 x 6 tapped M4 through: ring B + bottom seat, S1.9 (screw tips stop 0.4 short of the
    underside: nothing below the disc); r 66 at 51.25 / 231.25 deg 4.2 x 2 tapped M5 through: drum post studs, S1.32 (stud
    tips 0.4 short of the underside);
    (4.0 +- 34, -3.1 +- 27.2) 3.4 x 4 camera mount (M3 x 10 button from below), S1.16; (+-29, 48 +- 11.5) 2.7 x 4 Pi standoffs, S1.18;
    (-48, 40) 12.2 switch bushing, S1.21; (-52, -36) 12.4 charge port, S1.22 (both inside the tube, S1.28);
    (the S1.23 LED driver holes are gone, I034); r 80 at 45/135/225/315 deg 4.2 x 4 tapped M5 trim, S1.24;
    r 76 at 0 / 180 deg 6.1 x 2 through: index magnets pressed and glued in from below, flush with the underside,
    capped on top by ring B, S1.30. (The 12 S1.14 LED holes are gone, 2026-10-12.)
    The underside band r 86..93 is the S1.27 rim-roller track (S1.28): nothing protrudes there."""
    t, z0 = DISC_T, DISC_Z0
    from build123d import Cone
    p = Cylinder(DISC_D / 2, t, align=(Align.CENTER, Align.CENTER, Align.MIN)).moved(Location((0, 0, z0)))
    p = _holes(p, [(0, 0)], HUB_PILOT_D + 0.3)
    k, r_edge, r_hole = 1.0, 4.19, 2.25  # ICD-V12: 90 degree,8.96 maximum top diameter,2.23 depth
    zc = DISC_Z1 - 0.29 - (r_edge - r_hole) / k
    r_top = r_edge + k * (0.29 + 1.0)
    for x, y in _polar(HUB_R32, HUB_HOLE_ANG):
        p = p - Cylinder(r_hole, 40).moved(Location((x, y, z0)))
        p = p - Cone(r_hole, r_top, DISC_Z1 + 1.0 - zc, align=(Align.CENTER, Align.CENTER, Align.MIN)).moved(
            Location((x, y, zc)))
    p = _holes(p, _polar(STACK_R, STACK_ANG), STACK_TAP_D)
    p = _holes(p, BR_SCREWS, 3.4)
    p = _holes(p, PI_HOLES, 2.7)
    p = _holes(p, [PORT_XY], PORT_HOLE_D)
    p = _holes(p, [SWITCH_XY], SW_HOLE_D)
    p = _holes(p, _polar(TRIM_R, TRIM_ANG), TRIM_TAP_D)
    p = _holes(p, _polar(MAG_R, MAG_ANG), MAG_HOLE_D)
    p = _holes(p, _polar(POST_R, POST_ANG), M5_TAP_D)         # S1.32 tapped M5 for the post studs
    return _solid(p)


def _lobed_ring(od, id_, z0, label):
    """Flat Fablight ring (3.175 6061) with a round lobe of r POST_LOBE_R inward round each S1.32 post hole (posts at
    r POST_R inside the tube, I014). The lobe sides run radially, tangent to the lobe circle, out into the ring; the
    two inside corners where they meet the bore are R 2 (DL8 corner_inside). Through-cut only."""
    s = HW.ring(od, id_, RING_T, label).moved(Location((0, 0, z0)))
    for ang in POST_ANG:
        x, y = _pol(POST_R, ang)
        lobe = Cylinder(POST_LOBE_R, RING_T, align=(Align.CENTER, Align.CENTER, Align.MIN)).moved(Location((x, y, z0)))
        L = id_ / 2 - POST_R + 4.0                              # tongue from the hole centre out past the bore
        tongue = Box(L, 2 * POST_LOBE_R, RING_T, align=(Align.MIN, Align.CENTER, Align.MIN)).moved(
            Location((x, y, z0), (0, 0, ang)))
        s = s + lobe + tongue
    s = _solid(s).clean()
    rb = id_ / 2
    corner = [e for e in s.edges() if e.geom_type == GeomType.LINE and abs(e.bounding_box().size.Z - RING_T) < 1e-4
              and abs(math.hypot(e.bounding_box().center().X, e.bounding_box().center().Y) - rb) < 0.05]
    s = _solid(s.fillet(LASER["corner_inside"], corner))
    return s


def _ring_b():
    """lp_ring_b, 6061 3.175 (Fablight, through holes only), ID 144 OD 186 (I036: the 150 x 2.5 tube foot r 72.5..75 fully on it), flat on the disc top under the bottom
    tube seat. Hole table: r 83 at 0 + 60k deg 4.5 x 6, the M4 x 10 BHCS from the seat counterbores into the disc
    threads, S1.9; r 66 at the POST_ANG pair 5.5 x 2 in two R 11 lobes inside the bore, the drum post studs, S1.32. Margins 11 to the ID, 10 to the OD (rule 6). Covers the two magnet holes (S1.30) and the trim
    holes from above."""
    s = _lobed_ring(RING_B[1], RING_B[0], DRUM_FLOOR, "lp_ring_b")
    s = _holes(s, _polar(STACK_R, STACK_ANG), STACK_HOLE_D)
    s = _holes(s, _polar(POST_R, POST_ANG), M5_HOLE)            # S1.32 post studs, in the two lobes
    s = _solid(s)
    s.label = "lp_ring_b"
    return s


def _ring_top():
    """lp_ring_top, 6061 3.175 (Fablight, through holes only), bezel ID 147 OD 186 on the top disc. Hole table:
    r 83 at 0 + 60k deg 4.5 x 6, M4 x 18 button head down through the bezel, the top disc and the top seat into hex
    nuts under the seat, S1.13; r 66 at the POST_ANG pair 5.5 x 2 in two R 11 lobes, M5 x 14 button into the drum posts, S1.32. Button heads, not countersunk: no countersinks in 3 mm sheet (rule 4) and the
    Fablight cuts through holes only. Margins 9.5 to the ID, 10 to the OD (rule 6)."""
    z0 = TUBE_TOP + TOP_DISC_T
    s = _lobed_ring(RING_TOP[1], RING_TOP[0], z0, "lp_ring_top")
    s = _holes(s, _polar(STACK_R, STACK_ANG), STACK_HOLE_D)
    s = _holes(s, _polar(POST_R, POST_ANG), M5_HOLE)            # S1.32 post screws, in the two lobes
    s = _solid(s)
    s.label = "lp_ring_top"
    return s


def _top_disc():
    """s_top_disc, cast acrylic 3.2, 186 OD (laser cut), on the tube rim and the top seat; 6 x 4.5 at r 83 for the
    S1.13 clamp screws and 2 x 5.5 at r 66 (POST_ANG) for the S1.32 post screws. The frog stands inside the bezel ID 147."""
    s = Cylinder(TOP_DISC_D / 2, TOP_DISC_T, align=(Align.CENTER, Align.CENTER, Align.MIN)).moved(
        Location((0, 0, TUBE_TOP)))
    s = _holes(s, _polar(STACK_R, STACK_ANG), STACK_HOLE_D)
    s = _holes(s, _polar(POST_R, POST_ANG), M5_HOLE)
    s = _solid(s)
    s.label = "s_top_disc"
    return s


def _revolve_profile(pts, fillets=()):
    """Solid of revolution about Z from a closed (r, z) polyline; fillets: [((r, z), radius), ...] rounds those
    profile corners (a revolved fillet on the ring's circular edge)."""
    from build123d import Axis, Polyline, make_face, revolve
    f = make_face(Polyline(*[(r, 0.0, z) for r, z in pts], close=True)).faces()[0]
    for (r, z), rad in fillets:
        vs = [v for v in f.vertices() if abs(v.X - r) < 1e-6 and abs(v.Z - z) < 1e-6]
        f = f.fillet_2d(rad, vs)
    return _solid(revolve(f, Axis.Z, 360))


def _tube_seat_bottom():
    """fp9_tube_seat_bottom (PETG). Justification: the socket that locates the tube foot and holds its silicone seal
    cannot be cut in flat Fablight stock (no machining, D1) and no vendor part fits a 150 tube; it carries no
    rotor load (the tube stands on ring B, the drum posts carry the top).
    Print orientation: flat on its outer (bottom) face, the face on ring B, counterbores open upward, no supports.
    Ring r 75.3..90 x 6 on ring B (Z 54.175..60.175, the wall band floor); its bore 150.6 (0.3 radial) is the 6 deep
    socket round the tube foot, silicone bead in the bore. (The 2 mm channel's inner wall is dropped so the tube foot
    stands on ring B and the posts are a stock 100 length.) Top outer and bore edges R 2 (the bore's is the lead-in).
    Hole table: r 83 at 0 + 60k deg: 4.5 through + 8.0 counterbore from the top to a 1.2 floor (M4 x 10 BHCS head 2.6
    below the top), S1.9. (The S1.32 drum posts stand inside the tube since 2026-10-13, I014: no post holes here.)
    Install: step 4, after ring B, the six M4 x 10 through it and ring B into the disc."""
    z0 = SEAT_B_Z0
    s = _revolve_profile([(SEAT_CH_R[1], z0), (SEAT_B_OUT_R, z0), (SEAT_B_OUT_R, SEAT_B_Z1), (SEAT_CH_R[1], SEAT_B_Z1)],
                         [((SEAT_B_OUT_R, SEAT_B_Z1), SEAT_FILLET), ((SEAT_CH_R[1], SEAT_B_Z1), SEAT_FILLET)])
    pts = _polar(STACK_R, STACK_ANG)
    s = _holes(s, pts, STACK_HOLE_D)
    for x, y in pts:
        s = s - Cylinder(SEAT_CB_D / 2, 20, align=(Align.CENTER, Align.CENTER, Align.MIN)).moved(
            Location((x, y, z0 + SEAT_CB_FLOOR)))
    return _finish_print(s, "-Z", outer=2.0)              # DL7: bed-face chamfer on the ring B face


def _tube_seat_top():
    """fp9_tube_seat_top (PETG). Justification: the bore that captures and bonds the tube top cannot be cut in flat
    Fablight stock (no machining, D1); it carries only the top disc's clamp, no rotor load.
    Print orientation: flat on its outer (top) face, the face under the top disc, no supports (a plain ring).
    Ring r 75.3..93 x 6 under the top disc (Z 188.175..194.175); its bore (150.6, 0.3 radial to the tube) captures the
    tube's top 6 mm, silicone bead in the bore; the tube rim is flush with the seat top so the disc bears on both.
    No inner channel wall: anything inside r 72.5 under the disc hides the top disc edge from the camera (camsim).
    Bottom outer and bore edges R 2 (the bore's is the tube lead-in). Hole table: r 83 at 30 + 60k deg 4.5 x 6, M4 x 18
    button + hex nut on the seat underside (outside the tube, inside r 86), S1.13 (the S1.32 posts stand inside the
    tube since 2026-10-13, I014: no post holes here). Install: step 6, slid over the
    tube top before the top disc."""
    from build123d import fillet
    z0, z1 = SEAT_T_Z0, TUBE_TOP
    s = _revolve_profile([(SEAT_CH_R[1], z0), (TOP_DISC_D / 2, z0), (TOP_DISC_D / 2, z1), (SEAT_CH_R[1], z1)],
                         [((TOP_DISC_D / 2, z0), SEAT_FILLET), ((SEAT_CH_R[1], z0), SEAT_FILLET)])
    s = _holes(s, _polar(STACK_R, STACK_ANG), STACK_HOLE_D)
    return _finish_print(s, "+Z", outer=2.0)              # DL7: bed-face chamfer on the top (print) face


def _drum_post():
    """M5 female-female round aluminium standoff POST_D OD x POST_L (vendor POST_VENDOR, listing dims), M5
    tapped 12 deep from each end (modelled at the 4.2 tap drill). Local: bottom face z 0, axis +Z."""
    s = Cylinder(POST_D / 2, POST_L, align=(Align.CENTER, Align.CENTER, Align.MIN))
    for z0 in (-0.01, POST_L - POST_TAP_DEPTH):
        s = s - Cylinder(M5_TAP_D / 2, POST_TAP_DEPTH + 0.01, align=(Align.CENTER, Align.CENTER, Align.MIN)).moved(
            Location((0, 0, z0)))
    return _solid(s)


def _magnet():
    """6 x 3 N42 disc magnet (vendor/hardware/magnet_6x3_n42, Total Element listing), axial, faces z 0 and 3."""
    return _solid(Cylinder(MAG_D / 2, MAG_T, align=(Align.CENTER, Align.CENTER, Align.MIN)))


def _led_ring():
    """WS2812B 16 LED ring from the Adafruit NeoPixel Ring 16 vendor STEP (vendor/electronics/ws2812_ring_16, I032):
    all 17 solids, board 44.45 OD x 31.75 hole x 1.6 then 16 x 5050 on r 19. Local (as in the STEP): board underside
    z 0, LEDs to +z. Returns (compound, bodies)."""
    raw = V.import_step_solids(os.path.join(V.ROOT, LEDR_STEP))
    assert len(raw) == 1 + LEDR_N, f"NeoPixel Ring 16 STEP: expected {1 + LEDR_N} solids, got {len(raw)}"
    names = ["v_led_ring_ws2812_board"] + [f"v_led_ring_ws2812_led_{i}" for i in range(1, LEDR_N + 1)]
    for sol, n in zip(raw, names):
        sol.label = n
    return Compound(children=list(raw)), [(names[0], "pcb_black")] + [(n, "smd_led_white") for n in names[1:]]


# KY-003 class A3144 hall breakout (Joy-it SEN-KY003HMS; listing 15 x 29 x 7 with the header): board 15 x 18.5 x 1.6,
# a 3.2 hole 4.5 from the board's inboard edge and 3 above its bottom edge, the A3144 (TO-92S 4.1 x 3.0 x 1.52) on its
# leads at the top edge, bent so the branded (sensing) face looks up; the 3 pads wired direct (header not fitted).
KY_W, KY_H, KY_T = 15.0, 18.5, 1.6
KY_HOLE = (4.5, 3.0)
TO92 = (4.1, 3.0, 1.52)


def _hall_frame():
    """(origin, u radial, v tangential) of the hall bracket frame at HALL_AZ."""
    c, s_ = math.cos(math.radians(HALL_AZ)), math.sin(math.radians(HALL_AZ))
    return np.array([c, s_, 0.0]), np.array([-s_, c, 0.0])


def _hall_xyz(u, v, z):
    ur, vt = _hall_frame()
    return tuple(ur * u + vt * v + np.array([0, 0, z]))


HB_BASE = (63.0, 79.6, -4.0, 10.0)           # fp9_hall_bracket base footprint (u0, u1, v0, v1) on plate A, R 3 plan corners
HB_BASE_T = 4.0
HB_COL = (71.0, 79.6, KY_T, 10.0)             # column; the board's face sits on its -v face (v = KY_T)
HB_COL_TOP = 39.0
HB_R_PLAN, HB_R_COL = 3.0, 2.0                # base plan corners, column vertical corners (DL7: outside R >= 2)
HB_HEAD_CLR_R = 5.5                           # scallop round the S1.4 M5 button head (ISO 7380 dk 9.5 + 0.75)
HB_R_BASE_TOP = 1.5                           # base top outer edges (4 thick base: R 1.5 + the 0.5 bed chamfer)
HB_R_LEDGE = 0.5                              # the 1.6 deep ledge's edges (the board's bottom edge sits on it)
HB_INSERT_D, HB_INSERT_L = 4.1, 6.0           # M3 heat-set pocket (cadkit table: M3 short insert 4.0 OD x 5.7)
HB_HOLES = [(67.3, 0.6), (67.3, 7.0)]         # 2 x M3 x 10 button into M3 threads tapped in plate A
SENSOR_U = MAG_R                              # the A3144 centre right under the magnet circle
KY_U0 = SENSOR_U - 5.0                        # board inboard edge (u 71), its top edge at the sensor
KY_Z1 = DISC_Z0 - HALL_GAP - TO92[2] - 0.48   # board top edge 41.0 (leads 0.48 to the TO-92 underside)
KY_Z0 = KY_Z1 - KY_H


def _convex_vertical(solid, e):
    """True when the vertical edge e of solid is an outside (convex) corner: a point just outside the corner
    along the bisector of its two faces' outward normals is outside the solid."""
    fs = [f for f in solid.faces() if any(e.is_same(x) for x in f.edges())]
    if len(fs) != 2:
        return False
    c = e.center()
    n = [f.normal_at(f.center()) for f in fs]
    d = (n[0] + n[1])
    if d.length < 1e-6:
        return False
    d = d.normalized()
    p = c + d * 0.3
    return not solid.is_inside(p)


def _hall_bracket():
    """fp9_hall_bracket (PETG). Justification: holds a 15 x 18.5 breakout on edge 2 mm under the disc at r 76 with
    a ledge against rotation and an M3 insert; a flat sheet bracket would need a bend and a tapped boss.
    Reference: the printed sensor stands of open-source encoder mounts (one base plate with two screws, one upright
    column, a support ledge): a rounded-plate base, a rounded column, every edge blended.
    Print orientation: flat on its base (the plate A face) on the bed, column up, no supports: the ledge under the
    board has a 45 deg underside; bed edges carry a 0.5 elephant-foot chamfer.
    Frame: u radial at 45 deg, v tangential. Base u 63..79.6, v -4..10, 4 thick, plan corners R 3, top edges R 1.5
    (rebuilt 2026-10-12, DL7: the old base put the M3 holes 0.6 from its edges and the insert pocket broke out of the
    column; a R 5.5 scallop clears plate A's S1.4 M5 button head at (45, 40)); column u 71..79.6, v 1.6..10 up to Z 39 (2.2 under the lowest swept rotor part there), flush with the base
    on its +u and +v faces, vertical corners R 2, top edges R 2; ledge v 0..1.6 at Z 20.5..22.5 under the board's bottom edge with a 45 deg underside (with the screw it stops
    the board turning). Column-to-base junction R 1 inside. Every other outside edge R 2 via cadkit finish().
    Hole table (u, v): (67.3, 0.6) and (67.3, 7.0) 3.4 x 2, M3 x 10 button into plate A (tapped M3), S1.31; column face
    (u 75.5, Z 25.5) M3 heat-set insert pocket 4.1 x 6 along +v (2.4 wall behind), M3 x 6 button through the board,
    S1.31. Install: on plate A on the bench (step 2, with the roller blocks), board on it before the disc goes on."""
    from build123d import Polygon
    ur, vt = _hall_frame()
    loc = _location(np.column_stack([ur, vt, [0, 0, 1]]), (0, 0, 0))

    u0, u1, v0, v1 = HB_BASE
    zb = PA_Z1 + HB_BASE_T
    cu0, cu1, cv0, cv1 = HB_COL
    # base and column flush on their +u and +v faces (one face each, no ledge round the column's back), then the
    # vertical corners rounded: R 3 on the shared back corners and the base's front corners, R 2 on the column's
    b = _solid(_box(u0, u1, v0, v1, PA_Z1, zb) + _box(cu0, cu1, cv0, cv1, zb - 0.01, HB_COL_TOP)).clean()
    ur_, vt_ = _hall_frame()                         # scallop round plate A's S1.4 M5 button head at (45, 40)
    hx, hy = next(p for p in PA_RAIL_HOLES if p[0] > 0 and p[1] > 0)
    hu, hv = hx * ur_[0] + hy * ur_[1], hx * vt_[0] + hy * vt_[1]
    b = _solid(b - Cylinder(HB_HEAD_CLR_R, 40).moved(Location((hu, hv, PA_Z1))))
    for rr in (HB_R_PLAN, HB_R_COL):
        vert = [e for e in b.edges() if e.geom_type.name == "LINE" and abs(e.tangent_at(0).Z) > 0.99
                and e.length > 1.0 and (rr == HB_R_COL or e.bounding_box().min.Z < PA_Z1 + 1e-3)
                and (rr == HB_R_PLAN or e.bounding_box().min.Z > PA_Z1 + 1e-3)]
        vert = [e for e in vert if _convex_vertical(b, e)]
        try:
            b = b.fillet(rr, vert)
        except ValueError:
            pass
    # ledge: v 0..cv0, top at the board's bottom edge, 45 deg underside, on the column face's flat between its R 2 corners
    prof = Polygon((0.0, KY_Z0), (cv0 + 0.01, KY_Z0), (cv0 + 0.01, KY_Z0 - 2.0 - cv0), (0.0, KY_Z0 - 2.0), align=None)
    led = extrude(Plane(origin=(cu0 + HB_R_COL + 0.5, 0, 0), x_dir=(0, 1, 0), z_dir=(1, 0, 0)) * prof.faces()[0],
                  cu1 - cu0 - 2 * HB_R_COL - 1.0,
                  dir=(1, 0, 0))
    b = _solid(b + led).clean()

    def flat_at(e, z):
        bb = e.bounding_box()
        return abs(bb.min.Z - z) < 1e-3 and abs(bb.max.Z - z) < 1e-3

    def in_col(e):
        return cu0 - 1e-3 <= e.center().X <= cu1 + 1e-3 and cv0 - 0.2 <= e.center().Y <= cv1 + 1e-3
    base_top = [e for e in b.edges() if flat_at(e, zb) and not in_col(e)]
    b = b.fillet(HB_R_BASE_TOP, base_top)
    top = [e for e in b.edges() if abs(e.bounding_box().min.Z - HB_COL_TOP) < 1e-3
           and abs(e.bounding_box().max.Z - HB_COL_TOP) < 1e-3]
    b = b.fillet(HB_R_COL, top)
    try:
        b = b.fillet(PRINTED["fillet_inside"], [e for e in b.edges() if flat_at(e, zb) and in_col(e)])
    except ValueError:
        pass
    ledge = [e for e in b.edges() if e.center().Y < cv0 - 1e-3 and KY_Z0 - 2.0 - cv0 - 0.1 < e.center().Z < KY_Z0 + 0.1
             and e.center().Z > zb + 1]
    for rr in (HB_R_LEDGE, HB_R_LEDGE / 2):
        try:
            b = b.fillet(rr, ledge)
            break
        except ValueError:
            continue
    b = _finish_print(b, "-Z", outer=HB_R_COL, inner=0.0)     # base top edges R 2, ledge edges, bed chamfer
    for u, v in HB_HOLES:
        b = b - Cylinder(1.7, 40).moved(Location((u, v, 0)))
    hu, hz = KY_U0 + KY_HOLE[0], KY_Z0 + KY_HOLE[1]
    b = b - (Plane(origin=(hu, cv0 - 0.01, hz), x_dir=(1, 0, 0), z_dir=(0, 1, 0)) *
             Cylinder(HB_INSERT_D / 2, HB_INSERT_L, align=(Align.CENTER, Align.CENTER, Align.MIN)))
    return _solid(b).moved(loc)


def _hall_board():
    """KY-003 board + the A3144 in the hall frame. Returns [pcb, sensor (TO-92 + leads)]."""
    ur, vt = _hall_frame()
    loc = _location(np.column_stack([ur, vt, [0, 0, 1]]), (0, 0, 0))
    pcb = _box(KY_U0, KY_U0 + KY_W, 0.0, KY_T, KY_Z0, KY_Z1)
    hu, hz = KY_U0 + KY_HOLE[0], KY_Z0 + KY_HOLE[1]
    pcb = pcb - (Plane(origin=(hu, -1, hz), x_dir=(1, 0, 0), z_dir=(0, 1, 0)) *
                 Cylinder(1.6, 5, align=(Align.CENTER, Align.CENTER, Align.MIN)))
    tw, tl, tt = TO92
    z0 = KY_Z1 + 0.48
    body = _box(SENSOR_U - tl / 2, SENSOR_U + tl / 2, KY_T / 2 - tw / 2, KY_T / 2 + tw / 2, z0, z0 + tt)
    leads = _box(SENSOR_U - 0.5, SENSOR_U + 0.5, KY_T / 2 - 1.5, KY_T / 2 + 1.5, KY_Z1 - 0.01, z0 + 0.01)
    return [_solid(pcb).moved(loc), _solid(body + leads).moved(loc)]


# ------------------------------------------------------------------ S1 printed parts

def _cam_frame():
    a = np.array(OPTICAL_AXIS, float)
    a /= np.linalg.norm(a)
    t = np.array([a[2], 0.0, -a[0]])
    p0 = np.array(LENS) - a * CAM_STACK
    return a, t, p0


BR_LUG_R = 5.7                              # corner lugs round the four S1.16 screws: 7.4 counterbore + 2 wall
BR_R_SADDLE = 4.0                           # saddle top corners (YZ section) and the X-end plan corners
BR_R_COLLAR = 4.0                           # collar (47 square) corner radius
BR_X_NEG = 44.0                             # saddle -X end 44 from the bank centre (the +X end stays 40): the 30 deg
#                                             collar's foot reaches x -39.6 at the top plate, so the plate runs past it


def _camera_bridge():
    """fp9_camera_wedge_bridge (PETG), the camera mount: the only printed rotor part, one body. Justification: one
    saddle that straddles the power bank lying flat on the axis, holds it down (top plate + two snap lips over its long
    top edges) and carries the 30 deg camera seat for the 36 x 36 board with four M2 inserts; no sheet or vendor part
    does both.
    Reference: printed camera mounts with a rounded saddle (GoPro-style cradles, Arducam case collars): one rounded
    U-section, round lugs at the screws, a rounded collar that follows the board; every edge blended (DL7).
    I028 (2026-10-21, "not sure how it got so high? looks like it's in a weird spot"): the I018 riser that stood the
    collar 40 above the top plate is gone; the collar seats straight on the top plate as a wedge (lens 48 above the
    disc, camsim at the 140 tube: top disc 99 %, disc frog 65 %, wall frog 63 %, 6.8 / 9.7 px/mm), its -X foot cut
    flush with the saddle's -X end so nothing leans past the saddle, and the four screws come up from under the disc
    into heat-set inserts, so no driver bore cuts the wedge or the lug tops.
    Form: the saddle is one inverted-U section (cheeks |y| 22.9..31.5 about the bank centre line, top plate Z 74.4..77.4,
    the snap lips 1.2 x 1.5 under the plate with an R 0.6 nose) with R 4 top corners, extruded x -44..40 about the bank
    centre with R 4 plan corners; four round lugs R 5.7 at the screws (clipped at the cheeks' inner faces, so the bank
    space is untouched) up to Z 72.9, solid, with a 4.1 x 6 insert pocket from the bed face; the collar (57 square,
    R 4 corners) runs along the optical axis from the top plate to 7.8 in front of the board and is the camera seat
    itself. Every outside edge R 2 (R 1 on the collar rim) by cadkit finish().
    Print orientation: flat on the cheek and lug feet (the disc face, -Z) on the bed, collar up; the top plate spans
    the bank as a 45 bridge, the collar's 30 deg lean is self-supporting; 0.5 bed chamfer.
    Kept exactly: the lens on the axis 48 above the disc (0, 0, 99), the 30 deg tilt, the board plane and its four M2
    insert pockets on 28.5, the 52.4 ring-light recess 4.3 in front of the board, the 25 ribbon slot, the snap lips.
    Hole pattern (S1.16): (+-34, +-27.2) about the bank centre (4.0, -3.1), M3 heat-set inserts 4.1 x 6 from the disc
    face (M3 x 10 button up through the 3.4 disc holes)."""
    from build123d import Polygon, RectangleRounded
    a, t, p0 = _cam_frame()
    z0 = DRUM_FLOOR
    yi, yo = BR_CHEEK_Y
    ox, oy = BANK_OFF
    zl = BR_TOP_Z0 - 1.5
    # saddle: inverted-U section with the snap lips (local x = Y about the bank centre, local y = Z), along +X
    sec = Polygon((-yo, z0), (-yi, z0), (-yi, zl), (-yi + BR_LIP, zl), (-yi + BR_LIP, BR_TOP_Z0),
                  (yi - BR_LIP, BR_TOP_Z0), (yi - BR_LIP, zl), (yi, zl), (yi, z0), (yo, z0), (yo, BR_TOP_Z1),
                  (-yo, BR_TOP_Z1), align=None).faces()[0]
    sec = sec.fillet_2d(BR_R_SADDLE, [q for q in sec.vertices() if abs(q.Y - BR_TOP_Z1) < 1e-6])
    sec = sec.fillet_2d(0.6, [q for q in sec.vertices() if abs(q.Y - zl) < 1e-6 and abs(abs(q.X) - (yi - BR_LIP)) < 1e-6])
    x0, x1 = ox - BR_X_NEG, ox + BR_X
    sad = extrude(Plane(origin=(x0, oy, 0), x_dir=(0, 1, 0), z_dir=(1, 0, 0)) * sec, x1 - x0, dir=(1, 0, 0))
    plan = extrude(RectangleRounded(x1 - x0, 2 * yo, BR_R_SADDLE).moved(Location(((x0 + x1) / 2, oy, z0 - 1))),
                   BR_TOP_Z1 - z0 + 2)
    s = _solid(sad & plan)
    ends = [e for e in s.edges() if min(abs(e.bounding_box().min.X - x0), abs(e.bounding_box().max.X - x1)) < 1e-3
            and abs(e.bounding_box().max.X - e.bounding_box().min.X) < 1e-3 and e.bounding_box().max.Z > z0 + 1e-3]
    for rr in (PRINTED["fillet_outside_min"], 1.5, 1.0):        # the X-end faces' outline (top, underside, lips)
        try:
            s = _solid(s.fillet(rr, ends))
            break
        except ValueError:
            continue
    s = _finish_print(s, "-Z", outer=PRINTED["fillet_outside_min"])
    lug_top = BR_TOP_Z1 - BR_R_SADDLE - 0.5
    for x, y in BR_SCREWS:                                     # round lugs at the four screws, outside the bank space
        sy = 1 if y > oy else -1
        lug = Cylinder(BR_LUG_R, lug_top - z0, align=(Align.CENTER, Align.CENTER, Align.MIN)).moved(Location((x, y, z0)))
        y_in = oy + sy * yi
        lug = lug & _box(x - 10, x + 10, *sorted((y_in, y_in + sy * 20)), z0 - 1, lug_top + 1)
        # foot=0: the lug's own bed chamfer met the saddle's chamfer on the cheek face in two BSPLINE slivers that
        # the mesher could not triangulate (the bridge vanished in renders, I013); the final finish chamfers the bed
        s = s + _finish_print(lug, "-Z", outer=PRINTED["fillet_outside_min"], foot=0.0)
    # S1.29 collar: a 47 square (R 4) prism along the optical axis from the top plate up to 5.9 in front of the board
    # underside plane, pocketed 37 square for the camera board, with the 45 recess the WS2812 ring board sits in
    # (floor 4.3 in front of the board underside) and a 25 wide slot in its +Y wall for the camera ribbon.
    cf = Plane(origin=tuple(p0), x_dir=tuple(t), z_dir=tuple(a))
    top = LEDR_Z + LEDR_RECESS_DEPTH
    col = cf * extrude(RectangleRounded(COLLAR_OUT, COLLAR_OUT, BR_R_COLLAR).moved(Location((0, 0, -60.0))), top + 60.0)
    zc = BR_TOP_Z1                                           # collar foot: on the saddle's top plate (I028)
    col = col & _box(x0 + 0.01, 200, -200, 200, zc - 0.01, 300)   # I028: the wedge's -X foot stops at the saddle end
    col = col - cf * Box(COLLAR_IN, COLLAR_IN, 20, align=(Align.CENTER, Align.CENTER, Align.MIN))
    col = col - cf * Box(25.0, 20.0, 20, align=(Align.CENTER, Align.MIN, Align.MIN)).moved(Location((0, 15.0, 0)))
    col = _finish_print(col, None, outer=1.0)
    # I032: the 45 recess is cut after the collar finish; its rim meets the ribbon slot walls 0.2 past the pocket
    # wall, and filleting that sliver crashes OCCT's fillet builder (segfault), so the recess rim stays sharp here
    col = col - cf * Cylinder(LEDR_RECESS_D / 2, 20, align=(Align.CENTER, Align.CENTER, Align.MIN)).moved(
        Location((0, 0, LEDR_Z)))
    s = _solid(s + col).clean()
    for x, y in BR_SCREWS:                                     # I028: M3 heat-set pockets from the bed face (screws come
        s = s - Cylinder(BR_INSERT_D / 2, BR_INSERT_L, align=(Align.CENTER, Align.CENTER, Align.MIN)).moved(
            Location((x, y, z0 - 0.01)))                       # up through the disc), so no driver bore cuts the wedge
    v = np.array([0.0, 1.0, 0.0])
    hp = CAM_HOLE_PITCH / 2
    for su in (-1, 1):
        for sv in (-1, 1):
            c = p0 + t * su * hp + v * sv * hp
            s = s - Plane(origin=tuple(c + a * 0.5), x_dir=tuple(t), z_dir=tuple(-a)) * Cylinder(
                1.6, 4.5, align=(Align.CENTER, Align.CENTER, Align.MIN))       # M2 heat-set pocket 3.2
    return _finish_print(s, "-Z", outer=PRINTED["fillet_outside_min"])   # anything the unions left sharp


def _charge_port():
    """Adafruit 6069 class round USB-C panel mount: 19 flange under the disc, 12 body through the 6 mm disc,
    14 nut on the disc top, cable boot. Panel underside at z 0."""
    from build123d import RectangleRounded
    fl = Cylinder(PORT_FLANGE_D / 2, PORT_FLANGE_T, align=(Align.CENTER, Align.CENTER, Align.MAX))
    body = Cylinder(PORT_BODY_D / 2, DISC_T + 8.0, align=(Align.CENTER, Align.CENTER, Align.MIN))
    nut = Cylinder(PORT_NUT_D / 2, PORT_NUT_T, align=(Align.CENTER, Align.CENTER, Align.MIN)).moved(
        Location((0, 0, DISC_T)))
    boot = Cylinder(3.5, 10.0, align=(Align.CENTER, Align.CENTER, Align.MIN)).moved(Location((0, 0, DISC_T + 8.0)))
    s = fl + body + nut + boot
    s = s - extrude(Plane(origin=(0, 0, -PORT_FLANGE_T - 0.1)) * RectangleRounded(8.94, 3.26, 1.6), amount=6.5)
    return _solid(s)


def _power_switch():
    """TRU Components LAS4GQH-11 latching pushbutton (Conrad 1661896), from its data-sheet drawing: 14 dia x 3.2
    stainless head with a 7.4 button 0.6 proud, M12 x 1 threaded body (drawn at 12.0) 36.35 behind the head, a
    hex nut 16.2 across corners x 2.0 (thickness assumed), three 0.65 solder tabs. Local: panel underside at z 0,
    head below (facing -Z), body up through the panel; the nut goes on at z = nut_z."""
    from build123d import RegularPolygon
    head = Cylinder(SW_HEAD_D / 2, SW_HEAD_T, align=(Align.CENTER, Align.CENTER, Align.MAX))
    btn = Cylinder(SW_BTN_D / 2, 0.6, align=(Align.CENTER, Align.CENTER, Align.MAX)).moved(Location((0, 0, -SW_HEAD_T)))
    body = Cylinder(SW_THREAD_D / 2 - 0.02, SW_BODY_L - 5.0, align=(Align.CENTER, Align.CENTER, Align.MIN))
    tail = Cylinder(5.0, 5.0, align=(Align.CENTER, Align.CENTER, Align.MIN)).moved(Location((0, 0, SW_BODY_L - 5.0)))
    s = head + btn + body + tail
    for x in (-2.5, 0.0, 2.5):
        s = s + Box(0.65, 2.0, 4.0, align=(Align.CENTER, Align.CENTER, Align.MIN)).moved(Location((x, 0, SW_BODY_L)))
    nut = extrude(RegularPolygon(SW_NUT_AC / 2, 6, rotation=30.0), amount=SW_NUT_T) - Cylinder(SW_THREAD_D / 2, 10)
    nut = nut.moved(Location((0, 0, DISC_T)))                  # flats across the radius (14.0 radial)
    return _solid(s), _solid(nut)


R_MOTOR19 = np.array([[-1.0, 0, 0], [0, 0, 1.0], [0, 1.0, 0]])   # STEP local +Y (shaft) -> world +Z, local -Z (cable
#                                                                 exit) -> world -Y, local X -> world -X


@lru_cache(maxsize=None)
def _motor_src():
    """STEPPERONLINE 17HS19-2004D-E1K (vendor STEP 17HS19-2004D-E1K.STEP; drawing 17HS19-2004D-E1K_Dimension.svg:
    42.3 square, 67 +-1 long with the 20 +-1 encoder, 22 x 2 boss, shaft 5 x 24 with a 15 D-cut, 4 x M3 x 4.5 deep on
    31). STEP frame: axis local +Y, mounting face Y 0, boss to Y 2, encoder cover to Y -68.0, rear screw heads to
    -68.5, cable-exit block on the local -Z side. The two cables are drawn as straight stubs out to local Z -74: the
    flexible cables beyond the 9.6 cable-exit block (local Z < -31) are dropped. The shaft is its own solid so it can turn.
    Returns (body solids, shaft solid) in source coordinates."""
    sols = _step_solids(MOTOR_STEP)

    def is_shaft(q):
        b = q.bounding_box()
        return max(abs(b.min.X), abs(b.max.X), abs(b.min.Z), abs(b.max.Z)) <= 2.51 and b.max.Y > 20
    shaft = next(q for q in sols if is_shaft(q))
    keep = _box(-21.2, 21.2, -69.0, 2.1, -31.0, 21.2)
    kb = keep.bounding_box()
    body = []
    for q in sols:
        if q is shaft:
            continue
        b = q.bounding_box()
        if b.min.X >= kb.min.X and b.max.X <= kb.max.X and b.min.Y >= kb.min.Y and b.max.Y <= kb.max.Y and \
                b.min.Z >= kb.min.Z and b.max.Z <= kb.max.Z:
            body.append(q)
        elif b.max.Z > kb.min.Z and b.min.Z < kb.max.Z:
            body.extend((q & keep).solids())
    # the STEP's four M3 holes stop 3.75 deep; the drawing says DEPTH 4.5: tap-drill them to the drawing depth
    for i, q in enumerate(body):
        b = q.bounding_box()
        if b.max.Y > -0.5 and b.min.Y < -5.0 and b.max.X > 15:          # the front end cap carrying the holes
            for hx, hz in ((15.5, 15.5), (15.5, -15.5), (-15.5, 15.5), (-15.5, -15.5)):
                q = q - (Plane(origin=(hx, 0.01, hz), z_dir=(0, -1, 0)) *
                         Cylinder(1.25, 4.51, align=(Align.CENTER, Align.CENTER, Align.MIN)))
            body[i] = _solid(q)
    return body, shaft


def drive_cartridge(A):
    """Names of every body in the S1.26 cartridge (its parts plus the fasteners made on the bench)."""
    core = [*BD.RETAINER_NAMES, MOTOR, "v_nema17_shaft", PLATE, *SPACER_NAMES, *EXTRA_SPACER_NAMES, *BD.PART_NAMES, "lp_plate_a",
            "v_gobilda_1614_pillow_block", "v_gobilda_1614_bearing_lower", "v_gobilda_1614_bearing_upper",
            "v_gobilda_rex_shaft_2106_72", "v_gobilda_1313_hub",
            *RBLOCK_NAMES, *ROLLER_NAMES, *AXLE_SPACER_NAMES, "fp9_hall_bracket", "v_index_hall_ky003"]
    hw = [n for n, p in A.parts.items()
          if str(p.meta.get("joint", "")).startswith(("j_s1_1_", "j_s1_2_", "j_s1_5_", "j_s1_27_", "j_s1_31_", "j_s1_6_", "j_s1_33_"))]
    return [n for n in core if n in A.parts] + hw


def _drive(A):
    """S1.26 drive-base cartridge: motor plate (with the offset motor and its direct pulley) hung under plate A on four
    spacers, plate A carrying the pillow block, REX shaft, race spacer + shims and REX pulley; built and spun on the bench,
    dropped through the S2.5 deck opening and held by the four S1.4 screws only."""
    body, shaft = _motor_src()
    loc = _location(BD.rz(BD.MOTOR_ANGLE) @ R_MOTOR19, (*BD.MOTOR_XY, MOTOR_FACE_Z))
    A.add(MOTOR, Compound(children=[copy.deepcopy(q).moved(loc) for q in body]), "motor", "drive_base", step=1,
          note=f"STEPPERONLINE 17HS19-2004D-E1K closed-loop motor, 52 Ncm (73.64 oz.in) with 1000 PPR encoder (vendor "
               f"STEP), face on the printed slab's pocket roof Z {MOTOR_FACE_Z:g} (I037, 2.5 under V12), uncut 24 mm shaft, turned {BD.MOTOR_ANGLE:g} deg about its axis so the lead glands face +Y, away from the spindle")
    A.add("v_nema17_shaft", copy.deepcopy(shaft).moved(loc), "shaft", "drive_base", step=1, spins=True, spin_origin=(*BD.MOTOR_XY, 0),
          note="motor shaft (vendor STEP, uncut), 5 with a 15 D-cut, tip Z %.2f in the direct 5 mm bore motor pulley" % MOTOR_SHAFT_TIP)
    A.vendor.append(V.vendor_entry(MOTOR, MOTOR_DIR))
    A.add(PLATE, MP.build(), "printed", "drive_base", step=1,
          note=f"PETG 12 mm one-piece motor plate slab with four rail tabs (I037), Z {MP.Z_BOT:g}..{MP.Z_TOP:g}, motor pocket "
               f"from below (face Z {MP.MOTOR_FACE_Z:g}, {MP.ROOF_T:g} roof), tabs flush on the cross rails' undersides; all of "
               f"the aluminium plate's openings kept (24 spindle hole, I035 {MPLATE_BELT_SLOT_W:g} wide belt channel, 24 "
               "pilot slot, 3.4 motor slots, 5.5 spacer holes); printed top face down, no supports; justification in "
               "parts/fp9_motor_plate.py")
    for nm, (x, y) in zip(SPACER_NAMES, SPACER_XY):
        A.add(nm, HW.ring(SPACER_OD, SPACER_ID, SPACER_L, nm).moved(Location((x, y, MPLATE_Z1))), "standoff",
              "drive_base", step=2, note="RAF M0669-5-AL aluminium round spacer 10 OD x 5.3 ID x 20 (S1.1)")
        A.vendor.append(V.vendor_entry(nm, "hardware/raf_m0669_5_al_spacer"))
    for nm, (x, y) in zip(EXTRA_SPACER_NAMES, SPACER_XY):                              # I037: under the 20 mm spacers
        A.add(nm, HW.ring(SPACER_OD, 5.0, EXTRA_SPACER_T, nm).moved(Location((x, y, MP.Z_TOP))), "standoff",
              "drive_base", step=2, note="Stock aluminium spacer 5 ID / 10 OD / 3 under the 20 mm spacer (the ICD-V12 deck "
                                         "hardpoint part): the printed slab's top is at Z -20, 3 under the old plate top")
        A.vendor.append(dict(component=nm, source_url="https://www.filastruder.com/products/m5-spacers-3mm-tall-10mm-od",
                             author="Filastruder dimensions", file="assemblies/froggy_v12_5.py:_drive",
                             licence=None, price_usd=.398))
    BD.add(A)  # V12 S1.3: complete toothed pulleys and closed-loop belt
    A.add("lp_plate_a", _plate_a(), "plate", "drive_base", step=2,
          note=f"laser part, 6061 {PLATE_T} plate 120 x 120 on the deck sheet, the cartridge base plate (ICD S1.4, S1.5, "
               "S1.26)")
    housing, lower, upper, c = _block_parts()
    loc = _axial_loc(c, BLOCK_Z0)
    A.add("v_gobilda_1614_pillow_block", copy.deepcopy(housing).moved(loc), "bearing", "drive_base", step=2,
          includes="goBILDA 1614-0016-4008 dual-bearing pillow block housing (vendor STEP), M4 tapped 16 mm pattern")
    A.vendor.append(V.vendor_entry("v_gobilda_1614_pillow_block", VM + "gobilda_1614_pillow_block"))
    for nm, grp in (("v_gobilda_1614_bearing_lower", lower), ("v_gobilda_1614_bearing_upper", upper)):
        A.add(nm, Compound(children=[copy.deepcopy(s).moved(loc) for s in grp]), "bearing", "drive_base", step=2,
              spins=True, includes="the block's REX-bore ball bearing and its shields (vendor STEP)")
    sh, sc = _shaft_src()
    A.add("v_gobilda_rex_shaft_2106_72", copy.deepcopy(sh).moved(_axial_loc(sc, SHAFT_Z0)), "shaft", "rotor", step=2,
          includes=f"goBILDA 2106-4008-0720 REX shaft 8 x 72, Z {SHAFT_Z0:g}..{SHAFT_Z1:g}")
    A.vendor.append(V.vendor_entry("v_gobilda_rex_shaft_2106_72", VM + "gobilda_2106_rex_shaft_72"))
    BD.add_retainers(A)
    for k, az in enumerate(ROLLER_ANG):                                               # S1.27 rim rollers
        A.add(RBLOCK_NAMES[k], _roller_block(az), "printed", "drive_base", step=2,
              note=f"PETG rim-roller block at {az:g} deg on plate A's arm: axle slot + pinch guard (S1.27); "
                   "justification in its builder docstring")
        rn = ROLLER_NAMES[k]
        A.add(rn, Compound(children=_roller(az)), "bearing", "drive_base", step=4,
              bodies=[(f"{rn}_body_{i}", "pom_black" if i==0 else "steel_bearing") for i in range(30)],
              includes=f"Creality standard Ender POM wheel kit: two 625 bearings and 1 mm internal shim; flat tread at R{ROLLER_R:g}, Z45")
        A.vendor.append(V.vendor_entry(rn, "motion/creality_ender_vwheel"))
        A.add(AXLE_SPACER_NAMES[k], _axle_spacer(az), "standoff", "drive_base", step=4,
              note="Steel precision shim 5 ID x 10 OD x 1; between bearing inner race and support wall")
        jn = f"j_s1_27_axle_{k + 1}"
        for nm, kind, sol in zip((f"hw_m5x25_shcs_{jn}", f"hw_washer_m5_{jn}", f"hw_nyloc_m5_{jn}"),
                                 ("screw", "washer", "nut"), _axle_hw(az)):
            A.add(nm, sol, kind, "drive_base", step=4, joint=jn,
                  note="M5x25 axle head outboard; 5/10/1 precision washer each side; M5 nyloc inboard. Internal 1 mm shim included in wheel kit.")



def _hall(A):
    """S1.31: the stationary index sensor on plate A (part of the S1.26 cartridge)."""
    A.add("fp9_hall_bracket", _hall_bracket(), "printed", "drive_base", step=2,
          note=f"PETG hall bracket on plate A's corner at {HALL_AZ:g} deg (S1.31); justification in its builder docstring")
    pcb, sen = _hall_board()
    A.add("v_index_hall_ky003", Compound(children=[pcb, sen]), "sensor", "drive_base", step=2,
          bodies=[("v_index_hall_ky003_breakout", "pcb_green"), ("v_index_hall_ky003_a3144", "black_plastic")],
          note=f"Joy-it SEN-KY003HMS (A3144 hall switch breakout) on edge, sensing face {HALL_GAP:g} under the disc at "
               f"r {SENSOR_U:g}, {HALL_AZ:g} deg, under the index magnet circle (S1.31)")
    A.vendor.append(V.vendor_entry("v_index_hall_ky003", "electronics/hall_ky003_joyit"))
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
