partypancake8/froggy-control/(commit log)

2026-10-26 Publish Froggy motor and Pi tools with portable configuration and privacy review
2026-11-04 Add V12.5 model, viewer, exports and simulation parameters
    model/cad is the trimmed froggy-cad tree (commit 357616d) that builds
    froggy_v12_5 headlessly and serves the web viewer, with cadkit vendored
    and only the vendor STEP/STL files the build loads. model/exports holds
    the GLB, a p-curve-free STEP under GitHub's file limit, the STL, design
    check and camera-simulation renders. model/sim-params.json collects
    rotor, drum, camera, motor, drive, frog and target numbers with units.
    docs/SIMULATION.md explains how to rebuild, view and simulate.
2026-11-10 Port CL57T closed-loop motor control, HMI page and trial logging
    Moves the motor code from the open-loop DM320T to the STEPPERONLINE
    CL57T-V41 closed-loop driver with the 17HS19-2004D-E1K motor on 24 V.
    - froggy_motor.py reads the driver ALM output (GPIO 22, divider) and a
    tap on the encoder EA+ line (GPIO 5) for real shaft RPM, adds cl-test,
    a per-trial store (one gzip record per actuation) with trials
    list/export/prune, and serves the new ui/ page
    - motor.toml is the CL57T bench config: new pin map, 1/16 microstep,
    enc_ppr 1000, ENA active low, ALM blocks start, no camera, trial caps
    - motor/ui is the new HMI page with live RPM chart, closed-loop tile and
    CSV and PDF export of a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
