partypancake8/froggy-control/(notices)

Notices in the files:
model/cad/assemblies/froggy_v12_5.py:
www.accu.co.uk/countersunk-socket-head-screws/5448-SSK-M4-12-A2',author='Accu dimensions; conservative envelope',file='assemblies/froggy_v12.py:_hub_screw_envelope',licence=None,price_usd=None))
